ikorb/gcvideo/(threads)

Thread 2 (2016-08-17):

DOL-101

ManuPerezBelmonte, 2016-08-17:
Sorry for contacting you that way, I didn't another way how to contact you.
I've been checking everything in your repo and first of all, it's genius. However I saw that it's not possible to use a DOL-101 version, did you find something new regarding this model? or it was impossible for you to try it? As the boards come already programmed I don't know if I should still need to program something or even if there is going to be a way to use it on the DOL-101.

ikorb, 2016-08-17:
Sorry for hiding the 98 copies of my email address in the repository so well.

The DOL-101 is missing the external digital video port, but I suspect that all required signals are still present on the board. You would need to wire the FPGA board directly to the AV encoder chip and find a different source for the 54MHz clock signal somewhere on the board - I heard that it exists, but I don't know where.

Closed 2016-08-17.

Thread 3 (2016-09-20):

Unable to access OSD

bsbarham, 2016-09-20:
I purchased a Pluto-IIx XC3S200 HDMI board pre flashed with gcvideo 2.2. I am displaying video just fine, but the designated button combo is not bringing up the OSD. I have checked and re-checked the controller solder point and everything looks good. When contacting the supplier they are suggesting an issue with gcvideo 2.2 (see forum post below). Has something changed with the install? I am also including a picture of the controller solder point for verification. I apologize for the quality.

Thank you,

KNJN forum post: http://www.knjn.com/phpbb/viewforum.php?f=2
Youtube thread with others with same issue: https://www.youtube.com/watch?v=5Hw_XQdugI4

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

ikorb, 2016-09-20:
As far as I can tell yet, it is an issue where the OSD CPU crashes during initialisation and it does not appear with every install - e.g. my development setup was unaffected, so I did not catch it before release. I finally managed to reproduce it yesterday and I'm working on a fix.

ikorb, 2016-09-20:
Found it, should be fixed in version 2.3

Closed 2016-09-20.

Thread 5 (2016-12-31):

Controller not working

rimsky82, 2016-12-31:
Everything seems to be installed correctly, as the video through HDMI looks great (Pluto board from knjn.com).  However, when I have 94 connected for the controller, the controller in port 1 doesn't work at all.  If I disconnect 94, controller port 1 works again.

I have soldered to this point twice, both times with the same result.  Any ideas?

ikorb, 2016-12-31:
Likely a wrong bitstream or the wrong pin on the FPGA side - most FPGA pins have pullups or pulldowns enabled and these overpower the controller signal on the Gamecube side.

rimsky82, 2017-01-15:
Yup, it was my fault.  Had 94 and ground switched.  All hooked up and enjoying HD goodness.

Closed 2016-12-31.

Thread 6 (2017-01-04):

No native 480p ?

idtjes3, 2017-01-04:
Hello. I purchased a Pluto-II ( Rev C) with gcvideo installed. Everything appears to be working fine (audio, 480i video+LD, OSD), but I cannot get native 480p games to display in progressive scan. Games that require 'B' do not respond to the command and games that have the option in the menus are greyed out. Have test on 3 different TVs with 2 different HDMI cables same results. I have also tried reflashing the board with the latest firmware. Thoughts on what to check?

ikorb, 2017-01-04:
There are two likely issues:
1) Other Settings -> Allow 480p mode is set to "no"
2) The wiring for the cable detect pin is missing or incorrect.

idtjes3, 2017-01-04:
Hello thanks for your response. I'm pretty sure 'allow 480p mode' is still on since the FAQ says to leave it alone. I will re double check the cable detect pin but last I checked with the multimeter I was getting a good connection. Is there a voltage range or anything like that on this pin I can use to verify a proper signal from the cube?

ikorb, 2017-01-04:
You should see around 3.3V on that pin, coming from the FPGA.

Closed 2017-01-04.

Thread 7 (2017-05-18):

HDMI-CEC support?

mkopec, 2017-05-18:
Hello,

Do you think it would be possible to add HDMI-CEC support? Adding it would enable using the TV's remote to control the OSD, which would be especially useful for external installations.

ikorb, 2017-05-18:
Technically it would be possible, but not on the current hardware platforms because the pin needed for CEC is not connected there. Also, as far as I know CEC has some electrical requirements that cannot be met with just a bare FPGA pin, so just soldering a wire to connect it would not be sufficient.

As far as I know there are some microcontrollers with CEC hardware support (e.g. some STM32F0/F1 chips), using one as a gateway between CEC and the FPGA might be possible. Unfortunately, I'm currently busy with other projects and do not have time to build something like this myself.

HACKER-3000, 2018-10-14:
do it urself and make a pull req!

GizmoTheGreen, 2020-01-14:
still kinda hoping for this. even if I'll have to solder in an STM32f board to the PlutoII as middleman

feenor, 2021-01-25:
Assuming ALLM is handled by CEC, that would be another great reason to support it. GCVideo devices would be ahead of the PS5 if they did ALLM.

Thread 9 (2017-05-28):

Sound?

Eire05, 2017-05-28:
Hello, Firstly thank you for the guide ... amazing. I followed it and have video working no problem. My issue is with sound and i do have enhanced dvi mode turned on...i notice that there is not connections for sound in the guide (except SPDIF) is there something i have missed. Really appreciate your help..Thanks

ikorb, 2017-05-28:
Did you connect the LRCK, AData abd BCLK signals?

Eire05, 2017-05-28:
Thank you so much for getting back to me. Yes I connected them to 98, 3, 4
as per the diagram......would that be where the issue is? I have it all hot
glued :(

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

ikorb, 2017-05-28:
These three signals are for sound, your description suggested to me that you might not have connected them.

If you have verified these three connections to be correct, try a different display and if possible, also try to check if you get sound via SPDIF.

Hot gluing stuff before it is verified working is usually not a good idea . You could try to apply some alcohol to the blobs of hot glue, it reduces the strength of the bond between the glue and the surface.

Eire05, 2017-05-28:
Thank you I'm going to check those points again to be sure

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

thekevbot, 2017-10-22:
I'm having the same problem – @Eire05 were your OSD settings not being saved too? Did you end up getting it working?

Eire05, 2017-10-22:
Hi Kevin. I did get it working after a third attempt. I recommend using
thicker 22-26 gauge wire and really check every single point five times :)
I was doing two backwards but works perfectly now

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

thekevbot, 2017-10-22:
Thanks @Eire05 – I got it working too. Used 24awg, solid wire.

MadnessUNC, 2017-12-21:
I’m having no sound issues. I did originally have 21 to 3 and 22 to 4 backwards, but it’s fixed now and still no sound. I’m using a pretty thick solid wire, but probably not quite 24 gauge. Could a thicker gauge possibly fix my issue?

MadnessUNC, 2017-12-21:
Now I’m more confused. I get sound when dvi is turned on. Am I missing something? There is not a lot of details on this. Any clarification is appreciated.

Eire05, 2017-12-21:
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
Ok so can’t think of the name right now but there is a setting you need to
have on in order for sound to be pushed through. Can anyone else think of
what that option is called? Maybe that will help

ikorb, 2017-12-21:
The setting is called "Enhanced DVI" and it's off by default because it is easier to turn on when you have no sound than to turn it off when you have no picture (which can happen with some displays).

Eire05, 2017-12-21:
Yep that’s it Igor

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

Eire05, 2017-12-21:
Fantastic glad it got you up and running

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

Closed 2017-12-21.

Thread 10 (2017-06-16):

How to wire a SCART connector

robcross, 2017-06-16:
I see that the RGB lines are directly from the DAC. Do I need to put 330 uF caps in the SCART head? Do I any other components in the SCART head for proper signals?

robcross, 2017-06-16:
For more clarification, I plan to build the gcvideo_lite_09 board and I would like to ensure the specifications are correct for the cable I want to purchase from retro_console_accessories.

ikorb, 2017-06-16:
The DAC outputs the usual 0.7Vpp into a 75 ohm impedance input with no DC offset (so no capacitors). The H and V sync outputs are 3V LVCMOS outputs, CSync is the same but with a 100 ohm series resistor and it should be able to drive a standard 75-ohm video input.

robcross, 2017-06-16:
Thank you! I'm still learning these things :+1:

robcross, 2017-06-27:
Hi @ikorb, I just wanted to say thanks! I just installed my board today and it works like a charm. Beautiful RGB output without breaking the bank!

Closed 2017-06-16.

Thread 11 (2017-10-12):

audio lag

Rx-R, 2017-10-12:
Hi, I installed a plutoIIx with 2.3 installed.  I am experiencing audio lag after a certain amount of time of gameplay.  upwards of 2 seconds delay.  I can then turn off enhanced dvi mode then turn it back on and the sound is in sync.  after about 10-20 min of gameplay the lag slowly creeps back again.  Is there something I can check or fix with my install?  I verified it is not the gamecube as when I run audio out of the analog port it is fine.  thanks for your help and your work.

ikorb, 2017-10-12:
The Gamecube has a slightly non-standard audio sample rate. GCVideo-DVI passes it to the display as-is, any audio lag you encounter comes from the display side. There isn't enough space left in the FPGA to properly resample the audio and just dropping/inserting samples creates an audible distortion.

Your install should be ok. As far as I know the slightly-off sample rate should still (barely) be within tolerances, but it seems you have a device that just doesn't like it.

Rx-R, 2017-10-13:
thanks for the explanation

Closed 2017-10-13.

Thread 12 (2017-10-16):

Board connected, but no video (solid red light) [Solved]

thekevbot, 2017-10-16:
I'm using a board from KNJN (Item 6117 from http://www.knjn.com/ShopBoards_RS232_Parallel.html) and have everything wired up according to the README, but I'm not getting any video signal when hooked up to my TV.

I've tried it with the 100 ohm resistor, and straight wired, but no dice. The red LEDs are not flashing, but they stay on solid – is that an indicator of something?

I've checked and double checked all the pins, and I've checked each for continuity, but still can't my TV to recognize the Gamecube. Anyone have any ideas of what to try next?

ikorb, 2017-10-16:
Non-flashing lights are an indication that something is wrong, for example the FPGA not completing its startup or not receiving all of the required signals from the Gamecube. In either case, the TV would not receive a signal.

thekevbot, 2017-10-16:
Got it, thanks for the reply! What should I check besides making sure all my connections are good and nothing is shorting out? Is it likely that it could be a bad board?

Fluoxi, 2017-10-18:
Hello, I am having the same problem! I don't know about you thekevbot but I am a total noob when it comes to soldering (I bought everything I needed just for this project). As of now my GC is naked, so no cover and even the cd loader thingie is off. I can still turn on the system and everything seems to power up. Also note I have not soldered the controller cable yet.

One thing that pops into my head might be the cables that I used to wire it all. They are 30 gauge (0,25mm) with loose strands of copper. While stripping I often had lose stray wires coming off, about 1 to 3. Is this a concern?

ikorb, 2017-10-18:
If you have some way of flashing the boards with 2.4, do so. It changes the LED blinking pattern to make it easier to differentiate between a few possible problems.

thekevbot, 2017-10-18:
Spoke with KNJN's support (they're super responsive and helpful btw) and they've been helping me with some troubleshooting. Basically, when you supply power with nothing else wired up, 1 LED should light up for 2 seconds and then turn off like this https://www.youtube.com/watch?v=CGaOvrQgl5A

This means the boot-PROM is working correctly and something else is the issue. The stranded wire can work, but it's harder to work with.

Make sure you don't have any shorts before powering on if you leave your wires connected to the GC digital port.

Fluoxi, 2017-10-18:
Funny I contacted the same people and they told me the exact same thing just a few minutes ago...

Fluoxi, 2017-10-19:
No red light using your method. I bought some hardwire today going to try that out.

Fluoxi, 2017-10-19:
No success, same issue. I did however notice a second red light that turns on when a hdmi cable is connected. Even the tv recognizes something but tells me there's no signal.

Any progress on your end?

thekevbot, 2017-10-21:
No progress here yet either. I'm going to try with some solid wire, without desoldering the digital port first and see how that goes.

thekevbot, 2017-10-22:
Alright, so I switched over to a solid wire, and wired everything really carefully... it works! Well, it _worked_... at some point during testing and putting the cube back together, I seem to have lost sound.

Also, the OSD doesn't seem to be able to save settings after turning off the gc. Anyone know why that might not be working?

thekevbot, 2017-10-22:
Success!  (sorry for all the posting, but hopefully this will help others). [This issue](https://github.com/ikorb/gcvideo/issues/9) suggested that one of the sound signal wires wasn't connected, and sure enough, one wasn't.

Okay, so my findings:

- I had issues, each time I tried using stranded wire. It's just too easy to create shorts.
- I used solid hookup wire, 24 gauge. It works, but it's a bit stiff. I'm going to try 28 gauge on the next one.
- Test your connections with the DVD drive disconnected. If it works, only THEN hotglue your connections, and then put the drive back on. I tested again at this point to make sure I didn't jangle any connections.

Also, for a nice clean install, there's a 3d printed mount available and it works GREAT. [Link to the file here](https://www.thingiverse.com/thing:2332094). I had mine printed at Shapeways.

Fluoxi, 2017-10-22:
Do you have several motherboards? In the video it shows the digital port removed. Did you not remove the digital port on your successful try?

thekevbot, 2017-10-22:
No, I used the same mobo and the port is desoldered.

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

Closed 2017-12-21.

Thread 14 (2017-12-29):

Video but no sound.

seniorcelica, 2017-12-29:
I have a picture and it looks amazing!   But no audio.  I've turned dvi on and tried the origina svideo and av cord.  I did have sound before the install.  Thanks in advance :)

MadnessUNC, 2018-02-16:
Did you figure it out? Make sure 21 -> 3 and 22-> 4 which is kind of a curve ball vs how the rest of the numbering goes

seniorcelica, 2018-02-17:
Ya.  Turns out I had a defective soldering iron and burnt traces....  sounds noobish and kind is but ruined the the hd port.  Might do a trace repair but can get another for like 30.  So installed the Pluto in another gc2 and worked fine.  Got 2 more tonight in the mail.  And have a new iron lol

Sent from my Samsung Galaxy smartphone.

-------- Original message --------
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

MadnessUNC, 2018-02-17:
I know for myself that the traces under the digital port are very delicate. Live and learn! Also, “repair” gc’s are typically $15 and usually just need cleaning. It’s a gamble though

Thread 15 (2018-01-23):

Get the gcvideo-dvi-p2xh-gc-2.3.bit

Hawkeye92, 2018-01-23:
Hi, firstly congratulation for your great job

I receive my Pluto board but I cannot get it to work.
All my connections are goods, double checked.
When I turn on the console, one LED blink but the another LED still ON without any blinking, so in your readme you say that the board is probably not programmed.
Maybe my board isn't programmed, so I would like to get the file "gcvideo-dvi-p2xh-gc-2.3.bit" but I can't find it, there is no bin subdirectory.
Can you upload it ?

ikorb, 2018-01-23:
https://github.com/ikorb/gcvideo/releases

Closed 2018-01-23.

Thread 16 (2018-03-11):

CDK3404 Has Been Discontinued

CryCic4da, 2018-03-11:
The CDK3404 has been discontinued and is no longer available. What are the alternatives and will there be any updates to the GCVideo Lite files in terms of updated PCB with the replacement part in the BOM?

ikorb, 2018-03-11:
I have not investigated alternative DACs at this point.

Closed 2018-03-11.

Thread 23 (2019-12-22):

DDC resistor

jeanh17, 2019-12-22:
The latest Pluto-IIx HDMI has the 100ohm resistor to power the DDC HDMI line.
https://www.knjn.com/docs/Pluto-IIx%20HDMI%20rev.%20E.pdf

The description could be updated to mention it and avoid confusion.

ikorb, 2019-12-22:
Thanks, I did not know that. I'll add a link to that document in the manual.

Closed 2019-12-22.

Thread 24 (2020-01-12):

FPGAconf does not support .bin files.

sbagneris, 2020-01-12:
FPGAconf explicitly wants .bit files to flash firmware onto a Pluto II board. This is no longer provided with the 3.0 release.

It is possible to rename the .bin file file to .bit file and FPGAconf will happily (foolishly?) flash the file onto the board but when booting the picture is now black and white and the following message is displayed:

"!!! Updater hardware ID is invalid !!!"
"--> YOU must choose the correct ID <--"
"Main firmware is missing"

A rotating cursor is displayed bellow and when pressing the z-button a hex dump of the ROM is displayed that can be navigated up and down the memory addresses.

Long live GCVideo!

ikorb, 2020-01-12:
It seems that FPGAconf is trying to remove a header from the "bitstream" file to get to the actual contents and the part it removed it small enough that the FPGA still boots. However, the flasher that starts first thinks that the main firmware is bad and starts its recovery mode instead of booting the main firmware.

Good thing I added that memory hex viewer for diagnosing problems like this. =) Run it, hit the X button (should jump to address 30000), take a picture, hit left on the D-Pad once (shoudl jump to 2ff80) and take another picture. With a bit of luck that should be enough to figure out how to build a pseudo .bit file that can be flashed with FPGAconf.

sbagneris, 2020-01-12:
You bet!

Note to anyone else reading that the Pluto board is not bricked when doing this. One can easily revert to 2.4d without harm.

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

ikorb, 2020-01-12:
Thanks!

Unfortunately FPGAconf did something completely against my expectations - instead of dropping the (nonexistant) .bit header, it added something, which shifts everything backwards instead of forwards. Could you take another screenshot from address 0?

sbagneris, 2020-01-12:
No problem.

I included the first two pages.

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

ikorb, 2020-01-12:
Thanks. The file below might work with FPGAconf. If it doesn't, I'll probably need a few days to dig out my own hardware to figure out a workaround.

[gcvideo-dvi-3.0-p2xhgc-fpgaconf.zip](https://github.com/ikorb/gcvideo/files/4051502/gcvideo-dvi-3.0-p2xhgc-fpgaconf.zip)

sbagneris, 2020-01-12:
Success!

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

ikorb, 2020-01-12:
Nice! Thanks for helping figure this out, I'll add a link to the release notes.

P2XH Wii fake bitstream in case someone actually uses it:
[gcvideo-dvi-3.0-p2xhwii-fpgaconf.zip](https://github.com/ikorb/gcvideo/files/4051549/gcvideo-dvi-3.0-p2xhwii-fpgaconf.zip)

sbagneris, 2020-01-12:
Thank you *very much*. I would have given you two thumbs up but I can’t quite levitate my camera yet. Most thing at first glance seems to function just fine. I’m excited for the built in firmware upgrade.

ikorb, 2020-01-12:
Actually the system is resilient enought that you could have used the 3.0 updater to install a working main firmware by manually selecting the correct board ID - but since you appeared to be a willing victim, I preferred to work out the problem so others can avoid it completely.

sbagneris, 2020-01-12:
By all means!

Tazberry, 2020-01-13:
@sbagneris what are you using to update ur pluto?

sbagneris, 2020-01-13:
I'm using the basic TXDI header from KNJN along with FPGAconf software that should have come along your purchase of the Pluto board. A judicious search online should net you a downloadable package for FPGAconf if you have lost the files. (it is not available on the KNJN website for some reason) or email KNJN for a link.

Tazberry, 2020-01-13:
@sbagneris Is it possible I can get a link to all this. Doing this for the first time.

GizmoTheGreen, 2020-01-14:
what are you using to connect to the TXDI header if you don't mind me asking? I've got a Sparkfun FTDI basic. put the TX in invert and been emailing KNJN. checking voltages on the TX RX lines etc but can't for the love of me program the thing.
it just times out! (still on 2.4c)

sbagneris, 2020-01-14:
I use a bog standard USB to serial adapter and I plug the TXDI header right into it.
This looks pretty identical to what I have:
https://www.amazon.com/Tripp-Lite-Keyspan-High-Speed-USA-19HS/dp/B0000VYJRY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

The specific TXDI header I use is the plain jane one without the RS232 chip built in ($6.95)
https://www.knjn.com/ShopAdapterBoardsTXDI.html

GizmoTheGreen, 2020-01-14:
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

thanks for your input. I've read that PDF and referenced it when I hooked up the FTDI.
as I mentioned I've been emailing KNJN and they say it looks correct but have no idea why I can't program the board.

I should probably make a new "issue" to try and get help with this here but for now I'll just share the pictures.

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

Closed 2020-01-12.

Thread 25 (2020-01-13):

3.0 does not appear to save settings

sbagneris, 2020-01-13:
I'm likely doing something wrong but it appears setting changes do not survive a power cycle of the console.

This happens of course despite explicitly calling "save configuration" in the menu.

The specific setting I'm attempting to make stick is the "Enhanced DVI" mode so that digital audio streams through the "HDMI" instead of having to use the analog out.

Not a big deal.

ikorb, 2020-01-13:
Actually it is a big deal because it could erase parts of the bitstream from the flash... Fixed in 3.0a.

sbagneris, 2020-01-13:
oooooh boy... and here I was mashing that "save configuration" button... Ignorance sometimes *isn't* bliss!
Thanks again for the lightning fixes!

GCVideo still kicking butts and taking names.

sbagneris, 2020-01-14:
Ok tried this updater thing! It works beautifully and all issues are confirmed fixed.

Launch straight from SWISS!
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

On reboot presented with pretty clear instructions.
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

Time to flash!
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

Here we go...
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

Flashing...
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

Auto reboot is nice...
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

I suppose you see this again if you want to flash it again on reboot?
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

Great success!
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

ikorb, 2020-01-14:
There is no feedback path from GCVideo back to the Gamecube that works on all hardware variations, so the updater doesn't know that it can exit and you get the noise screen back after GCVideo reboots.

dropdennisdead, 2025-01-23:
Hi, i have the same Problem as @sbagneris. When i start the gamecube i have no sound. when i turn on the enhanced dvi mode in the settings i get a sound but when i restart the console the settings are not saved. Do you have a version of the GC Video 3.1 where the enhanced dvi mode is always on? Thanks in advance!

Greetings
Dennis

ikorb, 2025-01-23:
The "Save does not save" bus has been fixed a few years ago already. Since you did not mention anything about trying to save settings, I'm going to assume that you forgot to do so and advise you to try that.

Closed 2020-01-13.

Thread 26 (2020-01-14):

Booting main firmware failed

Xaranar, 2020-01-14:
Just flashed this onto my Wii using the specified fpgaconf file, and it boots into black and white with the error message "Booting main firmware failed!"

ikorb, 2020-01-14:
Ugh, I hate FPGAconf...

Can you please start the flash memory viewer by hitting the Z button on a Gamecube controller and send me a picture of the screen showing the hex dump starting at address 00000?

Xaranar, 2020-01-14:
I would love to, only hitting Z does nothing, nor does hitting any other button on the controller.

Xaranar, 2020-01-14:
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
This is all I get, and no buttons change the OSD.

ikorb, 2020-01-14:
Ah! Yes, that's the one message in the code where I don't check the gamepad.

Unfortunately, I currently do not have an idea why this fails for you.

Xaranar, 2020-01-14:
Is there any chance you can link me to the version 3.0 you were able to get loading, and then I can update to 3.0a via the homebrew app?

Xaranar, 2020-01-14:
How frustrating.  Could you perhaps recommend a better way of programming if FPGAconf is so awful?

ikorb, 2020-01-14:
I'm not yet sure if the issue is actually caused by FPGAconf or something else - if you reach that screen, the flash update tool has verified the presence and correctness of the main firmware, but the FPGA refuses to accept the reboot command. I'm not sure yet how this can happen.

Xaranar, 2020-01-14:
Interesting.  Well, let me know if there is anything else I can do.

ikorb, 2020-01-14:
Give me a bit of time to think about it. I might ask you to flash one or more test builds that have additional debug messages, but I need to figure out what information I need to gather that way.

Xaranar, 2020-01-14:
Alrighty, well I'm happy to help in any way I can.

kimbapslice, 2020-01-15:
Hello, I am getting this issue as well tyring to flash 3.0a into a wiidual v1.1 board with what appears to be a MXIC 25L4006E chip. I have gotten to the flash memory viewer dump screen. I will take pictures of that after work.

kimbapslice, 2020-01-15:
I used the gcvideo wii dual bin build and a CH341A programmer.

kimbapslice, 2020-01-15:
I had to hold down the IR setup button on the wiidual while powering on to get to the firmware screen to get the hex dump to appear.

kimbapslice, 2020-01-15:
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

kimbapslice, 2020-01-15:
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

Shiftone, 2020-01-15:
Are you using firmware from this repo or the ones Dan posted? http://dansprojects.com/firmware/WiiDual/

kimbapslice, 2020-01-15:
This is a flash of this repo's 3.0a bin for the Wii dual.
Having said that, I have the same issue after flashing Dan's 3.0a version as well.

kimbapslice, 2020-01-15:
I can/have tried flashing back Dan's version of 2.4.c2 and the Wii dual works normally after that.

ikorb, 2020-01-15:
@kimbapslice: Thanks for the screenshots, it looks like the flash content is correct. Since you use a Wii-Dual board and have the same problem as Xaranar, I fear it may be a Wii-specific problem.

Unfortunately, I don't have a dismantled Wii available for testing right now, so for now the only solution I can offer is to re-flash with a previous version.

I'll try to set up a test system to figure this problem out as soon as possible, but please remember that this is just a hobby and free time is limited...

kimbapslice, 2020-01-15:
Hi ikorb,
I completely understand. Thank you for your continued great work on the new firmware feature set! My Carby and GCdual are happily running 3.0a. My technical skills end at just about here, so I will flash back to the working 2.4c2 version and patiently await for updates. The wii is such a pain to take apart with all the tiny screws. Please let me know if you need anything else such as more flash dump screens. Thanks again!

ikorb, 2020-01-15:
Just had a random idea what might cause the problem, test build attached. I think the chance of actually solving the problem that way is pretty low though.

[gcvideo-TEST-dual-wii.zip](https://github.com/ikorb/gcvideo/files/4068297/gcvideo-TEST-dual-wii.zip)
[gcvideo-TEST-p2xh-wii-fpgaconf.zip](https://github.com/ikorb/gcvideo/files/4068298/gcvideo-TEST-p2xh-wii-fpgaconf.zip)

kimbapslice, 2020-01-16:
I tried your test bin with the same failed to boot firmware error. Please see the attached dump screens.

kimbapslice, 2020-01-16:
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

Xaranar, 2020-01-16:
Only just seen this, I'm going to try your test this evening when I get home from work, although I'm not holding my breath since kimbapslice is still experiencing issues.  Thanks for all of your work on this, by the way, I know it's just a hobby for you and you're giving up your free time to help us, we really appreciate it.

Xaranar, 2020-01-16:
Okay, can confirm that I'm in the same position as kimbapslice, I have the exact same error message as was originally displayed to me.

ikorb, 2020-01-18:
Ok, I've got a Wii to develop with once more - (un)fortunately it boots the standard 3.0a release binaries without any issue, so it looks like more remote debugging for now.

Attached below is a new test build that should show various register contents for 30s before it attempts to boot the main firmware. It will most likely show the same error message as before, this is just for getting more data for diagnosis. Of course if it does happen to boot into the main firmware after the 30s delay, that would also be a very interesting result.

Please test and take a picture of the register dump - should display "Booting in XX second(s)" and something like "gen1_boot XXXX", "gen1 XXXX gen2 YYYY mode ZZZZ" and more below that.

[gcvideo-TEST-dual-wii.zip](https://github.com/ikorb/gcvideo/files/4081808/gcvideo-TEST-dual-wii.zip)
[gcvideo-TEST-p2xh-wii.zip](https://github.com/ikorb/gcvideo/files/4081809/gcvideo-TEST-p2xh-wii.zip)

kimbapslice, 2020-01-18:
Still failed. Please see attached screenshots. It's a black Wii with GameCube ports, board revision CS 60. I have the basic priiloader and Homebrew channel installed. Would that cause an issue? Again 2.4 versions work even now if I flash it.
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

ikorb, 2020-01-19:
Thanks!

The software on your Wii should not matter, it's purely an issue on the GCVideo side. In the FPGA there is a hardware module that is used to reboot the chip into a different configuration and judging from your screenshots it completely refuses to talk with my software. Unfortunately, that module is also very under-documented by the chip manufacturer and rarely used by other projects.

Another attempt attached, not sure yet what to try if that one also doesn't do anything.

(note for my own reference: primary DCM, Lck-Cycle 6, ConfigRate 1)

kimbapslice, 2020-01-19:
Yes, it booted into this. Weird colors though even after rebooting.
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

kimbapslice, 2020-01-19:
I can access the full menu with controller and ir remote.
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

ikorb, 2020-01-19:
Yay! The inverted colors are due to a change I forgot to add, that should be fixed in the test builds below.

This time there are three test builds, each with just a single change from the previous one. I hope it can be isolated to just a single change - if it happens to be in TEST2, I'll need you to try a few more builds before I can release a fixed version because that one really slows down the boot process.

(sorry, no p2xh builds this time)

[gcvideo-TEST1-dual-wii.zip](https://github.com/ikorb/gcvideo/files/4082596/gcvideo-TEST1-dual-wii.zip)
[gcvideo-TEST2-dual-wii.zip](https://github.com/ikorb/gcvideo/files/4082597/gcvideo-TEST2-dual-wii.zip)
[gcvideo-TEST3-dual-wii.zip](https://github.com/ikorb/gcvideo/files/4082598/gcvideo-TEST3-dual-wii.zip)

kimbapslice, 2020-01-19:
Test1: nothing on the screen, does not boot, black screen. Blue diagnostic wiidual light blinks slowly.

Test2: boots, full colors, full menu
Test3: binary seems to be identical to Test2. Menu also says test2.
Screenshots are from test 2
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

ikorb, 2020-01-19:
The test3 failure was because I messed up during the manual build process - but since test2 works that's not a problem.

Attached is a version that increases boot speed again, but not to the original level. 3.0 was released with speed 17, the test2 build was 1 and the attached one is 10. If it works, I'll create a 3.0b release using that setting later today.

[gcvideo-TEST_C10-dual-wii.zip](https://github.com/ikorb/gcvideo/files/4082833/gcvideo-TEST_C10-dual-wii.zip)

kimbapslice, 2020-01-19:
Test C10: black screen, doesn't boot, wiidual diagnostic light blinks slowly. Verified data on chip vs binary.

kimbapslice, 2020-01-19:
Test C10:
At first black screen, doesn't boot, wiidual diagnostic light blinks slowly. Verified data on chip vs binary.

Then I flashed with test2, black screen blue blinking light. Verified data.

Then I flashed with "TEST3" binary, verified, Booted into full, correct color menu as before.

Flashed C10 again, verified data. Now "failed to boot into main firmware". Screenshots below are from C10 second flash.
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

kimbapslice, 2020-01-19:
Earlier I did flash test1 twice as well. I have been trying to flash a build multiple times to exclude flashing/soldering errors.

Xaranar, 2020-01-19:
Looking promising, do you need me to test your earlier build of p2xh or do you have all the information you need from the wii dual builds?

ikorb, 2020-01-19:
@Xaranar: It would be helpful if you could test the p2xh build from [this post](https://github.com/ikorb/gcvideo/issues/26#issuecomment-575956426)

@kimbapslice: Yay, Heisenbugs. The attached X1 build should in theory be the same as the three-things-changed build linked previously, but it also includes the inverted color fix. The slow blinking is normal, I changed the blinking pattern (again...) to free up a bit of FPGA resources for the color fix.

[gcvideo-TEST_X1-dual-wii.zip](https://github.com/ikorb/gcvideo/files/4083351/gcvideo-TEST_X1-dual-wii.zip)

kimbapslice, 2020-01-19:
X1 success! Booted into full color menu! Woohoo!
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

ikorb, 2020-01-19:
Ok, I guess I should give up on the fast boot process for the Wii then. I have an idea why it works for me but not you, but I'm not going to tear down another Wii just to measure the power-up behaviour of a single signal.

Will build release 3.0b now, including all fixes from X1.

kimbapslice, 2020-01-19:
Thank you so much for your time and work! Maybe I can try the dol update process from the X1 test version?

ikorb, 2020-01-19:
You could, but then you would still have the countdown screen with the register dumps because the DOL update only updates the main firmware and not the flasher.

ikorb, 2020-01-19:
3.0b release is out, I really really really hope that this is now fixed.

kimbapslice, 2020-01-19:
Yes I was able to flash 3.0b and it booted successfully. So at this point any issues functionality wise is updatable via the dol? I will put the Wii together now :) thank you!

ikorb, 2020-01-19:
Yes, it should be updateable using the updater.dol now. Feel free to try it, the system won't prevent you from installing the same version again or even downgrading.

Closed 2020-01-19.

Thread 28 (2020-01-20):

Add GCPlug hardware target

Shiftone, 2020-01-20:
Just popping this here so it doesn't fall off the radar. I know Dan was going to get the constraints file over to you for the GCPlug.

ikorb, 2020-01-30:
Would you be able and willing to test a GCPlug build (since I don't have one)?

Shiftone, 2020-01-30:
Yes and yes. I have a unit and programmer on hand.

ikorb, 2020-01-30:
Great! A test build is attached.

A rough guide to testing everything:
* Does it display a picture at all?
* Are the colors correct or are any of the three channels (R/G/B) inverted?
* Hold down the button to bring up the IR config menu and try to set up a remote
* Turn on enhanced DVI mode in the menu and check if audio works on both channels (this will likely fail if one of the three color channels is inverted)
* Store settings
* Try to install a firmware update (run the included .dol file and use About->Firmware update to start the flasher)
* If the flasher does not detect any available update, hit right on the IR remote to enter diagnostics mode. If everything is fine, it should say that it has detected the test data and show "None" for all three tests.

Shiftone, 2020-01-31:
- Does it display a picture at all?
Yes
- Are the colors correct or are any of the three channels (R/G/B) inverted?
No
- Hold down the button to bring up the IR config menu and try to set up a remote
Working
- Turn on enhanced DVI mode in the menu and check if audio works on both channels (this will likely fail if one of the three color channels is inverted)
Working
- Store settings
Working
- Try to install a firmware update (run the included .dol file and use About->Firmware update to start the flasher)
Shows Plug1 as current and update version. Completes upgrade process, restarts and works
- If the flasher does not detect any available update, hit right on the IR remote to enter diagnostics mode. If everything is fine, it should say that it has detected the test data and show "None" for all three tests.
N/A

ikorb, 2020-01-31:
Thanks, looks perfect =) Will officially land in the next release, probably this weekend.

Shiftone, 2020-01-31:
perfect - glad I could help and thank you for your work on this project

Closed 2020-01-31.

Thread 30 (2020-01-22):

WiiDual Analog RGB Corruption

PolydactylCat, 2020-01-22:
I flashed the 3.0b firmware you posted for Wii and everything seems to be working alright except for RGB analog output.  YPbPr is fine and HDMI output works fine.  Going back to Dan's 2.4c.2 fixed the problem.  I'm using a RetroAccess Wii SCART cable with sync carried over data pin 15 running through an OSSC.
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

ikorb, 2020-01-22:
Oh wow, that looks interesting. Could you try the attached firmware version? It will have swapped color channels in RGB mode, but the interesting part to me is if the image still has these jagged stripes across it.

[updater-wii-TRGB-dual-wii.zip](https://github.com/ikorb/gcvideo/files/4100286/updater-wii-TRGB-dual-wii.zip)
[gcvideo-TRGB-dual-wii.zip](https://github.com/ikorb/gcvideo/files/4100289/gcvideo-TRGB-dual-wii.zip)

PolydactylCat, 2020-01-23:
It looks pretty much the same.  When I switch over to RGsB, it seems to decrease the double image ghosting, but the colors are still wrong.  Looking at a mismatched YPbPr with the OSSC on RGBS- it looks like the jagged lines are just exaggerations of the color banding in the homebrew launcher background.
On a side note- I'm also having trouble with the .dol updater.  It holds on the spinning asterix, but doesn't recognize the new FW.  Once when I ran the program, it flashed text at the bottom of the screen too fast to read, and resynched the video every 15 seconds or so, but every other time it just hanged.
Could this just be a manifestation of my subpar soldering causing minor graphical hiccups amplified by the new FW?
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

ikorb, 2020-01-23:
The updater.dol way of updating the firmware needs all bits of video data working correctly, so if you have a dodgy connection somewhere that would explain why the update is not recognized. I don't think it would create RGB-only video corruption though.

Thanks for the pictures, I need to run a few tests before I can suggest a next step.

PolydactylCat, 2020-01-23:
I hate to to pile on, but I'm getting similar findings on the GCDual side.  Analog RGB has a red film over it that doesn't show up too great in pics and the firmware updater won't work.  As with the Wii, YPbPr and HDMI RGB work great.  Also the update .dol is invalid from a GCLoader, but it will run from a Gecko or SP2SD2.
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

PolydactylCat, 2020-01-23:
Okay, I had the "Digital color format" set wrong, don't mind me.  The GC updater still won't acknowledge the update file though.  Thank you kindly for all the time and work you put into the community.

ikorb, 2020-01-25:
I think the HBC banding in your picture looks stronger (wider bands) than the banding I see in my own HBC install, which could point to a missing/shorted/stuck video data bit from your console - that would also explain why the updater can't find an update or acts erratically.

I'm less sure that this can explain the RGB-only banding on the analog output though. This could be an issue on your WiiDual board or an error in the pin assignments I used. This can probably be cleared up when citrus3000psi is back as he said he'd snd me the data needed to build firmware for all of his PCB variants.

On the positive side, your problem has inspired me to add a diagnostic mode to the firmware flasher which tries to detect if all video data lines are are connected correctly. It should be in 3.0d or 3.1 as I want to release 3.0c with another important fix first.

PolydactylCat, 2020-01-25:
Sounds good.  That would be an awesome feature for hobbyists who can have a successful-appearing install that isn't necessarily a successful install.  I've reinspected my install and touched up some of the solder points but it didn't seem to fix the analog output, and the installers won't work on GCDual or WiiDual.  Thanks so much for all of your work to create and improve this project.  Take your time to implement a fix and let me know of there's anything you I can test in the meantime while my Wii's open.

________________________________
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

ikorb, 2020-01-25:
There is one more thing you could do to allow a bit more insight into the analog problem: Run the [240p test suite](https://sourceforge.net/projects/testsuite240p/) on your Wii with a 3.0 firmware and take a picture of the [color bars pattern](http://junkerhq.net/xrgb/index.php?title=240p_test_suite#Color_Bars) on the analog output in both RGB and YPbPr mode.

PolydactylCat, 2020-01-25:
I hadn't tried before, but it turns out I can't install the 3.0a firmware due to the "Booting main firmware failed" error.  These were taken on 3.0b.
Wii (RGB)  ->  OSSC (RGBS)   ->  TV
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

Wii (YPbPr)  ->  OSSC (YPbPr)   ->  TV
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

Wii (YPbPr)  ->  OSSC (RGBS)   ->  TV
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

Wii (HDMI)  ->  Receiver (Reports as RGB 4:4:4)  ->  TV
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

Leafeon412, 2020-01-28:
Hello, I am running a WiiDual with version 3.0c installed and experiencing the same issue. Using an OSSC with Retro Access RGB scart cable. Let me know if I can provide any help testing firmware.

PolydactylCat, 2020-02-03:
New builds, new developments.
I manually flashed Dan's 3.0c build for WiiDual1.1.  It cleaned up the RGB corruption, and also is able to recognize his updater.dol file, but it's still doesn't recognize a compatible firmware file when I tried flashing the updater.dol for 3.0d from here.  For the time being, I'll just update the Wii with firmware from his site.

It's still not quite perfect because either the color channels are swapped on analog RGB out or I've messed up a setting.  YPbPr remains solid.
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

PolydactylCat, 2020-02-04:
One final addition:  I flashed 3.0d do see what happens and it has the same problems with analog RGB.  Updater.dol doesn't work and gives the following in diagnostic mode:
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
I'll leave my Wii open for a few more days in case you want me to run some tests, but it's understandable if you want to let Dan sort out the optimization of your firmware for this hardware.

Thank you for all the groundwork you've done to create and enhance these projects.

Xaranar, 2020-02-04:
Far be it from me to assume I know anything about what's wrong, but the fact that in diagnostics mode AData is reported as missing or silent says to me that there is a problem with that connection to the FPGA.

ikorb, 2020-02-04:
@PolydactylCat: Ok, then it seems that citrus has changed something in his build that is needed to support the hardware and as of now he has not told me what that change is or how to implement in my build. Is't it nice when people take an open source project and make a closed-source variation?

@Xaranar: No, the updater does not output any audio, so AData not showing OK is normal.

citrus3000psi, 2020-02-09:
@ikorb there is nothing changed in the firmware that is special to support the build.  The Scart cables on the WiiDuals (like the ones from RetroAccess) have the colors swapped so nothing would have to be done in firmware for the colors to appears correct. https://i.imgur.com/nwVKO9r.jpg.

This is listed in the instructions on the WiiDual installation, http://dansprojects.com/wiidual_install.html

I assume it has something to do with this, GENERICS := SwapRed=\"YES\" SwapGreen=\"YES\" SwapBlue=\"YES\"  But have no investigated any farther.

ikorb, 2020-02-09:
The three generics just define which TMDS pairs have positive/negative swapped and have no effect on the analog output.

The current version does try to swap the analog colors around when you switch between RGB and YPbPr, but that should only result in a color-swapped picture on the analog output and not such major corruption.

citrus3000psi, 2020-02-09:
From the last images it looks like it’s just color swapping. No idea what’s causing the corruption posted earlier.

PolydactylCat, 2020-02-09:
The set image with the color swap was taken with the 3.0c firmware posted on citrus3000psi's website.  The initial set with severe RGB corruption was taken with the 3.0b build from ikorb.

The firmware branches also seem to handle updater.dol differently.  Within citrus' firmware branch it works fine, but when ikorb's 3.0d was installed, diagnostic mode reports a stuck bit on the vData 0 line.  I am unable to jump between firmware branches using updater.dol.  This may or may not be related to the above issue.

ikorb, 2020-02-10:
The attached version should have a fully-working analog RGB output and it should also not report problems with VData 0 anymore.

(root cause: three incorrect pin assignments in my version)

[gcvideo-WDTEST-dual-wii.zip](https://github.com/ikorb/gcvideo/files/4182934/gcvideo-WDTEST-dual-wii.zip)
[updater-wii-WDTEST-dual-wii.dol.zip](https://github.com/ikorb/gcvideo/files/4182936/updater-wii-WDTEST-dual-wii.dol.zip)

PolydactylCat, 2020-02-11:
Sir, I believe you have solved this issue!  With this firmware there is no more analog RGB corruption, the colors are all running to the appropriate (though technically incorrect) color channels, and the updater.dol works.  You should be able to close out "Unable to update using 3.0c Wii dol" as well.  Thanks for all your hard work.

Out of curiosity, I wasn't able to get the updater.dol to work from your firmware to citrus' or vice-versa.  Users should plan on picking one branch and sticking with it.

ikorb, 2020-02-11:
Thanks for testing!

Closed 2020-02-11.

Thread 31 (2020-01-28):

Unable to update using 3.0c Wii dol

kimbapslice, 2020-01-28:
Hello!
I am trying to update from 3.0b Wii to 3.0c but the updater dol doesn't seem to process correctly, not allowing the prompt to update
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

kimbapslice, 2020-01-28:
GCdual and Carby updated via dol correctly, wii version is being stubborn for some reason. I think by default the menu settings are ignored correct?

ikorb, 2020-01-28:
My current theory is that you may have a minor wiring problem that does not result in visible video errors, but changes the video data enough that the flasher cannot recognize the update. I'm working on a diagnostic mode that should be able to detect this problem - if you are impatient, I could try to build the current version for you to test, but it's still a software-only implementation and thus not as fast as I would like it to be.

What do you mean by "by default the menu settings are ignored"? If you are referring to the firmware updater on the GCVideo side, it ignores all settings except for IR remote codes.

kimbapslice, 2020-01-28:
I was wondering if the GCvideo menu specific settings ("Resolution Hack", full or limited color, etc.) would in anyway affect the "update signal". Anyway, I am patient and curious to see if the upcoming diagnostic mode will reveal any wiring issue.

Thank you!

ikorb, 2020-01-28:
No, I hardcoded basically every aspect of the video signal in the flasher, with an eye towards maximizing compatibility. It even does something that the main firmware can't do, when the Cube generates an interlaced signal it is passed as-is on the analog output (if available) and line-doubled on the digital one. That's also one of the reasons why everything is in black and white, the rewiring trickery used there only works for luma.

kimbapslice, 2020-01-29:
Hi ikorb,
Also, I normally set the Wii to display in Widescreen and 480p (official Nintendo menu). When displaying the Wii menu or homebrew menu, (in games as well I think), the gcvideo "IN" resolution is shown as 672x960i60 (during homebrew channel menu) "OUT"  720x480p60. Is this behavior correct?

kimbapslice, 2020-01-29:
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

kimbapslice, 2020-01-29:
Sorry, I am just wondering if it has any relation to different wiidual revisions and such, thus affecting the update procedure.

ikorb, 2020-01-29:
You have a connection problem or short on video data line 0. It's the pin on the edge marked with "0" in [this image](https://github.com/ikorb/gcvideo/blob/master/HDL/gcvideo_dvi/doc/wii-digitalav.jpg). Fixing this will likely also make the updater work.

kimbapslice, 2020-01-29:
I tried to reflow the ribbon cable to pin 0 with the same result. I did install the wiidual myself so maybe either the (i bought a used wii) motherboard is bad or I screwed up the wiring somewhere along the way. I will wait for the diagnostic firmware feature to get more details. Thanks ikorb!

kimbapslice, 2020-03-12:
Hi ikorb,

With all of the trouble with the wiidual versions, I will stay with Dan's releases. Closing this issue.

Closed 2020-03-12.

Thread 32 (2020-02-11):

Programming JTAG method for Pluto-IIX HDMI

crispycritter911, 2020-02-11:
I've tried to upgrade from 2.3 to the latest version (currently 3.0d) and was having issues with programming it with the USB adapter provided on KNJN. I've read about using a JTAG to programming the SPI flash of the board. Would I use the pin header below the FPGA chip or should I connect directly to the flash itself? I've also noticed you mention the flash could be different on the board and you could try to create another .xsvf file depending on the chip. I was wonder if you could generate one for M25P80VP?

ikorb, 2020-02-11:
The pins for JTAG programming are the two groups of three pins closest to the FPGA on the short side of the board, opposite from the HDMI connector.

I would recommend trying the existing xsvf file first, the M25P80 should support the same commands as the M25P40.

BenoitCaron, 2020-02-27:
I've had somme issues updating with the USB adapter quite recently, turns out I needed a newer version of FPGA Conf. I could provide it if you want to try that.
Can you provide more details on your issues?

crispycritter911, 2020-02-27:
I would like to try it. I'm getting a communication error when trying to
program it.

On Thu, Feb 27, 2020, 10:53 AM Benoît Caron <notifications@github.com>
wrote:

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

BenoitCaron, 2020-02-27:
Yeah I had the same issue. Here comes.

[StartupKit_Pluto-IIx~HDMI.zip](https://github.com/ikorb/gcvideo/files/4263103/StartupKit_Pluto-IIx.HDMI.zip)

Also, would it be possible to host this file permanently and linking it in the readme? It is crazy hard to find it on the web. I got this one by asking KNJN directly.

ikorb, 2020-02-27:
I do not want to distribute someone else's code without their explicit permission.

BenoitCaron, 2020-02-27:
Oh sorry, I did not realize this program was their own! Do you want me to remove the file I uploaded above?

GizmoTheGreen, 2020-04-12:
only login in to confirm I could program the M25P80 on my Pluto IIx just fine with the existing files from Releases (some months ago when 3.0b~c released) it will throw an error after a while but will be succesfully programmed. using built in updater with .dol to upgrade from c to d also worked perfectly.

jeanh17, 2021-04-26:
The latest FPGAconf has the ability to flash a .bin file at offset 0 of the M25P80 so should be able to program the released "gcvideo-dvi-p2xh-gc-3.0e-spirom-complete.bin" directly to flash.
https://www.knjn.com/bin/FPGAconf.zip

Older FPGAconf could only program .bit files at a non-0 offset so a JTAG cable was required.

catawalks, 2023-04-19:
> The new version of the Pluto-IIx HDMI board adds a USB-C connector, making flashing the board easier than with JTAG. https://www.knjn.com/docs/Pluto-IIx%20HDMI%20for%20GCVideo%20mod.pdf
>
> To flash a Pluto for gamecube with 3.1, use FPGAconf 2.22 or higher, choose "Pluto-IIx XC3S200 USB-C" in the boards menu, select the "gcvideo-dvi-p2xh-gc-3.1-spirom-complete.bin" file and click on "Program boot-PROM"... then wait 3~4 minutes for the "boot-PROM programmed OK" message.

For those looking for FPGAconf 2.22 or higher: https://www.knjn.com/bin/FPGAconf.2.22.02.zip

Thread 33 (2020-02-27):

No signal if HDMI is connected when powering on

BenoitCaron, 2020-02-27:
Hello,

I finally installed my Pluto IIx board, and it kinda works.

The issue I’m facing is that the Pluto board won’t output a signal if my HDMI cable is plugged in before powering the console on. When the cable is connected upon boot, LED 29 give me a solid light, and I get no signal. If there is no cable upon boot, LEDs 28 and 29 each blink at different speeds, and then connecting the HDMI cable will get me a signal.

Firmware version: 3.0d

Any help would be greatly appreciated!

Regards,
Benoit

ikorb, 2020-02-27:
I've observed a similar problem on my development board, but only if it is connected to a powered-off TV when turning the Gamecube on. In this situation, something causes the FPGA to not accept the bitstream it is reading from the flash memory.

Do you by any chance use an unpowered HDMI switch that tries to leech power from its inputs?

BenoitCaron, 2020-02-27:
My current setting is an Onkyo TX-NR737E receiver hooked up to my OLED55C6V LG TV, with the Gamecube being connected to the receiver.
The receiver acts as a hub / splitter, and shouldn't be underpowered. Also, it was of course turned on during my testing.

ikorb, 2020-03-01:
Is the LED brightness in the failure case the same as during normal operation?

Oh, and since you fixed your other problem by re-routing the 54MHz signal: Does the startup failure still occur or was it also fixed?

BenoitCaron, 2020-03-01:
The led seems less bright in the failure case. Here is a video of both cases: failure then success.

The other problem is actually not permanently fix and is very much depending on the cable routing - I've had a hard time maintaining a clear signal after moving my console. I'm still waiting on my 3D printed mount, hoping I can find a definitive routing.

So I wouldn't be able to give you a clear answer yet.

ikorb, 2020-03-01:
Thanks! That looks slightly different than a boot failure on my board and I'm not sure if the FPGA boots far enought that this can be fixed in software.

Could you try the version linked below and check if it changes anything?
[gcvideo-p2test-p2xh-gc.zip](https://github.com/ikorb/gcvideo/files/4272642/gcvideo-p2test-p2xh-gc.zip)

BenoitCaron, 2020-03-02:
Could you give it to me as a .bit file please?

ikorb, 2020-03-02:
Sure.

[gcvideo-p2test-p2xh-gc-fpgaconf.zip](https://github.com/ikorb/gcvideo/files/4277687/gcvideo-p2test-p2xh-gc-fpgaconf.zip)

BenoitCaron, 2020-03-02:
I tried with this version, same as before. I'll try and use it on my work monitor, see if it changes anything.

BenoitCaron, 2020-03-03:
I noticed [issue #12 ](https://github.com/ikorb/gcvideo/issues/12) was similar to mine, and the issue seemed to be the wiring. Does the fact that I can manage to get a signal by pluging my HDMI in afterwards mean my wiring is correct?

ikorb, 2020-03-03:
If it works after replugging, your wiring is likely correct, although that does not rule out interference issues as you've seen with the picture dropping out.

There is something you could try: Remove the resistor between VUnreg and DDC+5V. If the board starts up fine without that resistor, but with HDMI connected that would indicate the source of the problem. Please note that you might not get a picture without that resistor even if the LEDs are blinking correctly and you'll probably want to connect that resistor again after the test.

(I wanted to try something similar on my board first, but didn't have time to do so yet)

BenoitCaron, 2020-03-03:
The LEDs behave the same without the resistor. As expected, no more picture without it.

ikorb, 2020-03-03:
Thanks for testing, that narrows down things a bit.

I still have one theory that is consistent with the observed behaviour - you seem to have used very thin wires to connect the board to the Gamecube. While this is ok for the data and clock signals, it may be too thin for the power (VUnreg and GND) as the FPGA draws a surprisingly high amount of current when it is active. Would you mind trying to change the wires connected to the GND and VUnreg pins of the Pluto board to a thicker gauge? Alternatively you could use the same wire, but run two strands in parallel for each pin.

(and if that theory turns out to be wrong there are still a few desperate measures that could be tried, but I first need to implement and test them locally)

BenoitCaron, 2020-03-03:
Alright, then I'll try that tomorrow. I do not have thicker wires, but I do have stranded wire, if that's ok? If not, I'll make sure to run two strands as advised.

ikorb, 2020-03-03:
If the copper area (or diameter) of the stranded wire is significantly larger than the one of your current wires it should be ok.

BenoitCaron, 2020-03-04:
Stranded wire did not change the LEDs pattern, nor did having two strands in parallel.

I'm starting to wonder wether the board is defective or if I messed it up with all the soldering :/

BenoitCaron, 2020-03-07:
So, I bought a thicker wired, rewired the power wire, both ground wires and 54MHz wire (because I still had the signal dropping issue). None of my issues have gone away: LEDs are still not blinking with HDMI connected too early, and the signal still drops after some minutes of gameplay. Could the signal dropping be caused by the board heating too much? Because I made extra careful to route the wire differently, and I can't figure out a way to have a good, reliable signal.

ikorb, 2020-03-08:
My plan was to build a special version of GCVideo that mostly ignores the console and generates a test picture instead, however Real Life[tm] interfered.

So instead could you try flashing the Pong demo and check if it also has startup issues? If it does, it's some kind of hardware problem and I'm out of ideas.

[p2xh-pong-demo.zip](https://github.com/ikorb/gcvideo/files/4303195/p2xh-pong-demo.zip)

BenoitCaron, 2020-03-08:
Yeah, no picture with the pong demo either. As a matter of fact, I haven't been able to get a signal with CGVideo at all since yesterday. I'm gonna try it a friend's house, on their TV, and if it doesn't work I guess I'll sell the damn thing to someone who might enjoy tinkering it. What started as a fun pet project turns out to be not so funny anymore :/

Thanks for your help by the way!

BenoitCaron, 2020-03-09:
Well, for what it's worth, KNJN's assistance is top notch! Even though I bought the board more than 3 years ago, they told me to send it back and offered to fix it, send me a new one or refund it. I did not expect that much!

Hattmeiny, 2022-07-04:
By any chance, could you let me know if the new board fixed everything?  Mine works fine when plugged into my tv or monitor. If I plug it into my receiver, it will just no signal with leds a constant red.

BenoitCaron, 2022-07-04:
I didn't bother getting a new board, with the pandemic and stuff.. BUT I installed it into another GameCube, and got it to work. Kinda...
Just like you, it works fine hen connected to the TV directly, but doesn't when connected to my receiver. There is a trick to it though. I can either:
- Plug the HDMI into the GameCube after boot (after several seconds)
- Use a splitter between the GameCube and the receiver.
Both of these methods (far from ideal) allow me to use the GameCube with the receiver.

Hope that helps!

ikorb, 2022-07-04:
If it is a very old Pluto board, it needs an extra resistor to provide 5V on a certain HDMI pin that is used by some displays and receivers to detect if a source is connected. I think KNJN added a solder jumper to later revisions that needs to be closed instead.

Hattmeiny, 2022-07-04:
Thanks for the response.  Mine is the “D” revision so it does require the resistor. I tried with and without the 100ohm resistor and had the same issue. Starting with the revision “e” it just has a solder bridge you have to make.

Using a switch has worked fine at least.

BenoitCaron, 2022-07-04:
I do have the resistor as well, but it doesn't help with my receiver

Closed 2020-05-22.

Thread 34 (2020-02-27):

Video signal drops after some time

BenoitCaron, 2020-02-27:
Hello,

I'm having an issue with signal stability. The signal will drop while playing, more and more frequently as time goes. It might drop once after 5 minutes of playing, then 2, then 1, until the image no longer appears.

Firmware version: 3.0d

Any help would be greatly appreciated!

Regards,
Benoit

ikorb, 2020-02-27:
Have you tried it with a different display?

BenoitCaron, 2020-02-27:
My current setting is an Onkyo TX-NR737E receiver hooked up to my OLED55C6V LG TV.
I have only tried through the receiver as my TV supposedly won't accept DVI signals.

I'll give a try with a direct connection to the TV.

Xaranar, 2020-02-28:
I've had similar problems when I was installing a P2X into my Wii.  It turned out the culprit was the 54MHz clock line, it tends to interfere with the other data lines so to fix the problem, I used a shielded wire to connect the clock signal.

BenoitCaron, 2020-02-28:
No success with connecting directly to the TV, as suspected it won't take the DVI signal.
I'll try rewiring the clock signal with a different wire. How long can the wire be? It's currently less than 10 cm.

BenoitCaron, 2020-02-28:
Tried a different wire, different routing, and I couldn't even get a picture. Sound was fine though, be the signal kept going on and off again

Closed 2020-02-28.

Thread 35 (2020-03-01):

3.0d Failed boot on WiiDual 1.1

OFSMods, 2020-03-01:
Updated 2x WiiDual consoles to 3.0d today and both (one a 40 board and one a 60) are having the same issue. Both worked great before the update, and the updater verified the flash went through.

It seems as if the WiiDual is failing during boot. The console doesn't output any video or audio whatsoever. When it's doing this, if I pull the power supply and plug it back in immediately, it will work perfectly... until you turn it off. Then when you turn it back on, it won't work until you unplug and plug it back in.

If you unplug and wait a few minutes, it won't work when you plug it back in.

Any thoughts?

ikorb, 2020-03-01:
Immediate thought: I should never have done the Wii version, it's just a lot of trouble ;)

What version was on there before the update?

OFSMods, 2020-03-01:
2.4c I believe, though tbh  I don't remember. It was whichever version Dan shipped the boards out with

leonkiriliuk, 2020-03-10:
I can confirm this happened to me as well. Not only do I get black screen on HDMI but also component cables and good old composite. The blue LED light doesn’t even turn on. The board just hangs there. Moving back to 2.4 branch brought The Wii dual back to life.

OFSMods, 2020-03-22:
Just came across my third wii with this issue. :/

OFSMods, 2020-03-26:
I noticed that I am also having this issue on 3.0c, and am wondering if the "faster startup time" in version 3.0 is the culprit. Any chance you could add a minor delay to startup as a test? I can flash one of the faulty consoles with it to test for you if you'd like.

ikorb, 2020-03-26:
The Wii builds were already slowed down to the previous 2.4 "as slow as possible" value in 3.0b.

OFSMods, 2020-03-29:
Turning off Wiiconnect24 is another workaround that seems to be working, and much more liveable.

ikorb, 2020-03-29:
Oh, I thought your problem was on initial power-on (from a red LED) and thus dismissed WC24 from the start. Does turning off WC24 fix it for all affected Wiis for you?

ikorb, 2020-05-22:
Should also be fixed in 3.0e

Closed 2020-05-22.

Thread 37 (2020-03-24):

Limited HDMI Compatibility

murderdog, 2020-03-24:
After discovering an issue with sound for myself, I began to test my HDMI mod (Pluto board) on a bunch of my TVs and friends TVs and discovered that this thing has a ton of compatibility issues. Whether it’s an issue with display or sound this really seems to work 50% of the time which is very disappointing. I can’t find anything discussing this through google or other forums so I felt like it’s just me. I assume the external HDMI adapters would give the same result since almost all of them run off Gc video. I'm pretty sure with newer TVs it would be a HDCP issue, not sure about others

Honestly I'm extremely disappointed with the results, as I was looking forward to bring this over friends houses and use it on their TV, but now I think it's just 50/50 whether it'll do anything at all
...
- My desktop monitor displays and plays sound just fine
- My old 2009 TV only displays a picture, no sound
- Another older ~2012 TV, No signal at all
- Sony Bravia, 4k TV. no signal at all,  not sure about RCA because I don't have a converter

Have any of you ever bought an adapter or completed the mod and found it just doesn’t work with your tv? I’m curious

**Is there any sort of fix that could make the signal more compatible such as a converter or anything?**

Let me know, thank you!

Pluto-IIx XC3S200 (GCVideo 3.0d)

ikorb, 2020-03-24:
Did you try the "Sample rate hack" option in the advanced menu?

murderdog, 2020-03-24:
> Did you try the "Sample rate hack" option in the advanced menu?

I did attempt it on the 2009 tv with no sound but nothing happened.

I’ll save the settings with it enabled and make the rounds again, but also I’m just curious are there any possible converters or boxes that could be used at all to maybe adapt the HDMI signal to a wider array of displays? I’m not too savvy in TV or theatre equipment so I’m a bit lost. I’m even thinking an HDMI splitter could maybe change something up or maybe not...

Do you think I just have a coincidental set of TVs that are incomparable or there could be something up with my wiring? My soldering seemed pretty solid to me..

ikorb, 2020-03-24:
The main problem signal is the 54MHz clock line, it's very sensitive to crosstalk from the other signals, resulting in an instable system clock, which can result in all kinds of issues from flickering pixels to no image at all. Since it directly influences the clock signal for the output, the tolerance of the receiving side also comes into play.

Some people had success with using a shielded coaxial wire for the 54MHz clock signal, others had to  carefully rewire everything, making sure that the clock signal was spaced apart from the other signals (e.g. [here](https://github.com/ikorb/gcvideo/issues/34#issuecomment-592644586)).

I'm currently considering dis-recommending the Pluto board because of these issues, the plug-in solutions don't suffer from this as much as their traces tend to be a lot shorter.

murderdog, 2020-03-26:
I actually have went through and redid all my soldering once again making sure its okay. But obviously I still don't know if there are any issues with it but display still seems fine. When I plugged it in to my 2009 TV it change some sort of resolution setting on the TV that I had to change back. Not sure if that's due to a better solder connection or not.

So I guess I need to find more TVs to test but do you think possibly an EDID emulator would do anything? I'm very tempted to buy one. I could report back here with results if it changed anything..

https://www.pimfg.com/product-detail/HDMI-EDID-1
https://www.hdfury.com/product/dr-hdmi/

What do you think?

ikorb, 2020-03-26:
An EDID emulator won't help, that only changes the data presented to the source to determine which formats are supported - but GCVideo doesn't even try to check that because I ran out of space.

What might help (but is not guaranteed) is something that processes the video signals, the cheapest thing I can think of is an active (externally-powered) HDMI splitter.

murderdog, 2020-03-26:
> An EDID emulator won't help, that only changes the data presented to the source to determine which formats are supported - but GCVideo doesn't even try to check that because I ran out of space.
>
> What might help (but is not guaranteed) is something that processes the video signals, the cheapest thing I can think of is an active (externally-powered) HDMI splitter.

Interesting, what makes the splitter a possibility? I will be investing in a splitter soon to test, do you think an upscaler could also possibly do anything?

My greatest fear is possibly HDCP blocking the signal, but there’s no workaround that available that I know of.

ikorb, 2020-03-26:
A (fully compliant) HDMI splitter must be able to decrypt an incoming copyprotected signal and re-encrypt it individually for each output, so it needs to fully process the incoming audio/video data and can't just pass it along like an EDID emulator can. Even the "broken" cheap chinese splitters that forget to re-encrypt the output signal have to do that, otherwise they wouldn't be able to decrypt. I wouldn't be surprised though if there are some really cheap splitters that just connect both outputs in parallel, which is why I mentioned "externally-powered" - but I think there is no way they could correctly handle HDCP-encrypted signals because both displays would end up with different encryption keys.

An Upscaler is another example of a device that needs to fully process the incoming A/V data, I didn't mention it as it's a significantly bigger investment than a splitter and I don't know which one I would recommend anyway - the people on the shmups forums might have some recommendations.

HDCP is not an issue here though - displays with an HDMI input are required to support it, but there is no requirement that everything has to be encrypted, GCVideo does not encrypt its output signal, so HDCP does not come into play.

murderdog, 2020-03-26:
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

Thank you so much for all this help. I’m going to make a forum post and pass this info along there to see what they say. Will report back to you on results with either device in the future..

murderdog, 2020-04-08:
Success!!!

It seems a simple upscaler fixed this issue. From my understanding it’s just the 480p or 480i signal from the pluto board just isn’t detected on many modern displays. I assume as time advances it will get increasingly harder for the newest displays to detect this signal but for now all you need is an upscaler box. For a cheap price I just purchased this one in particular off eBay and it works perfectly, sound and all: https://sewelldirect.com/products/echo-hdmi-upscaler-downscaler

Thank you for your assistance. Hopefully anyone else with this issue can also find this thread.

ikorb, 2020-04-08:
As far as I know HDMI requires every display to accept at least 480p, so I doubt it's just because of the resolution.

murderdog, 2020-04-08:
> As far as I know HDMI requires every display to accept at least 480p, so I doubt it's just because of the resolution.

Interesting... who knows then, I wished I had more experience with display issues. I tried to ask on shmups forum like you said but it appears I was ignored or no one really cared about my issue or knew what to suggest.

Weario, 2024-05-27:
just chiming in to comment on my experience with gcvideo.

I have gcvideo using the Carby adapter for my GameCube, and recently had an installer install Electron AVE on my Wii. Both devices are connected to an Onkyo TX-NR7100 AVR which then outputs to an LG CX Oled tv.

this works flawlessly for the GameCube and Carby, but with the Wii and Electron AVE it keeps losing signal (goes on and off).
I can confirm that the Wii issue is indeed resolved by putting a hdmi splitter in between the inputs.
Also, the Wii works perfect when connected directly to the LG tv.

I wonder if this all has anything to do with not enough power coming out of the mini-hdmi port on the Wii or something. I also read somewhere that this could be because some AVRs have issues with DVI signals, but I would have expected the Carby to not work on my AVR either if that were the case.

Hope this info is useful to anyone!

Closed 2020-04-08.

Thread 38 (2020-03-26):

WiiDual 3.0d no signal without first removing power

mario-64, 2020-03-26:
I just had both of my Wii consoles upgraded from 2.4c to 3.0d. Each is connected via Denon AVR to a 4k TV - one Samsung Q60 and one LG B7A. Initially both consoles seemed to be working fine. Powered them on, enabled enhanced DVI as before. No issues.

The problem happens after power down. When either console is powered back on I get no signal on my TVs. If I unplug power then plug it back in they will boot correctly and display a screen. Basically I only get signal on first power up after removing power. This was *not* happening with 2.4c.

Please tell me there is some setting I can change to fix this

ikorb, 2020-03-26:
There is no setting that can fix this.

mario-64, 2020-03-26:
> There is no setting that can fix this.

Clearly something was changed in the 3.x branch which introduced the problem. Can that change be reverted or fixed?

mario-64, 2020-03-26:
I should add, my GCDual which is also running 3.0d does not have this problem

ikorb, 2020-03-26:
> Clearly something was changed in the 3.x branch which introduced the problem.

Sure, but it's not an OSD setting somewhere. If I had an idea which change causes the problem, I would've fixed it already.

(and I'm currently thinking about dropping WiiDual support completely, it's a lot of hassle to support a closed-source board with open source software)

mario-64, 2020-03-26:
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

This is so incredibly disappointing! I had no idea this was a known problem. I paid to have my consoles updated to fix the left-shift which was present in 2.4c. Now I basically have two unusable Wii's. I guess I'll revert back to my crappy Wii2HDMI adapters....

mario-64, 2020-03-26:
Is it possible to downgrade to 2.4x without having to disassamble?

ikorb, 2020-03-26:
> Is it possible to downgrade to 2.4x without having to disassamble?

No

mario-64, 2020-03-26:
> > Is it possible to downgrade to 2.4x without having to disassamble?
>
> No

Figures. Well, I am willing to test any possible fixes you want to try. I have two Wii's which have the issue so we can test things out

mario-64, 2020-03-27:
Are you still troubleshooting this problem or should I find another solution for my Wii’s?

ikorb, 2020-03-27:
Have you heard about this thing called "sleep"?

mario-64, 2020-03-27:
No need to get testy. I was just asking if you’re still investigating or if you’ve given up on the HDMI compatibility issues

ikorb, 2020-03-27:
When you power down your Wii, is the LED in the power button red or orange?

mario-64, 2020-03-27:
Orange. I think it goes into standby not actual power off

ikorb, 2020-03-27:
Ok, could you try to disable the connected standby function somewhere in your Wii setting? I think it's called WiiConnect 24 or something like that.

mario-64, 2020-03-27:
SUCCESS!!! That was it. Disabling Wii Connect 24 fixes it. When I power off the Wii now the light is red. So there must be some sort of HDMI issue when it wakes from standby as opposed to power off. Thank you again!

ikorb, 2020-03-27:
I'm not sure which parts of the Wii stay powered when it is in the connected standby state, but I suspect the FPGA stays at least partially powered and it then fails to correctly reinitialize when the console is turned on again. Depending on what exactly happens, the behaviour could even change from one WiiDual board to the next.

If you worry about missing out on some feature because the connected standby is off: According to Wikipedia, WiiConnect24 has been shut down in 2013.

mario-64, 2020-03-27:
Yeah no big deal for me. Thank you again for the help :-)

mario-64, 2020-03-27:
BTW, totally off topic but should you ever release a new firmware how exactly do you update it on Wii? On GameCube I can just run the dol file.  Do you just go into the OSD and select firmware update?

ikorb, 2020-03-27:
You can either run the Gamecube .dol file in Gamecube mode, e.g. using Swiss or run the Wii .dol file using the Homebrew Channel. IIRC HBC needs an additional XML file with a description to make it show up in the menu, some day I'll remember to update my build scripts to generate that as a convenient zip file with everything.

After running the .dol file the process is the same for both consoles though, start the flasher using About->Update firmware and tell it to install the update with either the controller or IR remote.

mario-64, 2020-03-27:
Ok cool thank you

Closed 2020-03-27.

Thread 39 (2020-04-05):

WiiDual boot issues

aleomark, 2020-04-05:
Hi, i did install with my friend the Wiidual board, every time i turn the Wii on it works fine for the first 3-10 minutes aprox. but then starts glitching and later the image goes black, and gets back again with glitches and black again, if you turn it off and no screen comes later...

my wii is RVL-CPU-60
and wii dual firm is version 1.1     2.4c.2

Here are pics of my install:
https://imgur.com/gallery/yVKozIC

And a video with the trouble:
https://youtu.be/FeS1JuUm0xI

Can you help me with any ideas for solving this trouble please?
Thanks for your help

ikorb, 2020-04-05:
No, I can't help you with issues caused by closed-source modified firmware builds. Please contact your supplier for support.

aleomark, 2020-04-25:
ok, i got it, it was a problem by using leaded soldered, it doesn't mix with lead free flex, and during the expansion can create cracked joints.

I clear it and use lead free solder. thanks anyway, very happy with your projects

Closed 2020-04-05.

Thread 41 (2020-05-21):

WiiDual update failure 3.0d -> 3.0e

trapexit, 2020-05-21:
After initiating the update it reports "No compatible firmware found."

ikorb, 2020-05-21:
I need a bit of additional information, please do the following:

- start the flasher (About->Update firmware), but not the console-side updater
- push left on your IR remote or Z on the gamepad (enters the flash memory dump tool)
- push OK on your IR remote or X on the gamepad (jumps to address 30000)

Your screen should show a lot of hex data with a column of readable characters on the right. The first four characters are the hardware ID, for example my development Gamecube shows "P2XG". What does it show on your system?

trapexit, 2020-05-21:
DK07

ikorb, 2020-05-21:
That hardware ID is not among them supported by my software, so you have a vendor-modified firmware on your board. Please contact your vendor for advice, I cannot help you.

trapexit, 2020-05-21:
There were more than just Dan citrus3000psi Wii Duals? What vendors are supported?

ikorb, 2020-05-21:
The firmware in this repository only supports WiiDual boards that have the hardware ID "WIID". Since you have a board with a different ID, the firmware was modified by someone else and as far as I know these changes are not publically documented.

It is possible that it is just a different ID, but it is also possible that other firmware modifications are required to use this board. Without public documentation for the exact version of your board I cannot support it. The person who sold it to you is your best point of contact for this, assuming he knows what he sold and  where he got it from if he was only an intermediate.

trapexit, 2020-05-21:
It's a stock board from Dan which I updated last week using your 3.0d wiidual firmware. I suppose It's possible I corrupted the update but it works seemingly fine otherwise.

ikorb, 2020-05-21:
In that case Dan seems to have used a modified hardware ID for some reason, possibly because of hardware incompatibilities. Ask him, not me - I'm not doing unpaid support for closed-source hardware with unknown modifications.

trapexit, 2020-05-21:
OK. Chill. I didn't know there was anything else but his WiiDuals. I'll talk to him about it.

drandreas, 2020-12-19:
@trapexit I've also ended up with a board that reports DK07 (Took me a while to install it). Did you receive any insights from Dan why the ID is different?

drandreas, 2020-12-20:
found it: http://dansprojects.com/firmware/WiiDual/

Closed 2020-05-21.

Thread 46 (2020-08-11):

Resolution change

SwiftxMiles, 2020-08-11:
While playing Eternal Darkness, if you go from the game into the menu, there is a 1 second delay in which the resolution changes. I have tried this on my monitor and the issue doesn't appear since my monitor supports adaptive resolution changing. I know this will be hard to fix, but I truly believe it is a very small issue. I'm currently running version 3.0d.

SwiftxMiles, 2020-08-11:
This applies to cutscenes as well.

ikorb, 2020-08-14:
It looks like the game temporarily disables the video output. I have a fix for this, but I need to check if it creates problems in other games before promising that it'll be included in the next release (which may take some time anyway)

SwiftxMiles, 2020-08-14:
It's not a big issue. Once again, it effects a small handful of games so when the next release comes out, I'll insure to update my device (which is a Insurrection Industries Carby).

Extrems, 2020-10-07:
While I don't really care, there is now a workaround for this in Swiss.

haloharry, 2020-10-07:
Am not happy with your lack of caring, but I like the honesty and thank you for the information about swiss.

MadnessUNC, 2021-02-12:
@Extrems which setting is the fix in Swiss? Please excuse the ignorance

Extrems, 2021-02-12:
Force Video Active under Advanced Settings.

MadnessUNC, 2021-02-12:
It works!

SwiftxMiles, 2021-02-12:
That seems to be a fix for now!

tqhoang84, 2021-06-10:
@ikorb @Extrems Is there any other workaround for non-Swiss users?  I have an un-modded GameCube and the EON GCHD Mk-II.  Trying to play Star Wars Rogue Leader is really frustrating when the video drops for 1-2 seconds and then my TV redetects the HDMI signal.

FWIW, I had an original GCHD (firmware v2.3) and I don't recall having this problem with the resolution changes and video drop out.  It was also reported on Reddit that firmware around v2.4 did not have the issue with Resident Evil.

ikorb, 2021-10-16:
Fix is now released as part of GCVideo 3.1

haloharry, 2021-10-16:
> Fix is now released as part of GCVideo 3.1

Thank you very much.
I very much appreciated the Fix.

tqhoang84, 2021-11-08:
> Fix is now released as part of GCVideo 3.1

I just tested the GCVideo 3.1 on an EON GCHD MK2.  It doesn't appear to fix the resolution change drop outs with Star Wars Rogue Leader.

FWIW, I tested the firmware 2.4c.2 and it does not have the issue.  Could you possibly add a menu option to restore old behavior?

tolkoto, 2022-08-27:
Just want to reiterate that this is still a problem with 3.1 Is a fix coming?

RoflMyPancakes, 2022-10-03:
Also having problems in 3.1 still.

TukkOrdo, 2022-10-12:
The fix applied in v3.1 does not resolve the issue in Rogue Leader nor Rebel Strike. Downgrading to v2.4 is the only way I've found around the problem.

Any word on addressing this issue?

z3razerviper, 2023-03-22:
The swiss setting does not work for me did this ever get fixed?

Extrems, 2023-03-22:
It didn't, but there's now an option to pause the game for the duration of the dropout.

link266, 2023-08-16:
Very happy to have the 'pause game for duration of dropout' as a work-around in Swiss.  Here's hoping that one day gcvideo can also be updated to include an option to restore the 2.4 behavior.

link266, 2023-08-16:
> The fix applied in v3.1 does not resolve the issue in Rogue Leader nor Rebel Strike. Downgrading to v2.4 is the only way I've found around the problem.
>
> Any word on addressing this issue?

@TukkOrdo Any chance you can share how you were able to successfully downgrade the EON GCHD MK2 firmware from v3.0/3.1 to v2.4?  I scoured all over and cannot find instructions for how to do so the firmware downgrade?

Extrems, 2023-08-16:
If you have the new Rev2 of the Mk-II, you won't be able to downgrade that far back.

link266, 2023-08-16:
> If you have the new Rev2 of the Mk-II, you won't be able to downgrade that far back.

If I had an original version of the EON adaptor is it possible to downgrade that one?

tqhoang84, 2023-08-18:
> @TukkOrdo Any chance you can share how you were able to successfully downgrade the EON GCHD MK2 firmware from v3.0/3.1 to v2.4? I scoured all over and cannot find instructions for how to do so the firmware downgrade?

This video is a decent tutorial.
https://www.youtube.com/watch?v=G5A3Rj2vfMY

My only recommendation is to not get any of the CH341A programmers that look like that.  There is too much variance and most supply the wrong voltage on the data lines (MISO/MOSI).  My EON GCHD MK2 was undetectable with 5V.  I finally found this "DollaTek" CH341A programmer that you can set the jumper pair for either true 5V (both left position) or 3.3V (both right position).
https://www.amazon.com/dp/B0BVH6BCF5

> If I had an original version of the EON adaptor is it possible to downgrade that one?

The original EON GCHD is not upgradable.  I think this ran firmware 2.3 or something like that.  EON does let you upgrade for a nominal fee and postage though.

The Rev1 of the EON GCHD MK2 is the one that is downgradable to the 2.4c.2 firmware using the .BIN files.

link266, 2023-08-18:
Thanks for the info @tqhoang84!  Will try to track down a Rev 1 of the ML2 (if I can find one).

A friend of mine has an original EON GCHD which I'm going to borrow to test out as well.  Obviously if that's running 2.3 then it won't all the fixes/improvements that have gone since then but hopefully it doesn't have the 'black out during resolution change' that plagues Rogue Squadron 2+3.

Here's hoping that a future version of gcvideo can address the root of the problem (any chance @ikorb?)  The 'pause game for duration of dropout' in Swiss is very helpful but for longterm usage having the 2.4 behavior (at least as an option) in a future version of gcvideo sure would be amazing ;)

Thread 48 (2020-08-24):

GCVideo 3.0e - missing Bit file for manual upgrade procedure for KNJN Pluto 2x board

xpertxp, 2020-08-24:
The documentation for KNJN states to use the supplied "*.bit" file to perform a manual flash of the chip using a programmer if you have an older revision.

The 3.0e that was released, there is no included bit file, however 3.0d does have the included *.bit file in archive gcvideo-3.0d-p2xh-gc-fpgaconf.zip

Thanks

ikorb, 2020-08-24:
Why don't you just use the old one and upgrade from that?

DoctorDan1986, 2020-09-20:
@ikorb How?  How are we supposed to upgrade from the old one without the necessary .bit file?  Is there some reason why we can't be provided with the .bit anymore?

ikorb, 2020-09-20:
Why do you insist on updating using the bit file? I spent a lot of time creating a system to update the firmware directly from the console, just use that.

DoctorDan1986, 2020-09-20:
@ikorb I must be missing something.  How, exactly, are we supposed to update Gamecube versions?

ikorb, 2020-09-20:
If you have a 3.x version installed already: Read the [Updating](https://github.com/ikorb/gcvideo/blob/main/Firmware/README.md#updating) section of the manual.

If you don't have a 3.x version installed already: Install any 3.x version using whatever means you have available and use the previously-referenced console-based update system to update it to the newest release.

DoctorDan1986, 2020-09-20:
@ikorb So, basically, if we DON'T have a way to run home-brew on the console, we're just SOL.

ikorb, 2020-09-20:
Yes.

DoctorDan1986, 2020-09-20:
@ikorb Welp, I'm not gonna say 'You can't do that' because you have every right to dictate the direction your product takes, and I respect that right.  But I have to say that I'm a little disappointed by product philosophies that leaves legacy users eating dust.  I mean, I've GOT a GCloader, so I'm set.  But not everybody has one, or can get one, or can get their hands on a way to load home-brew.

As for me, sometimes I actually LIKE doing things the 'old' way.  Sometimes it's more fun for me to drag out the USB-Blaster or the RS232 instead of just dropping a firmware file on a flash card.

ikorb, 2020-09-20:
I don't see it as a product. It's just an open-source project that I made because I wanted to have it and I uploaded it so others could use it - I get no commission from the sale of any device that runs that firmware.

Also, the special fake .bit-file was only useful for a single closed-source programming tool from a single vendor that happened to produce something unintended, but useful by feeding it with invalid data. If you actually have a USB blaster or other JTAG programmer available, you can just use the XSVF file to program your device. Since I that one actually gets built automatically (unlike the fake .bit files, which I had to create manually every single time) I do not expect to drop XSVF from the releases any time soon.

And finally, if you dismantle a Gamecube to install a Pluto board inside of it, do yourself a favor and also install a XenoGC clone at the same time. This allows you to run Swiss from a burned disc, which is a really, really useful tool and can manipulate the video settings of most games. For PAL users it's basically a must-have because the PAL cube never officially had progressive video out, so you can't get the best video quality from PAL games without homebrew.

Closed 2020-08-24.

Thread 49 (2020-09-19):

Wiidual OSD issue on 3.0e

OFSMods, 2020-09-19:
Came across an issue on 8x wiidual installs I did over the past few days. When I power up the wii with a gamecube controller in port 1, the OSD will not come up. If I then press the reset button on the front of the console, the OSD will come up, but only until I reboot the console. Rebooting using the controller or power button, or by unplugging it, doesn't matter, the OSD will only come up if I reset with the reset button on the front of the console. Not the end of the world, but was curious if anyone else had run into this or if there were a fix for it.

ikorb, 2020-09-19:
Interesting, haven't heard that one before. Is it an original controller or a clone?

OFSMods, 2020-09-19:
I tried with an oem wired controller and a wavebird, same result.

OFSMods, 2020-10-13:
Any ideas on what could be the cause of this, or a possible solution?

Thread 50 (2020-09-27):

Carby V2 gcplug firmware flashed but no video output

Sirethief2525, 2020-09-27:
I'm having this issue with my Carby device when I use the gcplug firmware it flashes successfully but no video shows on the screen, but when I use the shuriken firmware it works for the exception I have no access to the gcvideo menu to run the update proper. Any information you can give me on the issue would be a great help, thank-you in advance.

ikorb, 2020-09-27:
I have no idea what firmware Carby V2 is supposed use, your vendor should be able to advise you.

If it seems to work with the shuriken version, it is likely that it is the correct one. You might need to configure the IR remote codes again though - there should be a button on your device, holding it down for a few seconds should show a screen for that. Please remember to save the configuration in the main menu after configuring the IR codes so you don't have to do it again after turning off the console.

Sirethief2525, 2020-09-27:
The only issue I have right now is that no matter how long I press the button to reconfigure the remote nothing happens, so I'm at a loss on that for the time being. I made a backup of the original firmware that was on it, so I can always re-flash that back on it, it's just kind of frustrating that after following the guide on the Carby website didn't seem to work for me. I did download their update file and ran it through xilinx to try to flash it but the option never appeared until I added one of the firmware files from your github. I did order a replacement that already has version 3 on it, so I suppose I can experiment with this one to find out what the problem could be, Thanks for your help and if you happen to find out anything else about my situation just let me know.

Sirethief2525, 2020-09-27:
Okay, so I figured out that the shuriken v3 gc firmware is the one that works and gives me remote compatibility too.

ikorb, 2020-09-27:
Ah, that's good to know. I should probably add a list of known hardware implementations and what firmware build they require somewhere in the docs in the next release.

Closed 2020-09-27.

Thread 53 (2020-11-03):

WiiDual Analog Output to 480i

swinginman, 2020-11-03:
I am trying to upscale 480p output from the WiiDual HMDI, while keeping the analog video signal in 480i. My CRT supports component video but only in 480i, and doesn't know what to do with a 480p signal. Is it possible to have the analog output remain interlaced while keeping the HDMI in progressive? The upscaler I am using won't upscale 480i signals for some reason, so I need my recording line to be 480p. If this is not possible, would anyone have any suggestions for the most elegant way to solve this problem? The less adapters the better...

ikorb, 2020-11-03:
The best-quality option would be to set your Wii to 480p in the Wii's system menu and use an external scaler to convert that back to 480i for your CRT.

A worse option would be to set the Wii to 480i for your CRT, disable linedoubling in GCVideo and use an external scaler to convert GCVideo's 480i output to 480p for your existing signal chain.

There is another option that I really would not recommend and that is may be impossible on your setup because the neccessary connections were destroyed during the installation of your WiiDual(*), but if the analog output of your Wii were still in working order you could set your Wii to output 480i, connect its analog signal to your CRT and enable line doubling in GCVideo to get a rather low-quality digital 480p signal for your existing signal chain. If you are very lucky, your WiiDual install still provides the real composite video signal of your Wii on its analog output - if I remember correctly that was a documented option in the WiiDual install video, but only the person who installed it would know how much they defiled your Wii during the WiiDual installation. Of course composite isn't as nice as RGB/Component even on a CRT, but considering that this option would also require the use of GCVideos "it sucks, but at least you get a picture" 480i->480p conversion it's probably not that bad.

(*) I still think that replacing the Wii's analog RGB/Component output is a stupid idea.

swinginman, 2020-11-03:
@ikorb Thank you this was very informative. Would you have any recommendations for an external scaler that can convert 480p to 480i with component cables or one that can convert 480i to 480p via HDMI?

swinginman, 2020-11-03:
My CRT has a 4-pin S-Video port as well.

ikorb, 2020-11-04:
For the downscaling route, some TVOne C2 units should work (not all models support 480i output), the old Extron Emotia boxes would also be a possible option as they were meant to convert PC images for TV use, some of the Gefen scalers can also be set to 480i output. The cheapest options are probably the various "HDMI to AV" boxes available under lots of brand names from China, although I have never tried them, as well as a GBS8200/8220 with the gbs-control firmware which also features a 240p/480i downscaling mode. There are likely other devices that can do it, but downscaling to SD is not as common a feature as upscaling from it.

For the upscaling route, two well-known options would be the Framemeister and the OSSC, although the latter uses the same low-quality bob-style deinterlace as GCVideo. Some TVOne C2 units would also be an option (again, depending on the model), as well as many other well-known scalers like the Extron DSC301HD or many home-theather scalers, including old models like the iScan Pro. basically this is the simpler route from an equipment choice point of view, as long as you don't need the device to properly support a 240p input signal.

swinginman, 2020-11-04:
@ikorb Thank you for recommendations. I have an OSSC in route for an unrelated purpose, but apparently it can't downscale. I guess the OSSC pro is supposed to do this: https://videogameperfection.com/forums/topic/downscaling-with-ossc-pro/

Otherwise I will look into the options you mentioned, I would really like to keep the Wii outputting native 480p for the highest quality recording. But adding a conversion step before the CRT isn't exactly optimal. I have looked into the Extron Emotia and the TVOne C2, which are both way out of my price range. I am currently looking at some of the Extron VSC units, as I found some people had success downscaling here: https://shmups.system11.org/viewtopic.php?f=6&t=64788

Is it technically impossible for the WiiDual/GCVideo to output different signals on the HDMI and analog lines? Because I keep getting frustrated from the idea that I have a working video signal, it just needs every other scan line culled for my monitor to display it properly. It seems like the fundamental concept for interlacing video is so simple, it's just the lack of demand that is making a hardware solution so difficult to find. It almost makes me want to brute force my own hardware solution, however I am more of a software guy...

Thank you again, your help is greatly appreciated.

ikorb, 2020-11-04:
Technically GCVideo could be modified to output the Wii's video data (almost) as-is to the analog output while still processing as normal for the digital output, but that would require 480i output on the Wii and GCVideo's own linedoubling to get to 480p. I'm not 100% sure if it would introduce another wide multiplexer in the video pipeline. (and the obvious implementation would also introduce a half-pixel chroma shift, but that is likely not noticable on a CRT)

Downscaling isn't really an option in GCVideo for some of the same reasons that OSSC can't do it: To do it well you need enough memory to buffer a few lines for interpolation because just dropping every second line results in very noticable aliasing. For 480p->480i there is the additional complication that a specific line must be split in half to do proper interlace signalling and just omitting that to get 240p isn't an option either because a 480p frame has 525 total lines which isn't divisible by 2.

swinginman, 2020-11-04:
@ikorb That makes sense, my understanding on interlacing is only conceptual. I have no idea how the actual implementation would work. Do you think it is unrealistic to find a downscaler that doesn't cost over $500, and won't introduce noticeable latency? I might have to give up on true 480p dream, it's just very frustrating considering the reason for buying this WiiDual was for recording quality.

ikorb, 2020-11-04:
Unfortunately I'm not really an expert on video scalers and the market here in Europe looks quite a bit different than the one in the US (where I suspect you are from), so I'm not sure how to answer that question. I would recommend asking on one of the usual forums which are frequented by scaler experts, e.g. shmups.

Personally, if my goal was to optimize for recording quality I would probably just use an LCD that accepts a 480p input instead of a CRT, but that's just due to my preference of space and power efficiency vs. the various qualities of a CRT.

swinginman, 2020-11-04:
@ikorb That's a fair stance, you've already helped me more than I could have expected. Thanks again, you're really doing gods work out here. I say that sincerely.

I don't know if you want to close this issue, but I think you've done what you can regarding my problem. If I find a solution, I'll post my findings assuming this issue isn't closed by then. Stay COVID free my friend.

ikorb, 2020-11-04:
Sure, I'll just close it.

swinginman, 2020-11-07:
Hey, thought I would give an update since I was able to find a solution. I took a risk and bought an Extron VSC 700 video scan converter after looking at a bunch of options. It has direct component I/O, and was ~$60 on eBay. The user manual is shared for the VSC 500, 700 & 700D so I would assume those would have also worked. I configured the scan converter to output component/YUV and set the analog output on GC Video to RGsB which gave me perfect color. I am not entirely sure why this was the combination of settings that did it, but it looks almost identical to when the signal was directly piped in on YPbPr. Any input latency was negligible, and I am able to keep the Wii at 480p to for great upscaling.

Thanks you so much for your help again, your software is great and works elegantly. Cheers!

Closed 2020-11-04.

Thread 54 (2020-11-10):

What are the Video/Sync/Porch Timings for the WiiDual when outputting 240p?

Finatra, 2020-11-10:
I want to simulate the WiiDual's 240p video output but I need to know the H/V sync widths and porch lengths.

ikorb, 2020-11-10:
That partially depends on the video output of the console itself, but in general it should match CEA-861 format 8.

Finatra, 2020-11-11:
I didn't know it could vary per individual console.
I have my Wii displaying on my CRT television over YPbPr. It has a WiiDual installed.
My TV is configured so that the Wii's image is centered and sized perfectly to fill the screen.

I also display my computer on the same TV using YPbPr.
I am able to customize my computer's video output.
I can define the following (all in units of pixels)

H Active Pixels
H Front Porch
H Sync Width
H Total Pixels

V Active Pixels
V Front Porch
V Sync Width
V Total Pixels

The standard defines the Active and Total pixels, but I don't believe it defines Porch widths.
The Front and Back Porch widths determine where the active video is positioned in the frame.

If I can match the porch and sync widths of my computer with that of the Wii, then I can switch between them without have to readjust my TV settings to center/size the image.

ikorb, 2020-11-11:
Sorry, I wrote that in a misleading way. Some details of the video timing generated by GCVideo are determined by the video sent by the console, which in turn is determined by the game running on it.

You are mistaken though, CEA fully defines the video timing of every mode it specifies, including the porch widths. Some modes, like the 240p ones have multiple variants though differing in the total number of lines per frame, which GCVideo just passes through.

Finatra, 2020-11-11:
My mistake. I am having trouble finding that specification online.
Many of them have a letter designation, like CEA-861-D.
Should I be looking for one without a letter?

ikorb, 2020-11-11:
The letter is the revision, higher ones are newer and tend to describe more modes.

Finatra, 2020-11-11:
Thank you ikorb. I have everything I need now. You’ve been very helpful as always. Thank you for your work. 🙏

Thread 55 (2020-11-24):

Newer model Pluto board not working on TV

Bakuku, 2020-11-24:
Hello,

I don’t know if this issue has been mentioned before or not.

The new KNJN Pluto boards with integrated 100Ohm resistor fails to show image on my regular TV but does work on my Gaming Monitor.
Whereas the older Pluto board worked on both displays without issue it now does not.

I’ve checked all my wiring and everything seems in order. When on the monitor the image is Crisp as well so I’m ruling out interference.

Any ideas as to what might cause the issue?

ikorb, 2020-11-24:
Sorry, no immediate idea springs to mind. It could still be intereference between the signals on the Gamecube-to-Pluto side, some displays are more tolerant to off-spec signals than others.

TH3GOD88, 2020-11-27:
Hello, so on the newer board they are selling, we don't need to add a resistor?

Bakuku, 2020-12-06:
> Hello, so on the newer board they are selling, we don't need to add a resistor?

That is correct

jeanh17, 2021-11-11:
No need to add a resistor... but a solder jumper is needed
https://www.knjn.com/docs/Pluto-IIx%20HDMI%20rev.%20E.pdf

Bakuku, 2021-11-12:
> No need to add a resistor... but a solder jumper is needed
> https://www.knjn.com/docs/Pluto-IIx%20HDMI%20rev.%20E.pdf

Thank you!

Thread 56 (2020-11-27):

Need some help

TH3GOD88, 2020-11-27:
Okay, so I looked up to get a better feel for what needs to go where and I found this diagram with photos, but it says "Connect DDC +5 to VUNREG with a 100Ohm resistor" and then right under it, it says "Connect 5V from GameCube to the VUNREG". So my question is do I need to run two 5V lines?

Here is the link.       https://drive.google.com/file/d/1mTW3C0UQoiaa0B43qtbWj6go7RphPaVX/view

ikorb, 2020-11-27:
Older versions of the Pluto IIx-HDMI board had a solder point labelled "DDC +5", which needs to be connected to 5V from anywhere (e.g. from VUNREG) via a 100 Ohm resistor. I heard that newer ones have that resistor integrated and just need a solder jumper closed, but I don't have such a board at hand to verify.

TH3GOD88, 2020-11-27:
I have tried so many ways and I get no video on any TV or monitor. I get power to the board, once I turn the GameCube on, I get a flash of the logo and then no signal.

Bakuku, 2020-12-05:
> Older versions of the Pluto IIx-HDMI board had a solder point labelled "DDC +5", which needs to be connected to 5V from anywhere (e.g. from VUNREG) via a 100 Ohm resistor. I heard that newer ones have that resistor integrated and just need a solder jumper closed, but I don't have such a board at hand to verify.

Jumper? Where?

ikorb, 2020-12-05:
As I said, I don't have one of the newer boards. Check with the manufacturer.

Closed 2020-12-05.

Thread 59 (2021-01-21):

Testing self-made Board

drandreas, 2021-01-21:
I've built a board based on the Shuriken Video v3 Schematic. I would like to test the HDMI-Output before fitting the board into my console.

Looking at the HDL, I get the impression that all internal clocks are generated from the 54 MHz GC/Wii clock on input P43. Is there an option to setup the FPGA to use an internal clock instead?

ikorb, 2021-01-22:
The Spartan 3A does not have any internal clocks that can be used to run the main logic. Even if you supply an external clock, you would still not get anything on the HDMI output because the video data from the console is missing.

drandreas, 2021-01-22:
Thank your for the quick reply.

I wasn't expecting to see a colourful mario. My intention was to check the eye pattern of the clock/datelines lines on my dso.

Closed 2021-01-22.

Thread 60 (2021-02-28):

No signal in 4K QLED Samsung Q70R series

deejaykruger, 2021-02-28:
Hi friend!
I have no signal when I try to connect in my 55” Samsung 4K. Tv says: resolution no allowed, change resolution for in your external device.
I tried every resolutions (while, I plugged vía scart in another tv to do this) but nothing makes working.
I try in HD and Full HD TVs and I had not any problem.
Do you have any idea to use GC Video in this tv 4K set?
Thanks in advance!!

ikorb, 2021-02-28:
Make sure that "Fix resolution" and "Fix sync timing" are turned ON in the advanced options. If you don't have these options, find a way to upgrade your device to the current version. If you already are on a 3.x version, I have no idea.

Also, a quick web search suggests that some Samsung TVs have inconsistend HDMI inputs where certain signals are accepted on some inputs but not others, so you could try using a different input on your TV.

deejaykruger, 2021-02-28:
Worked perfectly with your recommendations. Thanks a lot!!

deejaykruger, 2021-02-28:
Worked perfectly. Thanks

Closed 2021-02-28.

Thread 61 (2021-03-07):

Dolby Pro Logic II Processing Feature?

GK6475, 2021-03-07:
My speaker setup doesn't handle Dolby Pro Logic very well compared to Dolby Digital or 5.1 Surround. Is there a way that a surround sound conversion/processing feature could be implemented?

ikorb, 2021-03-07:
No, the current hardware does not have sufficient processing power to do that.

Closed 2021-03-07.

Thread 65 (2021-05-07):

Learning How to Program GCVideo to Custom Shuriken V3 Wii Board

Orcut, 2021-05-07:
Hello!

I was hoping I could get some help on figuring out how to program as I am very new to this process, and don't fully understand how it works or what is needed to program.  I haven't been able to find any information that explains the process enough for me to understand unfortunately.  I have a Shuriken V3 Wii board that is ready to install besides the programming that needs to be done.  I was hoping someone would be able to help me, or point in the right direction of how the programming process works.

Thanks for your time! :)

ikorb, 2021-05-08:
There are a number of possible methods for programming the board, but in the end they all amout to the same thing: Put the correct data in the external SPI flash. This requires specialized hardware.

I don't know anything about a "Shuriken V3 Wii" board (the real Shuriken V3 had a Gamecube-specific layout), but if it is similar to the original board, it will have contacts somewhere that can be used to connect an SPI programmer and a jumper that stops the FPGA from accessing the SPI flash while it is being programmed. You would need to find an SPI programmer and software that can drive it, connect it to the correct pins, connect the jumper that stops the FPGA and write the gcvideo-dvi-shuriken-v3-wii-3.0e-spirom-complete.bin file from the release archive to it. After that, you would remove the jumper, disconnect the SPI programmer and install the board, hoping that it works first try.

Another option would be to desolder the SPI flash chip from the board, write to it using a compatible chip programmer and re-solder it to the board again.

As for suitable programmers for either of these approaches, in theory just a Raspberry Pi and the command-line tool "flashrom" could work if you know your way around a LInux command line and can figure out the required connections. Another option that I've seen mentioned are the many cloned CH341A-based programmers that are commonly available on eBay and similar sites, but I'm not sure how user-friendly they are either.

Soory for the hand-wavy description, I have no idea what hardware you have in front of you and since it was designed and possibly manufactured by someone else, that party is the one that should provide support to you as they have informatin about it that I lack.

drandreas, 2021-05-08:
@ikorb wrote a very good overview.

I chose the route he suggested a above using an RPi.
In my case I was flashing https://github.com/Arthrimus/Wii-HDMI.

1. "Bridge" JP1 on the board to disable the FPGA so it does not interfere with the RPi accessing the SPI-Flash.
2. Hookup the SPI-Bus (MISO, MOSI, SCLK, CS) to the default RPi PINs and also supply 3.3V and GND.
3. Enable RPi's SPI-Flash/MTD driver by adding `dtoverlay=jedec-spi-nor,flash-spi0-0` to `config.txt` of the RPi.
4. During boot and the `dmsg`-command should show the RPi detecting the SPI-FLAH

Now you can access the beach in linux e.g. with `flashrom` or as `/dev/mtd*`

_Important_: Remove the JP1-Bridge before inserting/adding the board to the Wii (else you could spend a lot of time wondering why the HDMI output is not working.

Closed 2021-05-08.

Thread 67 (2021-07-05):

Pluto 2x Revision E board....audio/video working, but only for 1 minute...

xpertxp, 2021-07-05:
Weird issue here with a Pluto2x revision E. Audio and video working but just for 1 minute or so, then it goes out.  I checked all my solder connections and everything is good. Tested with 2 separate gamecube motherboard as well as a replacement Pluto2x.  Not sure what else it could be.  And I did solder the jumper on the board.

ikorb, 2021-07-05:
Have you tried another display and/or input?

Bakuku, 2021-07-12:
I've had similar issues with Pluto boards lately.
The built in Resistor doesn't work in my case and adding 100 Ohm help resolve the issue for 2 - 3 days.

xpertxp, 2021-07-12:
Damn, it’s good to know I’m not the only one.
And I have tried with other TVs as well. Same issues. Comes on briefly, then fizzles out.

xpertxp, 2021-07-12:
> Have you tried another display and/or input?

Yes

Bakuku, 2021-07-12:
You can also try isolating the 54hz signal. Try routing it away from the other cables.

Thread 68 (2021-07-05):

Pluto-IIx XC3S200 with the HDMI adapter board

CallyPicky42, 2021-07-05:
Hello.
The problem with the Pluto-IIx XC3S200 HDMI board is, the HDMI port is not where I want so could it be possible to use a Pluto-IIx XC3S200 with the HDMI adapter board programed with gcvideo!!??
Regards,
Jude

ikorb, 2021-07-05:
I recommend using a board made specifically for the Gamecube/Wii instead of the ones from KNJN.

It is likely that you will need to modify GCVideo to use different FPGA pins if you want to use it on a different board. I cannot provide any support for that.

Closed 2021-07-05.

Thread 70 (2021-08-02):

Samsung C7000 TV "Video resolution not supported" when switching from interlaced to progressive scan

rapperskull, 2021-08-02:
Today I received my Bitfunx HDMI adapter, connected it to my PAL GameCube, and updated it to v3.0e. I was playing around with 240p test suite and found out that my TV supports all modes except for 288p, so I disabled the Linedoubler function for all modes except this one, but I encountered a problem when switching from interlaced to progressive modes (not the other way around though).

This problem is very apparent when the GC boots, since it starts in 576i, then Swiss decides to switch to 576p. When this happens, my TV hangs on a black screen for one or two seconds, then shows a "Video resolution not supported" message. The only way to get an image is to switch to another input on the TV (for example VGA) and then back to HDMI. This happens both with a "normal" HDMI port and with the one marked as HDMI/DVI.

Both "Fix resolution" and "Fix sync timing" are on. I tried enabling "Sample rate hack" and switching to "YC444" color format, but nothing changed.

Enabling the Linedoubler option for 576i fixes this problem, but it's not the ideal solution, since the image flickers a lot compared to the interlaced signal passed directly to the TV.

I also made some tests with 240p test suite and found out the same problem occures when switching from 480i to 480p, but not the other way around.

rapperskull, 2021-08-03:
Since this problem happens with the XRGB Mini, and we know the resolution is detected as 360x480 instead of 720x480, my guess is that the pixel repeat flag is kept set during the switch.

I have no experience with VHDL, but I find [this line of code](https://github.com/ikorb/gcvideo/blob/d5989ead04c088575e3bbd91c426084331bca71d/HDL/gcvideo_dvi/src/gcdv_decoder.vhd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) a little strange. Maybe this is useful, maybe not.

ikorb, 2021-08-03:
Oh, that's a lot of edits that I didn't see because Github does not send any mails for them.

Is "Enhanced DVI mode" enabled or disabled in your configuration? The 360x480 problem of the XRGB Mini should disappear if it is enabled.

rapperskull, 2021-08-03:
Enhanced DVI mode is enabled and the "Display as 16:9" option does nothing.

rapperskull, 2021-08-03:
BTW, on an unrelated note, the lower 4 bytes of AVI InfoFrame Data Byte 2 should be set to 8 (0b1000), to indicate "Same as picture aspect ratio", since 0 is a reserved value. I don't think this will make a difference with the TV ignoring the aspect ratio setting, but anyway...

rapperskull, 2021-08-03:
I did some more tests with Enhanced DVI off and I think the problem is that some info is wrongly reported.

In fact, without enhanced DVI, I can use all modes without linedoubler (even 288p).

240p is detected by the TV as 1440x240p, 480i as 1440x480i, 288p as 1440x288p and 576i as 1440x576i. 480p and 576p are of course unaffected.

It would be perfect if it wasn't for the missing audio, so my request would be, if it's not possible to fix the problem, to have an option to only enable the audio with Enhanced DVI and not the display information.

I think however that the problem is with the info that's being sent. Unfortunately my TV does not report what the unsupported resolution should be, so I can't give you more info.

ikorb, 2021-08-03:
Thanks for the information. Shouldn't the contents of the lower 4 bits of data byte 2 be irrelevant if DB1 bit 4 is set to 0?

Usually I would try to create a test version with these changes and attach it here, but currently I cannot create new builds of GCVideo. I hope I can get back to it this weekend, but I can't make any promises yet.

rapperskull, 2021-08-03:
Yeah, it shouldn't matter, but maybe some TVs rely on that information.

Don't worry, I can wait. In the meanwhile, I'm trying to re-create the build environment, but I see that's a lot of work.

rapperskull, 2021-08-07:
Hi, have you managed to get access to your build environment? If not, and you have some idea you want to try, I can compile a build and test it by myself.

ikorb, 2021-08-07:
Ok, I had a test build ready for you, but whiile playing around with it I noticed some weirdness which points to a bug that I want to squash first.

Instead I can supply you with two more questions: Do you have Output options->Display as 16:9 enabled? If so, does the problem disappear if you disable it?

rapperskull, 2021-08-07:
Yes, I had that enabled, and no, it doesn't make any difference.

ikorb, 2021-08-07:
Oh well, that would've been too easy...

Attached is a test build that has new options in the Advanced submenu to disable each type of info frame individually (technically: replace with a blank one...). It also changes the AVI infoframe as per your suggestions and features two other small, yet unreleased fixes, one of which I alluded to above.

If your TV really dislikes something about that infoframe, disabling it might lead to a clue. I'm not sure what the reason could be though, according to a low-end commercial analyzer box the only difference between the frames for 480i and 480p are the pixel repetition count and video mode code.

Please note: This build is not a production-ready version, "Save settings" will do nothing because I had to comment out the code to free up some space.

[updater-IFTST1-gc.zip](https://github.com/ikorb/gcvideo/files/6949743/updater-IFTST1-gc.zip)

rapperskull, 2021-08-08:
First of all, thank you for the test build. I tested it and noticed that there's way more lag before any image is displayed on startup (the GC animation shows up very late).
I tried it without changing any option and sure enough the problem is the same. Disabling Video IF fixes it, and the resolutions are detected by the TV as reported above. Even 288p works! If I have to guess, it's that a wrong IF is sent during the switch, and the TV can't recover on its own after getting a wrong resolution. Don't know why switching to another input and back fixes the 576i to 576p and 480i to 480p switch but not 288p though.
I haven't tried all combinations, as disabling Video IF just worked, but I tried disabling everything except that one and the problem was the same.

ikorb, 2021-08-08:
Your TV is weird... The attached version disables enhanced DVI until the next frame if the output mode changes between 15 and 31kHz, which disables all infoframes during the transition.

[updater-IFTST2-gc.zip](https://github.com/ikorb/gcvideo/files/6950902/updater-IFTST2-gc.zip)

If it does not fix the problem, it would be interesting to know if your TV stops displaying a picture with the following sequence of actions:
1. Preparation: Load something that outputs 480i or 576i on the Cube, disable linedoubling, enable enhanced mode, enable video IF, TV should show a picture
2. Disable video IF
3. Enable line doubler
4. Enable video IF

rapperskull, 2021-08-08:
Unfortunately the build you provided does not work. I tried your steps and the TV always showed an image. In fact, when Video IF is disabled, I can change to any video mode without any issue.

ikorb, 2021-08-08:
"does not work" as in "could not get it to install/run" or as in "did not change the symptoms"?

rapperskull, 2021-08-08:
Didn't change anything unfortunately.

ikorb, 2021-08-08:
Thanks. Your TV continues to confuse me. ;)

Continuing on the assumption that it dislikes something about the video infoframe, I captured the one used by an Extron scaler and tweaked GCVideo to match it (this may or may not break then 16:9 switch).

[updater-IFTST3-gc.zip](https://github.com/ikorb/gcvideo/files/6951609/updater-IFTST3-gc.zip)

If this still doesn't work I guess I'll have to bite the bullet and add the video IF option into the main branch.

rapperskull, 2021-08-09:
Sorry, didn't see your last message. Just tested IFTST3 and it works! I tried to switch back and forth with 240p test suite and never got any problem. Unfortunately, 288p still doesn't work. Maybe that IF still needs some tweaking? Thank you for your time and patience.

BTW the 16:9 option does nothing on my TV, since it disables the Auto Width mode, so I have to manually set it to 4:3 or 16:9. Don't know under which conditions the TV disables that option, since the manual is pretty vague.

ikorb, 2021-08-09:
There isn't much I can do about the Power-to-Image delay, if I remember correctly GCVideo produces a video signal within 250ms - but the TV needs to detect it, sync with its clock, start to decode the signals, figure out the image size, adjust its signal processing etc. Some are faster, some are slower and some seem to throw a dice internally to select how long they want to take this time. I suspect no manufacturer ever tried to optimize that process. =(

Since your new TV observations have given me a glimmer of hope that the issue can be fixed without adding new menu options(*) I'll build a version where all the differences between the infoframes can be switched individually. You get to play with these options so other people don't have to. ;)

As for 288p: You could try to enable the "Report 240p as 480i" option in the advanced menu, despite the name it also applies to 288p.

4:3/16:9 switching can be a bit weird depending on the TV - I have one that supports it if I have selected auto aspect on the TV, but it refuses to do so in 240p and 288p modes. It probably does not help that there are multiple aspect ratio indicators in the infoframe.

(*) because menu options increase code size, requiring more free RAM, which requires combing through the code to find something else that can be optimized to free up a few bytes of RAM

rapperskull, 2021-08-09:
The lag has been introduced with IFTST1 though. With v3.0e was negligible. I'll make some more tests, maybe turning it on and off again in sequence is causing the TV to lag.
As for 288p, I will try that setting, but without Video IF it works perfectly fine, so I think the problem is again with the IF.

rapperskull, 2021-08-09:
Just tested the "Report 240p as 480i" option, but nothing changed. The TV still reports 240p as 240p (and not 480i) and 288p as unsupported. Tested again with Video IF disabled and 288p is reported as 1440x288.

ikorb, 2021-08-09:
The only difference between the IFs for 240p. 288p, 480i and 576i is the video mode code and turning on the "240p as 480i" option uses the 480i/576i codes for 240p/288p modes. It's really weird that your TV rejects one of those four if IFs are on, even if the IF is identical to another mode that works. I even checked via logic analyzer that the sync timing for 288p is correct and it does match the specs as well as one field of 576i as it should.

[updater-IFTST4-gc.zip](https://github.com/ikorb/gcvideo/files/6957611/updater-IFTST4-gc.zip)

IFTST4 has four options in the advanced menu that change different parts of the video IF. When they are all of, the IF is the same that is used by GCVideo 3.0e, when they are all on it is basically the same as used by an Extron scaler. I suspect that one or both of the ITContent options are the culprit. The change takes effect immediately, but your TV may need a mode switch to trigger the failure case again.

Haven't looked at the startup time thing yet.

rapperskull, 2021-08-10:
Ok so the option that makes it work is VIF ITContent 2. With that on, and all the others off, I can switch between modes without problems.
Unfortunately, 288p does not work. I tried all 16 combinations of the four options, but none of them worked.
My speculation is that, since 288p is not officially supported, receiving the correct IF prevents the TV from displaying it, as if they tried to block it, but the underlining software can still detect 1440x288. On the other hand, also 240p is not officially supported, but works just fine, so I don't really know.
According to the user manual, the supported resolutions for HDMI, when not in PC mode, are: 1080p, 1080i, 720p, 576p, 576i, 480p and 480i. PC mode is a completely different story: it supports a lot of resolutions, but without audio over HDMI (you have to connect the analog audio jack), and no interlaced support. Still no 240p or 480p though.

My suggestion for the next release is to add "VIF ITContent 2 ON" to the default IF, and add the option to completely disable Video IF, in case someone needs it. As for 288p, I think I'll use the linedoubler option, if you ran out of ideas to try.

ikorb, 2021-08-10:
Great, thanks for your patience testing all of this.

I'm currently working on a few other fixes, but the next release with the Complete Fix Collection should be release-ready soon(-ish). I'll try to fit a VIF switch into the remaining space, but I can't make any promises about it yet.

rapperskull, 2021-09-13:
Hi, do you have any ETA for the new release? Thank you.

ikorb, 2021-09-13:
It'll be released when it is done.

ikorb, 2021-10-16:
Fix is now released as part of GCVideo 3.1

Thread 71 (2021-08-02):

Sound ringing/stuttering in high pitched sounds

GK6475, 2021-08-02:
I've noticed that the digital audio seems to have some ringing/stuttering in some games that have high pitched sounds. Is this a problem with my GameCube, or are more people having this problem?

ikorb, 2021-08-02:
Did you by any chance turn on the "Sample rate hack" option in the Advanced Options menu?

GK6475, 2021-08-02:
Yes, is that the problem?

ikorb, 2021-08-02:
Yes, that option forces the audio sample rate to exactly 48000 Hz by occasionally dropping one sample, which can create audible artifacts.

GK6475, 2021-08-02:
Ok, thank you! That solved my problem.

Closed 2021-08-02.

Thread 75 (2021-09-14):

240p modes not working correctly

kingjinxy, 2021-09-14:
I’ve been using this HDMI-modded Wii (Arthrimus design) for a while now, and it’s been working great with 480i and 480p, but it doesn’t work well with 240p. I first noticed the issue with SNES9X RX set to “Original” mode, which is 240p, but it also happens with official GameCube releases, such as the Zelda Collection. I have line doubling turned on, and this seems to cause the issue when outputting 480p. I can turn the doubling off, and the TV surprisingly accepts it, but it doesn’t look that great and I’d rather output 480p.

Can anyone replicate this issue? I’m on GCVideo Wii 3.0e.

Edit: (forgot the issue)
The video blanks every few seconds, but the audio doesn’t drop out.

kingjinxy, 2022-06-09:
This is an issue with my TV. I assume the Wii refresh rate changes slightly in 240p mode compared to 480p mode, and this causes the TV to drop sync. I have the same problem with the N64 in 240p versus 480i; this is with the RetroTink 2x.

Closed 2022-06-09.

Thread 76 (2021-10-16):

3.1 Update causes extremely soft image with some TCL TVs

TorqueEmPup, 2021-10-16:
I installed this update because I was hoping the GBI improvement would help with the soft scaling my TV was doing with that software.

But instead now EVERYTHING is being scaled very softly and looks like utter crap.
I presume this may be because of whatever was done to improve compatibility of Samsung TVs.

I hope I can downgrade my firmware back down to 3.0d because this is not acceptable.

ikorb, 2021-10-16:
Interesting. Could try the attached version? It the same as 3.1, but without the Samsung fix.

[updater-3.1tst1-wii.zip](https://github.com/ikorb/gcvideo/files/7358212/updater-3.1tst1-wii.zip)
[updater-3.1tst1-gc.zip](https://github.com/ikorb/gcvideo/files/7358213/updater-3.1tst1-gc.zip)

Thread 79 (2021-10-30):

Life sign indicator

jmacato, 2021-10-30:
Hi! Is it possible to add a some kind of a heartbeat signal to an LED or perhaps a static message/bitmap image on the HDMI output if there's no valid signal in the GC Video input?

I was wondering about this because i want to know if i fried my gcvideo board or not due to some stupid mistakes.

ikorb, 2021-10-30:
That's actually a bit complicated. If there is no clock signal from the console, the FPGA cannot do anything at all because there is no other suitable clock source internally or on the existing boards that could be used to generate an output signal or even blink a LED.

If there is a clock signal, GCVideo should blink a LED if the board has one and the blink pattern becomes more complex if video data is recognized. With a working clock signal it is in theory possible to detect that there is no valid video data from the console and generate something internally, but this has not been implemented at this time.

jmacato, 2021-10-31:
yeah i think the last idea you said there is a good one, hopefully it'll be implemented in some way in the future :)

Closed 2022-08-03.

Thread 82 (2021-11-21):

Retrobit Prism adapter has horizontal line with Xgimi horizon pro projector

Mika73, 2021-11-21:
I am using Retrobit Prism GC adapter. Firmware is updated 3.1. Using Xgimi Horizon Pro 4K projector. Picture has horizontal line at middle and up/down part of pic are not even. Other part is more left/right. I guess it’s projector problem because GC used to work with Xiaomi Mi mini projector and Nebula Capsule II. But is there something I can try? Try update adapter to 3.1 and turn off different advanced options of adapter. GC has GC Loader and load games from memory card. I try force pic to 480p from there. No help.
Maybe I just need get Retrotink 5x is projector like higher resolution better..

ikorb, 2021-11-21:
That sounds really weird, can you take a picture of it?

Mika73, 2021-11-21:
Lähetetty iPhonesta

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

Mika73, 2021-11-21:
![Uploading DE4E15A6-EEDF-4FBD-AD78-3156E6F07060.jpeg…]()

Mika73, 2021-11-21:
Try send pics from iPhone by reply your message and here, but those won’t show up.

Mika73, 2021-11-21:
I was going to send pics with messenger. But there’s atleast 4 guys who have same name, so didn’t know witch one was you :-)

ikorb, 2021-11-21:
Probably none of them.

Mika73, 2021-11-21:
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

Mika73, 2021-11-21:
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

Mika73, 2021-11-21:
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

Mika73, 2021-11-21:
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

Mika73, 2021-11-21:
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

ikorb, 2021-11-21:
Thanks. Could you try to disable the "Fix Sync Timing" and/or "Fix Resolution" options in the Advanced Settings submenu?

Mika73, 2021-11-21:
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

Mika73, 2021-11-21:
It moved press start/pause level.

ikorb, 2021-11-21:
Unfortunately this probably means that there is nothing I can do in GCVideo to fix this. You could try to add a scaler or other signal processing boxes between the console and the projector - I've heard that the HDMI input of an Xbox One accepts a wide range of signals, if you happen to own one.

Mika73, 2021-11-21:
Thanks I have OSSC and been thinking Retrotink5x. Just hoped that it would be possible just with this adapter

Mika73, 2021-11-22:
That’s strange problem. I try GC with RGB scart and OSSC. 3x mode doesn’t do it. Other modes do. However pic isn’t so good.

Oreo412, 2023-08-13:
Hi, I know this is an old chain but I'm having the same problem. On my LG Oled if I try with a standard display mode the picture is fine but there's pretty significant input lag. When I turn low latency mode on, the input lag goes away, but then I have the same problem as OP, with lines on the screen. Is there any affordable recommended way to fix this issue? I don't have an Xbox one or anything. I was thinking about maybe buying an HDMI switch but I'm not sure if that would help or not. I don't have the money currently to spend on an OSSC or Retrotink or anything.

Thread 84 (2021-12-31):

Random pixels on Vizio TV

staze, 2021-12-31:
Not sure if this is an issue with the Retrobit Prism, or the GCVideo firmware, but I get random light colored pixels on my Vizio V405-H19. Seems worse on darker images on the screen.

Adjustments in GCVideo don't seem to change the behavior. Have tried multiple HDMI cables and ports on TV, Switcher, etc.

Anyone else seen this?

Thread 86 (2022-02-13):

Fiber HDMI cables do not work with GCVideo (any version)

GK6475, 2022-02-13:
I am using an HDMI fiber cable for my game consoles, but the GameCube hasn’t worked via my EON GCHD MK-II. I assume this is due to low power output, since the cable works flawlessly with my other consoles. Is there any way to increase power output from GCVideo to make fiber cables work?

Closed 2022-02-13.

Thread 93 (2022-06-20):

No image on Gamecube System Menu

AlucardRetroChallenge, 2022-06-20:
Hello! I have a Brazilian DOL-002 gamecube (digital Port + SP2), modded with a Qoob Pro.
I use the Aliexpress version of GCPlug (the blue One), flashed with the ver. 3.1. (it came with 3.0d).
When I use interlaced resolution on Qoob Pro or Swiss via GC Plug, everything is fine, but when I access the original system menu, I don't get any image, just the menu sound.
And it happens with my capture Card (elgato hd60) and my 4k TV (Samsung KS8500 / KS7500).
The older 2011 model (32") doesn't get imagem at ALL, even forcing 480p via Qoob menu ir Swiss.
Thanks!

ikorb, 2022-06-20:
Does this also happen with default settings (linedoubling enabled for all modes, enhanced DVI off)?

AlucardRetroChallenge, 2022-06-20:
Yeah, It happens! To make it easier, I've recorded a direct feed footage. Qoob Menu, Swiss and game in 480i are ok, but nothing happens on original bios.
Please, take a look: https://1drv.ms/u/s!AsRv502u3B9niKl7qQqx2LITtLjBjg?e=aWfKUA
By the way, it also happend in ver. 3.0d (before the update).

ikorb, 2022-06-26:
Does anything change if you disable "Fix Resolution" and "Fix Sync Timing" in the Advanced submenu?

AlucardRetroChallenge, 2022-06-30:
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

Thanks for the answer! I have tried these settings, with every Digital Color Format, with linedoubling enabled for all modes, enhanced DVI off, and nothing happens. Have you ever seen this before?

AlucardRetroChallenge, 2022-06-30:
Man... I've been thinking. Follow me to see if we can get through it.

My HDMI adapter is this. A supposely normal GCPlug. It came with the GCVideo 3.0d firmware. Please, take a look:

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

I've opened it, and saw this chip:

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

Ok. I've tried to update it with the "updater-3.1-gc.dol" file, with the "gcvideo-3.1-gcplug.zip" and it didn't work out, but, with the file "GCHD_MK2Rev1_3.1.zip", it was "good to go", as you could see in the video posted above.

I'm suspecting this GCHD update on this GCPlug of mine is not working properly. But then... I remember that the problem related to the topic was happening on the older firmware.

But (again, lol), I remember that once, a long time ago, on a old Samsung LED TV, with the old firmware (3.0d), it was possible to see the original bios / system menu with 480i resolution for a moment.

Said all of this, here comes my questions:

1) Is it possible that this GCPlug is a defective unit?

2) Assuming it is not, is it possible to have some kind of problem on my Gamecube motherboard? Is there any point on it to check - with a multimeter - if the 480i resolution is working properly through Digital Port? This resolution works fine on the composite cable.
I don't belive very much in this second alternative, because it is possible to output the 480i signal via HDMI on Qoob Menu and Swiss.

3) Last Question: based on the GCPlug chip shown on the picture, is there another update file compatible withi it other than the "GCHD_MK2Rev1_3.1.zip"? It quite obvious that my device is not that one, lol. This firmware on my GCPlug fells more like a "workaround".

Sorry for the long post and the poor english. I hope we can solve this mistery together.

Thanks! ^^

Extrems, 2022-07-03:
Your unit isn't defective. This is an issue with PAL-M I've known of for years, but figured it couldn't be addressed.

ikorb, 2022-07-03:
Oh, PAL-M. I only have access to Euro-PAL cubes (and one US-NTSC), so that case was never tested.

I wonder why Swiss calls it DOL-002 though, isn't that the code for the power supply?

Extrems, 2022-07-03:
Good news, the NTSC video encoder supports PAL-M, and it's signaled the same way as PAL 50Hz is, which is the problem.

It is the part number for the power adapter, but for whatever reason, they labeled this system like so.

Extrems, 2022-07-03:
You can use Game Boy Interface or Enhanced mGBA with `--format=pal-m` to test this, and also `--format=ntsc-50` for the reverse problem. It's also possible to use Not64 with `VideoFormat = 2`.

AlucardRetroChallenge, 2022-07-04:
> Your unit isn't defective. This is an issue with PAL-M I've known of for years, but figured it couldn't be addressed.

Really? The swiss, on my Dol-002 Gamecube uses to work fine in every scenario that we've talked earlier.
When the console it's connected to my CRT via composite cable, swiss automatically sets the game system color to "Pal-M", like in the picture bellow:

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

> You can use Game Boy Interface or Enhanced mGBA with `--format=pal-m` to test this, and also `--format=ntsc-50` for the reverse problem. It's also possible to use Not64 with `VideoFormat = 2`.

You've nailed it! When I open the GBI via Swiss (always booting throgh Qoob Pro) in NTSC 480i or 480p, it works fine. When I set to "Pal-M", it blinks the screen really fast, and then... black screen, just with audio.

> Oh, PAL-M. I only have access to Euro-PAL cubes (and one US-NTSC), so that case was never tested.
>
> I wonder why Swiss calls it DOL-002 though, isn't that the code for the power supply?

The Dol-002 is the code given to the brazilian consoles only (the same as the Power Supply, very good Nintendo). Just like the pic bellow:

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

The Qoob Pro chip works fine on the console. I think it works because the modchip has it's own crystal oscillator, so I presume It doesn't use the one attached to the console's motherboard. Am I right, or gone too far?! Lol. I'll try to run Swiss through memory card's exploit (Twilight Princess Exploit) just to see how the console behaves (bypassing the Qoob Pro through the X button and booting with the original bios, first on my CRT, and then with HDMI).

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

I don't know if it is going to be useful for you @ikorb and @Extrems, but I've dumped my console's IPL for you.
Please, use the link bellow:

https://1drv.ms/u/s!AsRv502u3B9niKpaEO2d8_dVHQ-4gA?e=wwNWYT

@ikorb, with these files, do you think it is possible to support Pal-M on GCVideo? If you think it is really not possible (as long as i'm in Brazil and unable to send the console to you, sorry...), maybe i'll try to convert the Pal-M to NTSC, just like people use to do here with with SNES, N64 and some other consoles that comes as NTSC and do not work with old Pal-M Tvs. But I really don't wanna change my console's motherboard at all.

Thank you guys for being so helpful!

Thread 94 (2022-06-26):

Custom Board output issue

Luigi90900, 2022-06-26:
I have been working on a board that is similar to the Wii Dual in layout and nearly identical in pinout (I was hoping to use the same firmware build settings when generating the firmware) The board powers up and the LED comes on flashing for a few seconds before turning solid, but there is no output from any pin on the FPGA in either state. I'm not sure what could be causing that problem so I'm unsure of where to troubleshoot. This is my first FPGA project so I am a bit of a moron when it comes to this stuff.

It is connected to the Wii AVE-RVL through some short wires because I don't have a flex cable like the Wii Dual, and the signals reach the pins on the FPGA. Checking every output with an oscilloscope shows zero activity. The only pin that seems to do something is the LED pin.

ikorb, 2022-06-26:
It's hard for me to diagnose something like this, but the initial LED flashing may just be the FPGA trying to configure itself. Check if the FPGA actually reports a successful configuration on the DONE pin.

Luigi90900, 2022-06-26:
The Done pin does go high. I can see the activity on the SPI bus as well. I figure something about the way I built the firmware isn't working quite right, but I'm not sure what that could be.

Luigi90900, 2022-06-26:
In case it matters, I programmed the flash indirectly through the FPGA's JTAG interface following Xilinx's documentation from the .mcs file in the latest release. The flash is a M25PE40, rather than a P40, but I made sure to select the correct part when flashing with impact.

ikorb, 2022-06-26:
Unfortunately debugging this will not be easy, At this point it could be caused by a lot of things and the regular output signals are not sufficient to determine the cause - your specific problem could be anything from a missing/misconnected 54MHz clock, non-locking PLLs due to a "dirty" 54MHz signal, missing syncs due to a misconnected VData signal, missing/miscompiled ZPU code, problems with the startup delay (requires BClock) etc. etc.

Since you can do custom builds, your best bet is probably to selectively route some signals to external pins to scope them. Good candidates for that would be the "Locked" signal from ClockGen, the ZPU Reset signal, some low bit from the ZPU ROM address bus, HSync/VSync from the output of gcdv_decoder and possibly more depending on the results.

Luigi90900, 2022-06-26:
Thanks for the help, I'll start checking things there.

Luigi90900, 2022-08-03:
Just to clarify some things, what signals are necessary for the board to output video? Obviously you need Data 0-7, 54 MHz, and CSel. But are the I2S lines also needed?

ikorb, 2022-08-03:
54MHz clock, VData 0-7, CSel and BClock are required - the last one is used to delay the actual startup a bit because the 54MHz clock signal takes some time to become stable on Wii and without delay the PLL would sometimes fail to lock.

jmsunseri, 2023-07-28:
What FGPA chip did you go with?  I was thinking about making something based on the Spartan-7 using GC Dual as a template but simplified closer to an internal Pluto II mod.

Luigi90900, 2023-07-28:
I used the Spartan 3A XC3S200A

jmsunseri, 2023-07-28:
did you need to modify any of the HDL or were you able to use one of the existing ones?  If so which one?

Luigi90900, 2023-08-02:
I changed some of the pin definitions, so I had to recompile the bitstream,
but you should be able to use the existing ones if you don't change
anything like that.

On Thu, Jul 27, 2023 at 10:11 PM Justin Sunseri ***@***.***>
wrote:

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

Thread 97 (2022-07-06):

Top of screen is desynced on LG smart TV when line doubler is not enabled.

khlompur, 2022-07-06:
Hello,
I’m noticing some image desync/misalignment on the top 10% of my screen. When line doubler is enabled this issue is not present but I cannot turn line doubler on for 480p. In 480i line doubler introduces substantial lag or that would be the solution.
The top of the display is always “behind” and is showing something that was previously there. Images included below.
I tried disabling the resolution fix and sync fix in both 480i and 480p but neither of those options eliminated or even moved the location of the desync. This happens in all games when line doubler is not enabled.
is this a tv hardware issue?
Here are some images:
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

Oreo412, 2023-08-13:
Did you ever find a solution using GCVideo? I'm having the same problem on my LG Tv too

khlompur, 2023-08-13:
Yo,
So I still have the same TV. I was able to get it working using a GCHD
mk-II eon and an mclassic in progressive scan mode. I had tried the prism
adapter originally and got those results I posted about. The solution I’m
using now is very nice and I recommend it.
Thanks,
GCvideo friend

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

Oreo412, 2023-08-17:
Thank you. Does the mk-II eon work by itself? I can get that but it's pretty difficult to get the mclassic affordably where I live. Thanks

Thread 98 (2022-07-09):

Will any of these mods work with gamecubes lacking digital output?

nikitalita, 2022-07-09:
Which of these mods can be installed in a gamecube lacking digital output? Is it still possible to install the HDMI mod on one?

It is not in the FAQ and I have been googling, but the only results I see are talking about how people don't actually know if gamecubes without digital av out are compatible with the HDMI one, so I figured I would ask here.

ikorb, 2022-07-10:
It is technically possible and I think I've seen pictures of an installation online, but it requires advanced soldering skills as you need to solder directly to the pins of the video encoder and/or tightly spaced vias on the PCB. Unfortunately I don't have any references available with more information.

Thread 99 (2022-07-11):

Update to 3.1 on GCplug

flo0306, 2022-07-11:
Hello everyone,
I have a GCPlug (the one with the blue plastic cover) and the current firmware version is 3.0a
I never had any issues to make the GCPlug work on my PAL Gamecube, it is just the updater tool that always show "No compatible firmware found" despite the fact that I open the correct menu on the plug and launch the updater 3.1.dol on Swiss. (on the last version of Swiss availiable). I use the Mario Sunshine Exploit to run Swiss. I don't know if Softmod exploits have limitations.... Does anyone have an idea ?
Thank you in advance for your help.

ikorb, 2022-07-11:
Your vendor seems to have programmed the device with a modified firmware version. Please contact them for support.

flo0306, 2022-07-11:
Thank you for your feedback. I will contact them.

Closed 2022-07-11.

Thread 100 (2022-08-15):

No video/led from carby after trying to update to 3.1

Titusp13, 2022-08-15:
Tried to update my carby to 3.1 via gc loader dol. Launched the flash tool from carby and dol from gc loader. Looked like it was updating but just hanged. Pressed back on carby IR and it seemed to power off/reset carby and now i have no led at all. No video at all either. Help?

ikorb, 2022-08-15:
Do you get a picture if you hold down the button on the side of the carby (*) while turning on the console?

(*) Section "Carby Remote Training" on https://insurrectionindustries.com/carby-quick-start-guide/

Titusp13, 2022-08-16:
> Do you get a picture if you hold down the button on the side of the carby (*) while turning on the console?
>
> (*) Section "Carby Remote Training" on https://insurrectionindustries.com/carby-quick-start-guide/

Yeah it was my retrotink 5X.... couldnt get a signal at all. I then tried direct into PC monitor and got video and successfully flashed new firmware. And is now working on the Retrotink 5X again. Thanks for the help and wonderful gcvideo ikorb :)

Closed 2022-08-16.

Thread 104 (2022-11-22):

HDMI Alternate mode

Bakuku, 2022-11-22:
Hello,

Is the GCvideo software capable of HDMI Alternate mode?

For a project I’m working on I’m looking into simplifying the number of connectors that are used on a Gamecube by having both POWER and AV running through a single cable.

I know GCvideo doesn’t really use the standard HDMI protocol, but could the software be adjusted to support such a feature?
I’m guessing a redesign of the hardware is necessary to accommodate the feature.

Thank.

ikorb, 2022-11-22:
If you mean the USB-C alternate mode for transmitting HDMI over the four diff pairs of a USB-C cable, that is completely out of scope for GCVideo and would need to be handled by the USB-C controller chip. Of course GCVideo does not implement HDMI, but given HDMI's backwards compatibility with DVI I suspect that GCVIdeo's DVI signal over this alt mode would work.

Are there any actual HDMI alt mode products on the market though? As far as I know everyone seems to use Displayport alt mode and converters to HDMI (if needed), which has the advantage that it needs fewer data pairs and can thus coexist with USB 3.0 over the same cable.

Bakuku, 2022-11-22:
@ikorb

https://www.ti.com/lit/an/slla333/slla333.pdf?ts=1669067275760&ref_url=https%253A%252F%252Fwww.google.com%252F

ikorb, 2023-01-09:
https://www.notebookcheck.com/Der-Tod-von-HDMI-ueber-USB-Typ-C-Alt-Mode-und-mehr-Power-im-Kabel.679977.0.html

Closed 2023-01-09.

Thread 105 (2022-12-19):

Screen going blank in Rogue Squadron II and Rogue Squadron III when switching to cutscenes

Galaxy366, 2022-12-19:
**Game:** Rogue Squadron II and Rogue Squadron III

**Issue:** The screen will go blank for about 2 seconds when the game switches from gameplay to cutscenes and back again.

**Description:**
Gamecube DOL-001 running Swiss v0,6 with the Retro-bit PRISM HDMI adapter running GCvideo 3.1 will cause the screen to go blank when switching from gameplay to cutscenes and back again. The impact is that you will miss the beginning and end of cutscenes.

Thread 106 (2022-12-23):

GcVideo Audio Sync delay up to 2 seconds

Alex13mod, 2022-12-23:
I'm  playing PSO on Gamecube using GCVideo - After 10 to min play I noticed AUDIO DELAY from the TV.

The only way to fix the synch is constantly changing input HDMi1 to HDMI2 and back to HDMI1 on my TV.
I have a 65 in LG TV 4K model.
this also happens on live stream with audio delay.

ikorb, 2022-12-23:
Does it also happen if you enable "Sample rate hack" in the advanced settings menu?

GCVIdeo does not buffer audio for more than four samples (approx. 0.08 milliseconds) - if the delay is large enough to be noticable another device is buffering when it should not.

Alex13mod, 2022-12-23:
I will try that and test.
Maybe its the LG Smart TV is doing something but this also happens when I'm using my EL Gato.

I'll try thst first and see.

Alex13mod, 2022-12-23:
Thanks seemed to be working fine now!

Thread 107 (2023-02-10):

No HDMI signal at all

ceesvanegmond, 2023-02-10:
Hi there,

In 2020 I bought the FPGA board from KNJN. It is preinstalled with GCvideo for Gamecube. It's a revision F board the the DCC fix should not be needed.

Last week I finally had time to install it for the first time. I think everything went very well; except that I cannot seem to get an HDMI signal from it. I tried multiple TV's and Monitor's so I think it's an wiring issue. I already tried to see if there any loose wirigns or miswirings or potential bridges but so far I cannot seem to find it. When trying out the Analog signal; that also doesn't work anymore; well partial. It does gray/white but no colour.

Could it be possible that these two problems relates to each other?
I don't know where to start right now :-)

Androxilogin, 2023-08-03:
I had the same problem but I couldn't find any bad traces. Did you try the original A/V port? I'm pretty sure with mine I spend soo much time messing around with the chip itself, I didn't pay attention to not having thermal pads on the heatsinks and it got toasted that way. I've since installed a new motherboard I got for cheap but haven't attempted to mess with this again. Although, I'm planning on trying on a DOL-101. There are alternate connections directly to the chip which are present on both revisions of the board.

More info about the wiring can be found here:
https://github.com/ikorb/gcvideo/tree/main/HDL/gcvideo_dvi

Take note that connection CLK SEL is "color select" and DATA is actually ADATA.

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

Thread 108 (2023-03-05):

Question about wii HDMI device

49studebaker, 2023-03-05:
This device uses ikorb’s GCvideo. The digital output signal is lossless.

https://electron-shepherd.com/products/ave-hdmi

Does the following device use ikorb’s GCvideo? Is it converting analog to digital or is the digital output signal lossless? Thanks.

https://share.temu.com/LfrFNdNGyI

ShaneKent, 2023-03-05:
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

I’m one of the developers for the AVE-HDMI.
Our product uses ikorb’s GCVideo for digital-to-digital conversion.  It does not perform analog-to-digital conversion.

49studebaker, 2023-03-06:
Does the second device I posted, use GCvideo or is it doing analog to digital conversion? Is it possible to get lossless digital output from the digital output port or do wires have to be soldered to the circuit board? Thanks.

ShaneKent, 2023-03-06:
> Does the second device I posted, use GCvideo or is it doing analog to digital conversion? Is it possible to get lossless digital output from the digital output port or do wires have to be soldered to the circuit board? Thanks.

The second device you listed does not use GCVideo. It performs an analog-to-digital conversion. The Wii does not have a digital output port, so the only way to achieve a digital-to-digital conversion on the Wii is to do an internal mod installation.

Closed 2023-03-05.

Thread 110 (2023-03-27):

Conflicting Resolution Reporting on 3.1 in Electron Shepherds’s AVE-HDMI on Wii CPU-40

Ghost-Mop, 2023-03-27:
Hi, I finished installing two of the new Wii HDMI kits this weekend and my CPU-40 is claiming different resolutions in the three/four most common places but my CPU-20 is reading 720x480p across the board, leading me to question the 40’s behavior.
On the CPU-40’s install, in the OSD I can see 686x912i60 IN, 720x480p60 OUT, but the top right resolution notifier will also state 686x912i60, or whatever slight variation of those numbers but always mismatched to the OSD’s claimed output.
Attached are some pics of the install (yes that is a pink XCM case and probably too much kapton tape)

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

I played with a few games, Mario Kart Wii, Mario Parties 8/9, and Animal Crossing: City Folk but I can test out a GameCube game when I get home later, if that could prove useful.

The hardware seems to be working fine and Shane Kent (name-drop!) of Electron Shepherd recommended *against* re-installing unless a solution couldn’t be found here.

Is there a fix for this in the OSD, Priiloader, system menu, etc? Will I be best suited to try and re-flow my install? Is this just a quirk of a CPU-40 install?

I do apologize if this is the wrong place to ask for help!

Quizzically Yours,
Max

ikorb, 2023-03-27:
You probably have a problem with VDATA0. You could try the [diagnostic mode](https://github.com/ikorb/gcvideo/tree/main/Firmware#diagnostics-mode) to confirm - please be aware that the results are only fully valid if the console is running a 3.0d or later updater at the time (you don't need to actually start the update) because that draws a test pattern at the top of the screen so the diagnostic mode has something known to compare against.

ikorb, 2023-03-27:
Don't use the stub, use one from a [release](https://github.com/ikorb/gcvideo/releases/tag/GCVideo-DVI_release_3.1)

Ghost-Mop, 2023-03-27:
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

so it thinks we’re getting crosstalk!

ikorb, 2023-03-27:
Yes, a problem with VData bit 0 exactly matches the "detects progressive input as interlaced with twice the expected vertical resolution" symptom. Since it is not detected as stuck, it might be floating, shorted to something adjacent or connected to an unrelated signal.

I recommend contacting your hardware vendor about debugging a bad installation since they should know that hardware better.

Ghost-Mop, 2023-03-27:
I’ll shoot him an email, would you like me to update the thread here or close?

ikorb, 2023-03-27:
I'll just close it

Closed 2023-03-27.

Thread 111 (2023-04-01):

OSD doesn't show with Wavebird controller

vguttmann, 2023-04-01:
I installed an AVE-HDMI in my Wii, and to bring up the OSD, you'd hook up a GC controller to port 1 and press L+R+X+Y.

However, despite all the buttons working, this does not work at all for me.

I'm not sure if this is a limitation on the controller side, or what's going on here, but I thought I'd let you know.

ikorb, 2023-04-01:
Does a Wavebird not have the "click" when fully pressing L/R?

drandreas, 2023-04-01:
It work's with my Wavebird but I have to open a manu that supports the GC-Controller e.g. Homebrew Channel.

vguttmann, 2023-04-01:
Yes, it does have the click, and also yes, I did have to open the homebrew channel.

It works now, thanks!

Closed 2023-04-01.

Thread 112 (2023-04-08):

Wii audio glitch occasionally

Tafty1987, 2023-04-08:
So I've done quite a few wiidual and wiihdmi installs over the past couple of years but have never encountered the issue I'm facing with a customers wii. Gcvideo works perfectly fine 99% of the time BUT sometimes(1 in 20 chance) when I turn this wii on the audio is extremely loud distorted and crackling in the system menu and if you launch anything. A quick power off and on usually clears the issue.. Sometimes you may have to do this twice.

Ive tested composite video at the same time hdmi is doing weird stuff with the audio and it's perfectly fine there, I've gone over my work and can confirm its not an install issue

ikorb, 2023-04-09:
What does the [diagnostic mode](https://github.com/ikorb/gcvideo/tree/main/Firmware#diagnostics-mode) show?

Try starting flash update mode multiple times because even though it does not output audio at all starting it probably has the same effect as a power cycle.

Tafty1987, 2023-10-18:
Hey ikorb,

sorry for the delay in coming back to you, diagnostic has always been fine when ive checked, it turns out its acctually my LG monitor. ive installed quite a few AVE HDMI's since i reported this and they all have the same issue where sound is distorted. this only happens if its plugged directly into my main monitor. testing it on other screens it works perfectly as expected....so im not to sure why my monitor doesnt like the wii mods....but havent looked any further into it, just remember to test on a different screen now

Thread 113 (2023-04-13):

Color Banding and DAC issues.

finakechi, 2023-04-13:
I'm trying to troubleshoot my AVE-HDMI install and can't pin down what's causing these issues.

I have some pretty nasty color banding on the home screen of my Wii.

Certain test images from 240p have serious issues, others do not seem too (or at least ones noticable to me).

And lastly none of my DACs will recognize the sign from

[]()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
 it.

finakechi, 2023-04-13:
> Looks like you have open/shorted/misconnected VData lines. Grab the updater from the latest release, start it, use About->Update to go to the flasher mode, but use the [Diagnostic mode](https://github.com/ikorb/gcvideo/tree/main/Firmware#diagnostics-mode) by hitting right on the IR remote or the D-pad of a Gamecube controller in port 1, it will probably report which lines are affected.

Awesome, I'll give this a shot when I get home and report back.

finakechi, 2023-04-13:
> Looks like you have open/shorted/misconnected VData lines. Grab the updater from the latest release, start it, use About->Update to go to the flasher mode, but use the [Diagnostic mode](https://github.com/ikorb/gcvideo/tree/main/Firmware#diagnostics-mode) by hitting right on the IR remote or the D-pad of a Gamecube controller in port 1, it will probably report which lines are affected.

All right so either I'm having an issue or I'm misunderstanding something.

I go to the update firmware option, and hit the X button on my GameCube controller to activate it. Like I'm already on 3.1

I'm getting a black screen, looks like I'm losing signal.

Where/ when exactly do I hit the right button on the GameCube controller? I'm not getting any diagnostic screen.

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

finakechi, 2023-04-13:
> Looks like you have open/shorted/misconnected VData lines. Grab the updater from the latest release, start it, use About->Update to go to the flasher mode, but use the [Diagnostic mode](https://github.com/ikorb/gcvideo/tree/main/Firmware#diagnostics-mode) by hitting right on the IR remote or the D-pad of a Gamecube controller in port 1, it will probably report which lines are affected.

I apologize if this is very basic stuff I'm asking you.

But how exactly do I get into diagnostic mode?

I downloaded the updater, put it on my SD card.

I attempted to launch it from the Homebrew launcher, and immediately lose my HDMI connection.

Pressing right on my GameCube controller does nothing.

Using the update firmware option in the OSD does the same thing, HDMI connection loss.

I'm not really sure where/when to press Right on my GameCube controller

ikorb, 2023-04-14:
Huh, interesting - the flasher mode uses a simplified video setup that should in theory be very compatible - but it might get confused because your console clearly has some issues with the video signals. If it were my system, I would open it up and use a multimeter to check each signal from the console to the FPGA for continuity and shorts.

It looks like this "AVE-HDMI" thing uses a flat flex cable soldered onto some signal-carrying vias - that sounds like a recipe for just such a disaster to me, but maybe the vendor has some additional troubleshooting guidelines for such cases.

lun7n, 2024-02-13:
> Huh, interesting - the flasher mode uses a simplified video setup that should in theory be very compatible - but it might get confused because your console clearly has some issues with the video signals. If it were my system, I would open it up and use a multimeter to check each signal from the console to the FPGA for continuity and shorts.
>
> It looks like this "AVE-HDMI" thing uses a flat flex cable soldered onto some signal-carrying vias - that sounds like a recipe for just such a disaster to me, but maybe the vendor has some additional troubleshooting guidelines for such cases.

I might have accidentally found the affected traces since I have the exact color banding problem on my ave hdmi board. Going to be totally honest, I messed up my install back when I was very bad at soldering and internally broke two traces from the pad to the fpga, so I had to run magnet wire from the fpga to get continuity. I went from having no signal to having signal but with significant color banding. The affected trace I believe is D2 and 54M.

I was able to run the diagnostics tool and attached below amongst the other pictures are my results:

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

Thread 115 (2023-05-19):

LEDs are red

TrueCrashB, 2023-05-19:
Hi, tonight i soldered everything.
I got no hdmi signal at all.
The two LEDs are red. One is blinking and the other on is always on.
But red LEDs might be not good.
Any idea?

ikorb, 2023-05-19:
Maybe you should ask your board vendor if the LEDs are supposed to have a color other than red?

Closed 2023-05-19.

Thread 117 (2023-06-20):

Corrupt image on some monitors.

michelmohr, 2023-06-20:
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

Is there a known issue or potential fix for this kind of issue with some monitors? Another monitor displays fine. The monitor is not the issue, nor is the cable, tested. Using retro-bit Prism HD adapter.

ikorb, 2023-06-20:
Did you change any settings? Try resetting them to default by using L+R+X+Y+Start to enter the menu.

Also, try asking the manufacturer about this instead of me - they have a custom firmware archive on their web page which seems to imply to me that they changed something. I have no idea what they changed, so I don't know what your device is actually doing.

michelmohr, 2023-06-20:
Ok thank you for taking the time to respond, I'll close the issue then. I'll contact the company for support! :)

Closed 2023-06-20.

Thread 120 (2023-08-18):

Make settings changes for GBIHF more convenient

leo60228, 2023-08-18:
Most GBIHF presets for GCVideo-DVI require changing at least one setting. If you regularly switch between Game Boy and GameCube games, this can be annoying. It'd be nice if there was some form of preset or shortcut functionality for settings, and even better if it could automatically switch when GBIHF is in use (likely based on the video mode?).

Thread 121 (2023-09-11):

Add a mechanism to configure remotes for external adapters without an IR button

vaguerant, 2023-09-11:
Apparently, some manufacturers of external GCVideo adapters don't include an infra-red button on the adapter, which makes configuring an IR remote close to impossible. The example I've been made aware of are the [Bitfunx HDMI Adapter for GameCube](https://www.bitfunx.com/product/bitfunx-hdmi-line-doubler-adapter-gc2hdmi-for-nintendo-gamecube-ngc-digital-to-hdmi/).

An owner of this device described performing a firmware update and the settings being wiped which meant the remote no longer functioned. They then had to disassemble the (glued) adapter casing and short the contacts on the board which would otherwise correspond to an IR button in order to configure their remote again.

The merits of catering to this situation rather than encouraging manufacturers to design their adapters properly can be debated, but for end-users, especially those without the knowledge of how to disassemble a glued case or find and short the correct pins on the board (which is probably a high proportion of users buying cheaper and perhaps less complete GCVideo adapters), that's a bad time.

This means some mechanism to reconfigure an IR remote without a button would be desirable. Below, I'll propose one possible solution; if you have other ideas, feel free to ignore the next two paragraphs.

---

The solution I see would be to have the GCVideo firmware look for some specific (and difficult to reproduce accidentally) video signal coming from the (homebrew-capable) GameCube to indicate that the GCVideo should enter the IR config mode. I have no idea how much of a concern either performance or signal collisions are; if it makes sense to you, maybe it should just run at all times, but I would propose that it makes sense to run this check only on initial start-up of external adapters.

Thus, the IR config process for users who have an external adapter with no (functional) IR button would be to launch a future "GCVideo IR Config Trigger" homebrew app, which displays the designated image, then have the user unplug and re-insert the GCVideo while the app is running (it would make sense for a notice telling a user to do this to be part of the required signal so that they know when it's time to do so). That way, when the GCVideo boots up and performs its IR config signal check, it will encounter the IR config signal and enter config mode.

---

If you do end up going ahead with some alternative IR config trigger, it would presumably only need to run on external adapters, since internal installations can (always?) access the menu using controller input, so any possible degradation in performance (e.g. delay in startup due to looking for IR config signal) would only affect the users most likely to be affected by the issue and would likely be considered an acceptable compromise. If not, the IR config check could be optional--perhaps defaulted to on, since this feature most benefits people who won't have the opportunity to turn it on manually.

ikorb, 2023-09-11:
Working around broken vendor hardware would just encourage more vendors to ship broken hardware, so I refuse to do it. The button is also essential to trigger the rescue mode in case the main flash is corrupted.

The proper way to fix this is to complain to vendors of broken hardware and asking for a full refund - they intentionally sold crippled hardware after all without disclosing this to the buyer.

Closed 2023-09-11.

Thread 124 (2023-12-29):

Brief image with Pluto II

BenoitCaron, 2023-12-29:
Hi,
I've been asked to take a look at a Gamecube which would not output HDMI anymore. The Gamecube had a Pluto II rev E board. I redid all the wiring 4 or 5 times, and face the same issue every single time. Upon startup, the image will briefly appear, and then a black screen.

LED patter seems ok, AV out works, wiring is kept at minimum length.

Any idea?

Regards

https://github.com/ikorb/gcvideo/assets/5237965/9b5fd7ad-b72f-4122-9eb7-83736c8e108c
https://github.com/ikorb/gcvideo/assets/5237965/9899b3b3-b301-4485-9e2e-78add3670485

bryanparadis, 2024-03-01:
Did you check https://www.knjn.com/docs/GCVideo%20mod%20checklist.pdf

Thread 125 (2023-12-30):

Diagnostics mode question

TruREALigion, 2023-12-30:
Not sure if this is the best place to ask:
I recently installed **[Electron Shepherds Wii AVE-HDMI](https://electron-shepherd.com/collections/all/products/ave-hdmi-kit)** and after running the diagnostic mode (firmware update menu) I get the following messages:

**xx** mismatches found, maybe crosstalk?
Bits stuck at 0: none
bits stuck at 1: none
unexpected bits: 1

BClock OK
LRClock OK
AData probably Ok? (**yyy**)

Not able to cable the exact values but:
xx numbers is cycling betwwen 50 - 70
yyy numbers is cycling 200-320

I have probed the VIAs and confirmed that there isn't any issues (ie. bridging).  The flex cable is strange thought as pins near the middle ( around 7-12) seem to be connected to a couple pins at the end.

TruREALigion, 2023-12-30:
Never mind, so it turns out that the via D1 wasn't firmly soldered on.  Added more flux, tinned my iron, dragged it over and everything is great.

Test Pattern Detected
Bits stuck at 0: none
bits stuck at 1: none
unexpected bits: none

BClock OK
LRClock OK
AData probably Ok? (yyy)

Closed 2023-12-30.

Thread 126 (2024-01-26):

How can I switch GCvideo lite 's output from 480i to 480p?

hualazimo7, 2024-01-26:
Checking the readme document, I'd like to ues 480i on my  sony 1410  monitor, so I just left out the pin1 from gamecube, the cable detect pin , and then the output become 480i . However when I connected that pin 1 to cube's pin1 ,the output was also 480i. It didn't suggest me "if you want switch the  output mode"  when I enter the game "Star FOX".
When connected, the voltage at pin1 was 3.3V indeed.
I don't understood the problem, at the very very begin, 480P was successful shown.

ikorb, 2024-01-26:
GCVideo Lite just outputs whatever the game is using, so just switch the game to progressive mode.

ikorb, 2024-01-26:
That's not weird, that is just the game remembering that you said "no" before and not asking again to stop bothering you.

hualazimo7, 2024-01-27:
Sorry fo bothering you again, as you said, I connected the pin1 to the cube and set the  video output of swiss 480i in case the picture corrupted at RGB mode.  At RGB mode, the GBI got black screen no matter what setting it was.
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

While under the component mode,  everything was ok , no matter the Swiss set at 480i or 480p.

Is that the issue discribed at the readme.md?

If so ,  I think I should add a switch in that line.  T.T

Closed 2024-01-26.

Thread 127 (2024-01-29):

Unable to update gcdual past 3.0e

mesterholm, 2024-01-29:
Hello!

I had a gcdual with 3.0d flashed to it and was able to upgrade to dan's v3.0e but I'm unable to upgrad to v3.1 using any of the available .dol images either from this github or dan's versions. I've attached what shows on the screen during my attempts to upgrade. Any thoughts? Thanks in advance!
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

Arrghus8, 2024-04-02:
Did you resolve this issue? If so, which .dol file did you use?

mesterholm, 2024-04-02:
Hi Arrghus,
This was the same problem I had, I was trying to use the GCHD_MK2 .dol files and the one that ended up working was one of the GCDual_ADV7125 .dols.

Closed 2024-01-30.

Thread 128 (2024-02-12):

Still need a fix for Prism/GCVideo Resolution change issues

KampferWolf, 2024-02-12:
I know a lot of changes were made in the past to address some games and it seems to have worked. Forcing Video has worked for some while others have been outright patched back when 3.1 released.

However, games like Rogue Squadron still seem to have an issue where switching between cutscenes causes these interruptions that didn't used to exist back in 2.4a. With devices like the Prism, we don't have the option to downgrade to previous versions to fix these issues.

I'd really love to see a fix for this, even if there was a way to work with Retrobit or others to make a downgrade patch to allow 2.4a. As much as I like some of the newer features, I don't like them as much as fluid gameplay. An outright patch would be amazing.

Really appreciate all the work being done, thank you.

Closed 2024-02-12.

Thread 130 (2024-04-17):

Bitfunx no option to update?

Obleon, 2024-04-17:
Did Bitfunx remove the option to update?

The about section only shows the copyright text but no update button.
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

ikorb, 2024-04-18:
Based on your screenshot it looks like they changed something. If the device has an IR config hardware button you could try to hold that down while powering on the Cube to force-start the flasher instead of the regular firmware - if it exists and they didn't mess with that too.

But you'll have to direct complaints about that to them, I can only help with what is in this repository.

Obleon, 2024-04-18:
Thanks for the great software!
I own a carby and updated the 2.4 with some JTAG to 3.1 some time ago.

Didn't expect Bitfunx to change the software so you can't update with a .dol there also is no ir config button.

I bought this one for a second setup because the website said it could be updated multiple ways with a usb cable but there is no update software or with a .dol even though there is an official video on the website how to do it but they locked that put also.
I think the device is glued shut?

I send a message to bitfunx Before I made this post. I'll let you know if they by some miracle can fix this problem they created on purpose.

Obleon, 2024-04-18:
The button/ir switch is missing and shorting the contacts brings up the remote program menu even on power on of and on again.

So I guess they did change something?

Also tried xilinx jtag but unless they changed the order of the pins vs the carby I'm not getting the flash button in the impact software

The image with the flash is from the carby and the other one with flash missing and unknown bypass is the Bitfunx.

Outlook voor Android downloaden<https://aka.ms/ghei36>
________________________________
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

Closed 2024-04-18.

Thread 132 (2024-06-04):

Feature request: Scale to a standard resolutions for better HDTV compatibility

TriVoxel, 2024-06-04:
I've noticed a lot of inconsistency when trying to play on modern TVs with my Pluto II. Some TVs have black borders, some don't, some stretch the image, other's display as 4:3 and need to be stretched manually, some straight up don't support the output resolution...

How feasable is it to take the internal resolution and interpolate it to a 1280x720, 1366x768, or even a 1920x1080 image? Possibly with filtering options??! That would be a heck of a lot easier to run on modern TVs, and we could apply 16:9 correction for 4:3 games in the integrated menu instead of letting the TV decide what to do with it. I love GC Video, but just wish the TV compatibility could be improved like this...

I'd be happy if this even required a really lightweight upscaling method like nearest neighbor due to memory issues. Of course, I think this feature should be optional, and native resolution output should remain an option but, I'd love to have this ability somehow if at all possible.

ikorb, 2024-06-04:
It is completely infeasible: The FPGA cannot generate signals fast enough for a 1280x720@60Hz DVI signal

TriVoxel, 2024-06-05:
@ikorb Sorry to bother you and continue this discussion but, is it possible a more powerful FPGA device could do such a thing? Or perhaps, even something like a Raspberry Pi could process the video instead?

I know it would essentially require software emulation of the video conversion but, it could yield some cool results? IDK, just trying to think outside the box here, shows how much I really don’t know about these things, haha!

Perhaps a combination of the current FPGA could be coupled with an ARM or RISCV processor to handle the upscaling? I don’t think it would be entirely unfeasible for a manufacturer like the Pluto II’s to make a revised design utilizing a low budget modern processor that has hardware video processing features that can process the HDMI output of the current design. IDK, just thinking out loud here.

Closed 2024-06-04.

Thread 133 (2024-07-09):

Need Legacy FW Version

Slypty, 2024-07-09:
So around 2019 the HDMyCube was released with a Firmware version that was used to program the MX25L4006EM1I SPI.  The design of this PCB was revised for an Internal Panasonic Q HDMI Mod, which is available on GitHub.

 I've made a few of these, but the FW for the MX25L4006EM1I is nowhere around anymore.  I'm hoping it can be resurrected and posted here somehow?  Thanks

Slypty, 2024-07-13:
I think the board design is flawed, it's up on Github here:
https://github.com/HDR/Panasonic-Q-Internal-HDMI-Mod
Though it is handy for anybody who can make a Q PCB, since the breakout board from the Q's ridiculous ribbon to DVI is on the PCB.  A Q Mod would just need the breakout, and to fit the OEM DVI holder. The rest could be copied 1-1 from a Shuriken board. https://github.com/HDR/Panasonic-Q-Internal-HDMI-Mod

Closed 2024-07-13.

Thread 134 (2024-08-15):

OLED65B19LA no signal / blank sceen / black screen

popy2k14, 2024-08-15:
Dear Community.

First, thx a lot for this amazing project, so we can use our GC/Wii's with a more beautiful picture on modern TV's :-)

I have installed an WiiHDMI v0.4 (with newest GCVideo v3.1) into my RVL-CPU-60 Wii.
It's working without any issue on an 6 year old Philips TV.
Also audio and all video modes tested with different games and it's just works.

When i connect it to my main TV LG OLED65B19LA (in the living room, which is ~3 years old),
it does'nt pick up the HDMI signal or the audio and HDMI Input is grayed out in the menu.
TV just shows no signal. Every other device i have thrown at my LG was working (Shield, WiiU, PC, ...)

PS.: The Wii is set to HDTV 480p

What i have tried to fix the issue without success:

- Use different HDMI cable (and the one which is working on the Philips)
- Use different HDMI input on the LG
- Use Denon AVR-x2400h in between
- Tried Enhanced DVI off/on and other advanced settings
- Masure HDMI 5V & DDC -> OK
- Check/Update OLED TV Firmware to 03.40.82

It's was always the same, it did'nt pick up the HDMI signal and HDMI Input is grayed out in the menu.

**I had an old 1080p FullHD HDMI muxer (3 in & 1 out) laying around and yeah, that fixed the issue completely!!!!**
I think every cheap HDMI splitter will solve such issues, because it does the handshake with the TV correctly.

So why i am posting this when it's fixed.
Maybe somone else is having similar issues and this could help.

Also maybe there are some handshake issues in the current GCVideo to the LG OLED.

popy2k14, 2024-12-23:
@zardam thx a lot for pointing this out.
Now found time to look at it and guess what?

Yeah, my HDMI board had a 10k!! (way to high) pull up to 5V.
Back then i measured the 5V on the HDMI and it was ok, but just unconnected (unloaded) on the other side.

After replacing the 10k resistor to an 0 Ohm bridge, all is working as expected and the issue is solved!
Thx a lot!!!!!!
Sadly i did not had any resistors with low value and the correct size laying around.
I hope the Wii has an current limiter on the USB ports, so that would not be an issue in the future.

Closed 2024-12-23.

Thread 135 (2024-08-19):

[Bug] Either Strange Interpolation or Bad Color Sampling

DeadSkullzJr, 2024-08-19:
I can't put an exact pinpoint on what causes this, but I can at least describe the issue and supply screenshots. There appears to be very strange and incorrect handling of color information when using the RGB or YC444 options respectively, YC422 seems to be fine (which I expected). Interpolation isn't perfect, but the weird nature of the pixel information really screams "bug" rather than a normal occurrence. This issue in question adds more color information than there needs to be for a 4:4:4 interpolated signal, thus impacting the size of screenshots taken and video captures regardless of the codecs and formats utilized. From what I understand, what you will see in the screenshots isn't supposed to happen.

Screenshots:

YC422
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

YC444
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

RGB
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

YC422 vs YC444 _(Gray means no differences, red means differences)_
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

YC422 vs RGB _(Gray means no differences, red means differences)_
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

YC444 vs RGB _(Gray means no differences, red means differences)_
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

GK6475, 2024-10-29:
Does disabling chroma interpolation help?

Thread 139 (2024-12-02):

hi everyone need help!thanks first

wei134102, 2024-12-02:
GC VIDEO wii
board wmi-0 github 4 lay board!RVL-CPU-40
firmware:   gcvideo-3.1-shuriken-v3-wii

this is my forth gc video for wii,when i open the scan line,it happend!the last there pic!what is wrong?need your help!

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

wei134102, 2024-12-09:
Solved，hare ware line problem,closed

Closed 2024-12-09.

Thread 140 (2024-12-05):

Pluto-IIx GC No signal and not recognized by PC

Austin-2, 2024-12-05:
Hi,

I wired up my Pluto-IIx GC to my DOL-001 GC (Not sure if it matters but the sellers listed it as a Japanese console changed to be English). I used the ribbon cable install. I tested the connections and it appears everything is wired fine. Got a little violent getting the digital port out so not sure if that can be the issue. Analog now only has working audio.

HDMI cable is recognized when plugged in, but both a monitor and PC say no signal. The LED stays orange when powered on, so reading the checklist, made me think the board was not programmed. I tried to program myself but when plugging into my PC, I do not see the device recognized as a com port.

Is my board broken or is there any way to troubleshoot if the board can be programmed. Currently it is wired into my Gamecube (5v is removed to not cause power issues).

Thread 141 (2025-02-01):

Settings Reset When using GCdual and 8BitDo Receiver together

papa-MG, 2025-02-01:
Hi,

Found out that using the 8BitDo GameCube receiver ([Retro Receiver for NGC](https://www.8bitdo.com/ngc-retro-receiver/)) with my GameCube using a GCdual causes the settings to reset.

- If the system boots without this receiver plugged in, the settings will load up as they are stored, but the moment you plug in the receiver, the settings reset to default and the GCVideo menu appears.
- This is still the case when the receiver is plugged in before booting, the settings get reset and GCVideo menu appears.

I'm not sure how a Bluetooth controller adapter is causing the settings to get defaulted, unless there is button combination to reset the GCVideo settings?

I've uploaded a video where you can see that anytime it's unplugged, you can hear the audio and see the scanline settings I've applied. When plugged in, you can see them disappear. Video [here](https://youtu.be/gXRwBc2fiP0).

ikorb, 2025-02-01:
There is indeed a button combination to reset settings to default: Hold Start+L+R+X+Y to call up the menu. Maybe the receiver responds as if it were a pad with all buttons held during its initialization?

papa-MG, 2025-02-01:
That's probably the issue then, I quickly picked up a controller tester homebrew to see if I could replicate but no buttons appear to be pressed when I plug it in, I'm assuming it's happening so quick the tester doesn't display it.

I also saw that plugging it back in over and over always opens the GCVideo menu.

Any way I can disable the reset combination?

ikorb, 2025-02-01:
No, unless you want to change it in the source code and rebuild (which I can't do at this time)

papa-MG, 2025-02-01:
I did try to take a look at rebuilding this but I think that's outside my wheelhouse, I'll have to wait for an update from  you/someone else, sorry.

Anakiev2, 2025-02-11:
@papa-MG I have few Ideas I hope I can explain them:
Try to plug the receiver really slowly. The GND and VCC pins are longer than the data pin. The idea is to power the receiver but without the data pin connected. Try few time it may work.
If you remove the button combination for resetting the settings will still bring the gc-video menu. Some kind of delay to check if the button combination is being held maybe is better.
You can desolder the wire between the gc-video and the data pin (or to solder it to a different player data pin).

Anakiev2, 2025-02-17:
I've successfully build identical binaries:
```
Files orig/gcvideo-dvi-shuriken-gc-3.1-M25P40-complete.xsvf and mine/gcvideo-dvi-shuriken-gc-3.1-M25P40-complete.xsvf are identical
Files orig/gcvideo-dvi-shuriken-gc-3.1-spirom-complete.bin and mine/gcvideo-dvi-shuriken-gc-3.1-spirom-complete.bin are identical
Files orig/gcvideo-dvi-shuriken-gc-3.1-spirom-impact.cfi and mine/gcvideo-dvi-shuriken-gc-3.1-spirom-impact.cfi differ
Files orig/gcvideo-dvi-shuriken-gc-3.1-spirom-impact.mcs and mine/gcvideo-dvi-shuriken-gc-3.1-spirom-impact.mcs are identical
```
@ikorb This is what I plan but I accept better ideas:
```diff
--- Firmware/screen_idle.c	2025-02-17 18:14:02.040577077 +0200
+++ screen_idle.c	2025-02-17 18:14:16.860650168 +0200
@@ -57,11 +57,6 @@
     /* check for menu button combination on controller */
     if ((pad_buttons & (PAD_L | PAD_R | PAD_X | PAD_Y)) == (PAD_L | PAD_R | PAD_X | PAD_Y) &&
         time_after(now, pad_last_change + HZ)) {
-      if (pad_buttons & PAD_START) {
-        /* restore defaults */
-        settings_init();
-        settings_commit();
-      }
       return;
     }
```

@papa-MG Do you know how to program the memory with either spi programmer or jtag. I don't plan on making updater because It's really easy to brick your device and you can't recover without a programmer.

ikorb, 2025-02-17:
You can always force-enter the flasher mode by holding the IR config button at powerup, so recovery without a programmer should be possible.

Anakiev2, 2025-02-17:
I am not sure if I can resolve all dependencies for building the updater .dol file and if screw something up many boards will be bricked.

> You can always force-enter the flasher mode by holding the IR config button at powerup, so recovery without a programmer should be possible.

I don't understand that. I thought holding the IR button only resets the settings to the defaults.

ikorb, 2025-02-17:
> I don't understand that. I thought holding the IR button only resets the settings to the defaults.

Different starting states - holding it while turning on the console enters the flasher mode, holding it while the console is already on and you enter the regular GCVideo OSD resets settings to default.

papa-MG, 2025-02-17:
Hey, sorry have been busy.

For the meantime I have been using a workaround where I power the receiver using the USB C port on the front connected to my tv, this has prevented the settings being reset on boot.

I do not own an spi/jtag programmer so not currently possible for me to update my GCDual that way.

Anakiev2, 2025-02-17:
I will try to make the updater. If I succeed will upload the files.
btw I use ch341a programmer it's very cheap from china.

Anakiev2, 2025-02-17:
I've got so much struggle with `devkitPro` and `devkitPPC` after I've made them working I saw the `gcvupdater.dol` and `gcvupdater.dol` are prebuild. I didn't heed  `devkitPro` and `devkitPPC` in the first place.
Will start fresh tomorrow to see what will happen.

Anakiev2, 2025-02-18:
> For the meantime I have been using a workaround where I power the receiver using the USB C port on the front connected to my tv, this has prevented the settings being reset on boot.

This is similar to my initial suggestion above. But the way you do it most likely feeds back 5v to the Gamecube (if the console is turn off) then when you turn it on you short the two 5v rails to each other.

> Try this: power on the Gamecube, plug the receiver partially until you see the blue light from the receiver, wait about a second or two (or wait for the wireless controller to pair), then plug the receiver fully. Because GND and VCC pins are longer than the data pin the idea is to power the receiver but without the data pin being connected. This way it's possible for the Gamecube to miss some data and not reset the settings...

Anakiev2, 2025-02-19:
# CAUTION:
## The files you are about to download haven't been tested! There is a risk of damage! If you decide to install them anyway than do it on your own risk.

This is modification of the original GCVideo-DVI 3.1 firmware with the button combination for resetting the settings removed to solve a problem with the 8BitDo bluetooth receiver. The GCVideo OSD will still appear but the settings won't reset. It's compatible with all boards not just dual-gc.

[GCVideo-DVI 3.1-noConfigReset-v1.zip](https://github.com/user-attachments/files/18865612/GCVideo-DVI.3.1-noConfigReset-v1.zip)

papa-MG, 2025-02-20:
Thanks for that, have just tried to give it a go but I get a message "No firmware for "DK07" found" when trying to update.

Saw from other issues raised that I'll need to contact where I got my GCDual from as they have made proprietary changes.

Anakiev2, 2025-02-20:
Oh, that's such a shame and waste of time. Actually I was working on much better solution but without their version of the source code there is nothing I can do. I'll give you all changes I have in mind and you can contact them to fix it for you. But the problem is in the Bluetooth receiver you better contact them.

This one disables the button combination for the first 10 seconds after boot.
```diff
@@ -56,7 +56,7 @@

     /* check for menu button combination on controller */
     if ((pad_buttons & (PAD_L | PAD_R | PAD_X | PAD_Y)) == (PAD_L | PAD_R | PAD_X | PAD_Y) &&
-        time_after(now, pad_last_change + HZ)) {
+        time_after(now, pad_last_change + HZ) && now > HZ * 10) {
       if (pad_buttons & PAD_START) {
         /* restore defaults */
         settings_init();
```

This one increases the time you have to hold the button combination from 1 to 3 seconds.
```diff
@@ -56,7 +56,7 @@

     /* check for menu button combination on controller */
     if ((pad_buttons & (PAD_L | PAD_R | PAD_X | PAD_Y)) == (PAD_L | PAD_R | PAD_X | PAD_Y) &&
-        time_after(now, pad_last_change + HZ)) {
+        time_after(now, pad_last_change + HZ * 3)) {
       if (pad_buttons & PAD_START) {
         /* restore defaults */
         settings_init();
```

The following two are improvment of "v1" I gave you but without the OSD poping up.
```diff
@@ -58,9 +58,8 @@
     if ((pad_buttons & (PAD_L | PAD_R | PAD_X | PAD_Y)) == (PAD_L | PAD_R | PAD_X | PAD_Y) &&
         time_after(now, pad_last_change + HZ)) {
       if (pad_buttons & PAD_START) {
-        /* restore defaults */
-        settings_init();
-        settings_commit();
+        /* ignore */
+        continue
       }
       return;
     }
```
```diff
@@ -55,13 +55,7 @@
     tick_t now = getticks();

     /* check for menu button combination on controller */
-    if ((pad_buttons & (PAD_L | PAD_R | PAD_X | PAD_Y)) == (PAD_L | PAD_R | PAD_X | PAD_Y) &&
-        time_after(now, pad_last_change + HZ)) {
-      if (pad_buttons & PAD_START) {
-        /* restore defaults */
-        settings_init();
-        settings_commit();
-      }
+    if (pad_buttons == (PAD_L | PAD_R | PAD_X | PAD_Y) && time_after(now, pad_last_change + HZ)) {
       return;
     }
```

papa-MG, 2025-02-21:
Just to follow up on this, 8BitDo said the following when I raised this to their support. I mentioned that all buttons are being pressed when initialised which causes issues with GCvideo.

"We appreciate your support of 8BitDo products! For your information, the NGC retro receiver was specially designed for the original, unmodified and vanilla console, so we cannot guarantee the compatibility or feasibility between the NGC retro receiver and a modified NGC console. Thank you for your understanding!"

At this point, I may just fork out the money and get an internal adapter from lazer bear....

papa-MG, 2025-02-21:
I see, I did go back to 8BitDo stating my frustrations and they came back with a beta for the next firmware version, this hasn't fixed it though. I'll update here on the conclusion with the 8BitDo ticket when possible.

Anakiev2, 2025-02-22:
@ikorb What is the potential risk if we force install the open source firmware? For example if they use different pins and we send voltage on signals we should only listen to. Can this damage the TV/GameCube/GCVideo?

@papa-MG Do you have the ability to control the GCVideo menu with IR remote? Also do you have updater .dol file which works on your GameCube? One you've used before to update or is there a website you can download it?

ikorb, 2025-02-23:
If two outputs are working against each other that is at least in "not good" territory and if it's a Wii and the console-side output is the video data bus, it's probably in the "extremely not good" territory because the Wii runs its logic at 1.8V but the FPGA would try to send 3.3V on its output.

Extremious, 2025-03-19:
This fork adds four extra settings. The "Hold Time" option addresses this issue, just increase the value and save the settings. The other options are things I've added for myself.

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

https://github.com/Extremious/gcvideo-Xtra

Thread 142 (2025-02-02):

Audio Issue

frankoleka, 2025-02-02:
HDMI is working on my monitor however I am not getting any audio out. I changed to enhanced DVI mode hoping for a quick fix but no luck.

Mav1011, 2025-02-06:
I’m having the same issue. The board is usb-c rev-c. DVI mode is on but no audio.

Thread 143 (2025-03-01):

RAM overlapping issue.

Extremious, 2025-03-01:
Hi, @ikorb, thank you for this awesome project! I've added four extra options to the OSD menu, which I want for myself, controlled by 3 uint8_t variables (resbox_x, resbox_y, resbox_time). Everything worked fine until I started changing with the scanlines settings. Then I saw my variables were reset to 0. I struggle to find a solution. Could you please help me out?

This is the source https://github.com/Extremious/gcvideo

ikorb, 2025-03-01:
Memory is extremely tight since everything (code+data+stack) has to live within just 16KB. If I remember correctly there was about 100 bytes available in the release version, so if you add code and data and exceed that, some data may be clobbered by the stack at runtime.

Extremious, 2025-03-02:
Thank you for the fast reply. I have two more questions.

1. How do I check the available RAM?
2. I've made rough calculations, with my modifications I've added about 75 bytes for variables and strings (without counting the rest). My board doesn't have IR receiver I don't need the IR menu. If I delete 'screen_irconfig.c' and all related references, this will remove 122 bytes from strings only. Will this be enough?

ikorb, 2025-03-02:
>     1. How do I check the available RAM?

Basically instrument the code and/or hardware to track the lowest address of the stack pointer while you try to exercise as much of the code as possible and compare that with the highest used address which you can calculate from the output of "zpu-elf-size -A the-linked-file.elf" by looking for the highest address given (probably the .bss section) and adding the size of that section to it.

>     2. I've made rough calculations, with my modifications I've added about 75 bytes for variables and strings (without counting the rest). My board doesn't have IR receiver I don't need the IR menu. If I delete 'screen_irconfig.c' and all related references, this will remove 122 bytes from strings only. Will this be enough?

Probably

Extremious, 2025-03-04:
I've found an acceptable solution I think it's fine but I am scared to try it. Could you look my latest commit?
https://github.com/Extremious/gcvideo/commit/f8f6fa73ed6223f23ce65d1386a59d7020a776b9
I've reduced the scanline profiles by 1 and use the memory as free. I am not sure if the VHDL stuff will mess up the 'freed' memory.

Extremious, 2025-03-05:
I've tried it's the same as before. I thought this will free 1k of memory. I don't understand, why didn't work?

ikorb, 2025-03-05:
That commit will only free up a few bytes in the initialization. SCANLINERAM is a pointer to a memory block in the scanline generator, using less of it won't affect the main memory usage.

Extremious, 2025-03-05:
How stupid of me. Actually it's good the last commit didn't work otherwise I would have thought that I did it.
Removing the infrared menu worked well so this will be the solution. I wanted to do better but I don't understand VHDL and I give up.
Thank you for everything! You are awesome!

Extremious, 2025-03-15:
Please, I promise I won't bother you with more questions.

Closed 2025-03-19.

Thread 144 (2025-03-03):

Video flashing in one Tony Hawk's American Wasteland

pepsison52, 2025-03-03:
First, I love this mod! Thanks for making it! The only issue I have is that THAW is unplayable as the HDMI signal drops out every second or so. I tried 480i, 480p, enhanced DVI on and off, but no change. It still works fine over the analog AV connection so it doesn't seem to be an issue with my GameCube.

Anakiev2, 2025-03-04:
I play this game often and I haven't seen a single issue. I used to have video drop before on every game but I've bought higher quality HDMI cable. You can also try to clean the contacts with IPA and paint brush.

pepsison52, 2025-03-04:
Thanks for the input. Unfortunately, I've tried different cables and devices with no luck. I also found that it seems to do it randomly in some games, never in others, and constantly in THAW. I was doing some more research and I'm actually wondering if this is some kind of power supply issue where it just can't keep up between the original hardware (depending on the game's demand), Picoboot, and the Pluto board.

pepsison52, 2025-03-04:
Not sure if it helps, but I got a bit more info: If I fire up the GameCube after a while, everything works fine for a few minutes, and then it gets worse after a little while.

Anakiev2, 2025-03-06:
May need to replace the electrolytic capacitors. It's usually backwards they work fine after they worm up not before.

pepsison52, 2025-03-06:
Would that be the ones in the power board in the bottom of the system? I know that the ones in the disc drive can cause weird issues, but I'm playing from an SD card.

Anakiev2, 2025-03-06:
> Would that be the ones in the power board in the bottom of the system?

I think yes but also the ones in the power supply.
Try to play with the disc drive removed, it may improve. But do not remove it while playing only if you can boot without disc drive.

pepsison52, 2025-03-06:
Sounds good. Thanks for the input. I was debating installing a USB-C power mod anyway, so I might just do that to eliminate the old brick, and recap the internal power board at the same time.

Thread 146 (2025-05-09):

Downgrade BitFunx  3.1 to 2.4

Nicoluslog, 2025-05-09:
I've seen various threads talking about black screen problems when changing resolution in the Star Wars: Rogue Squadron II and III games on Gamecube. I'd like to know if it's possible to upgrade my BitFunx to an earlier firmware version (2.4c or 2.4d)? If so, how do I go about it?

Thank you in advance.

GK6475, 2025-07-20:
> I've seen various threads talking about black screen problems when changing resolution in the Star Wars: Rogue Squadron II and III games on Gamecube. I'd like to know if it's possible to upgrade my BitFunx to an earlier firmware version (2.4c or 2.4d)? If so, how do I go about it?
>
> Thank you in advance.

I'm pretty sure that the only way to downgrade is to manually program it using a JTAG programmer or similar. Are you switching the resolution to progressive scan? If so, you might have some luck by forcing the game to run in 480p through Swiss instead. Also, there should be a "crop 486 to 480" option that you could try, since some games run in that odd resolution (which isn't supported by all TVs, and could cause the black screen that you're describing). "Fix resolution" may also help.

Thread 147 (2025-07-23):

GCVideo 5.3 has trouble booting. Blips the blue LED twice and turns off

bansheebeats94, 2025-07-23:
Hi there. Been having some finicky performance from the GCVideo mod. I am sometimes able to *trick* it into outputting 480p RGB through the analogue av port to SCART to BNC.

Looks like something is going on. I have used the voltmeter to make sure that it’s getting 3.3V which it seems like it is. All the groundings seem to be beeping as they should.

I think I am aiming for a blinking LED? Either way. I’m having these issues.

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

Appreciate anyone who can point me in the right direction

<!-- Failed to upload "IMG_0597.mov" -->

bansheebeats94, 2025-07-23:
https://github.com/user-attachments/assets/c74590dd-8039-4098-95b1-9ec2c9a2d6a0

bansheebeats94, 2025-07-23:
https://github.com/user-attachments/assets/a5431a1c-cc53-4bce-b904-cc52cd855d4d
