ikorb/gcvideo/Hardware/gcvideo_lite_09/gcvideo_lite.pdf

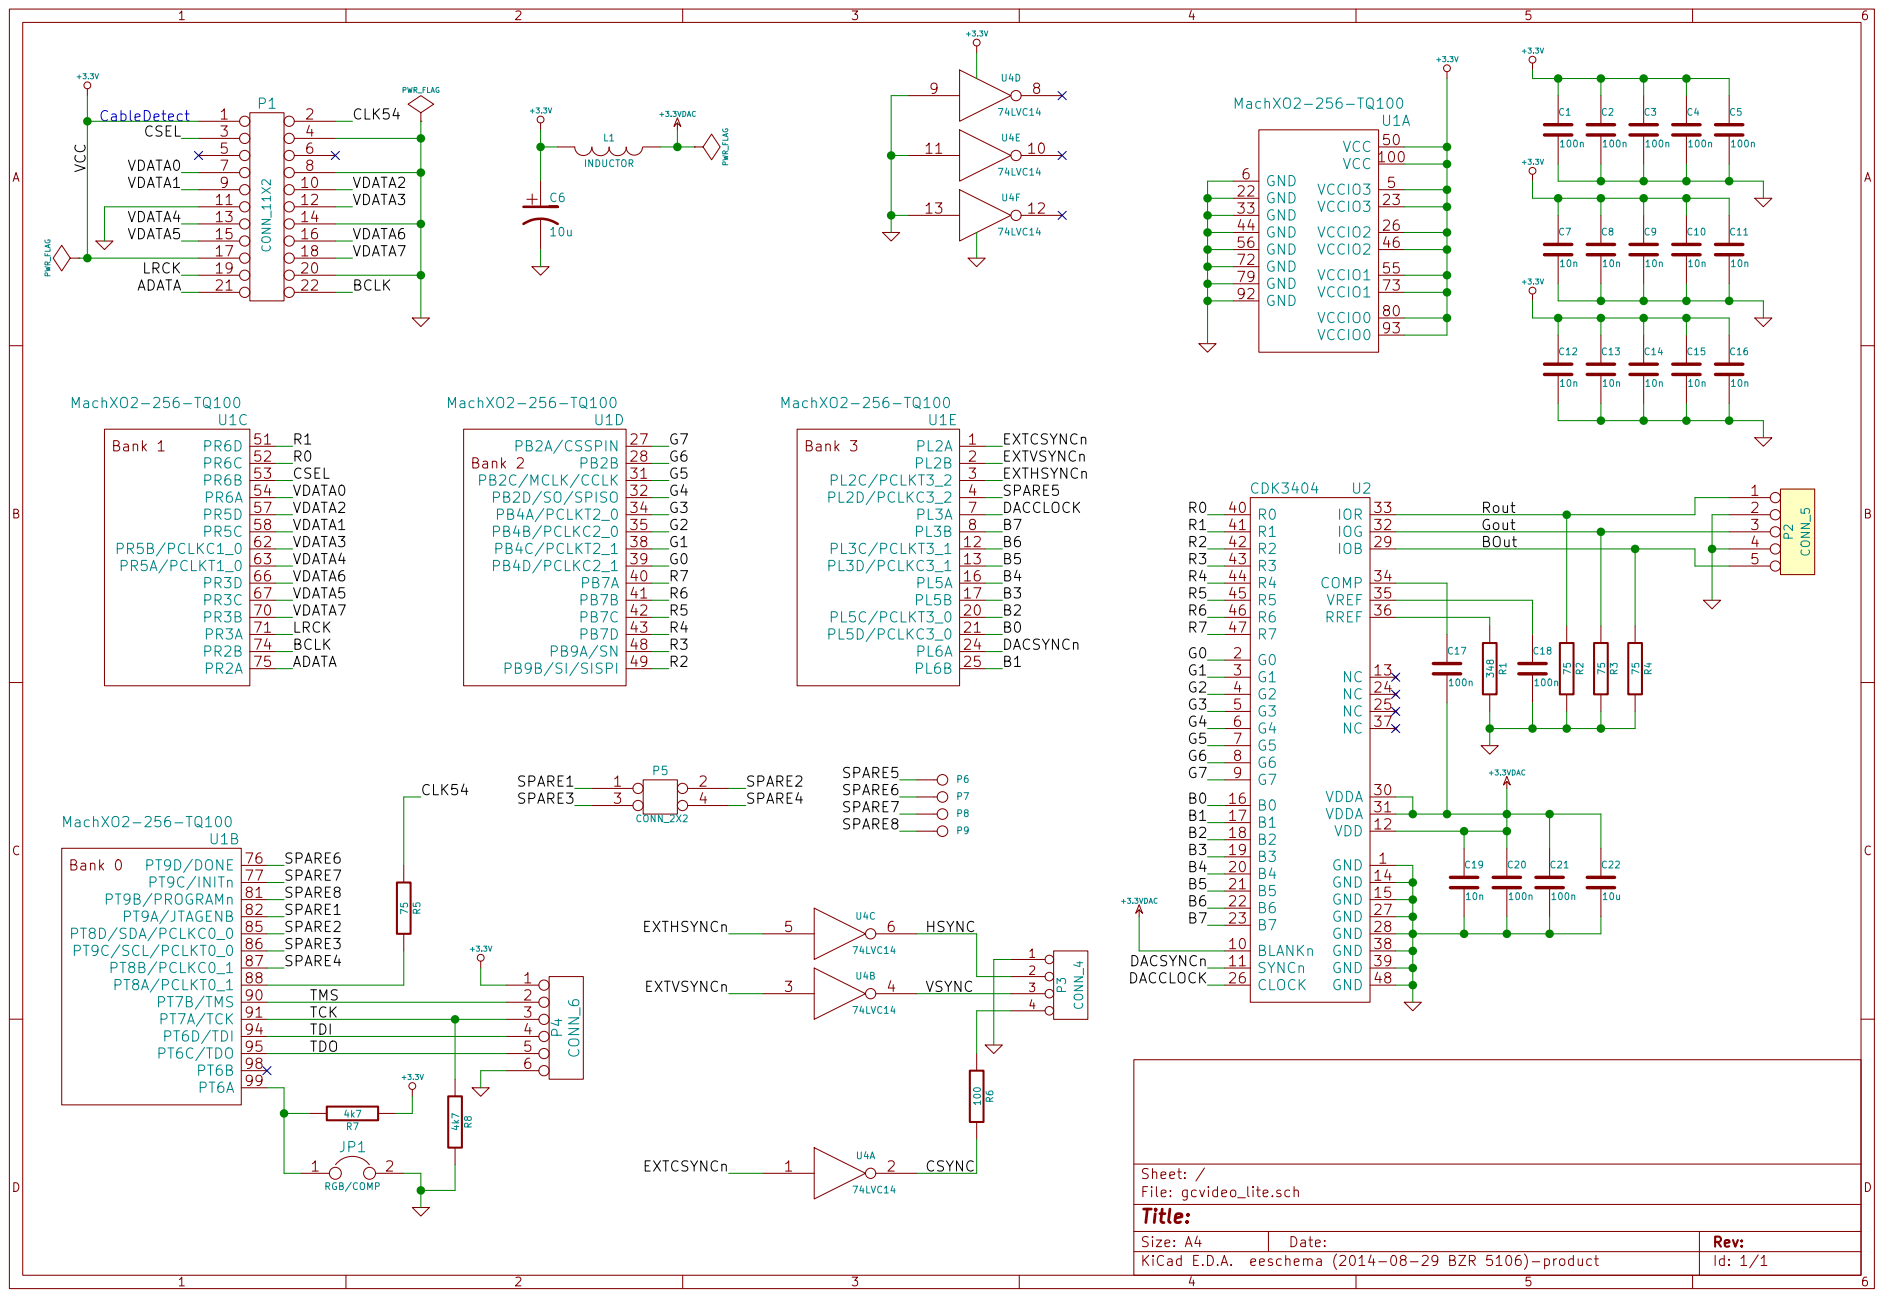
[picture p20: page 1]
