ikorb/gcvideo/Hardware/gcvideo_lite_09/gcvideo_lite.kicad_pcb

## KiCad design Hardware/gcvideo_lite_09/gcvideo_lite.kicad_pcb (2014-08-31)

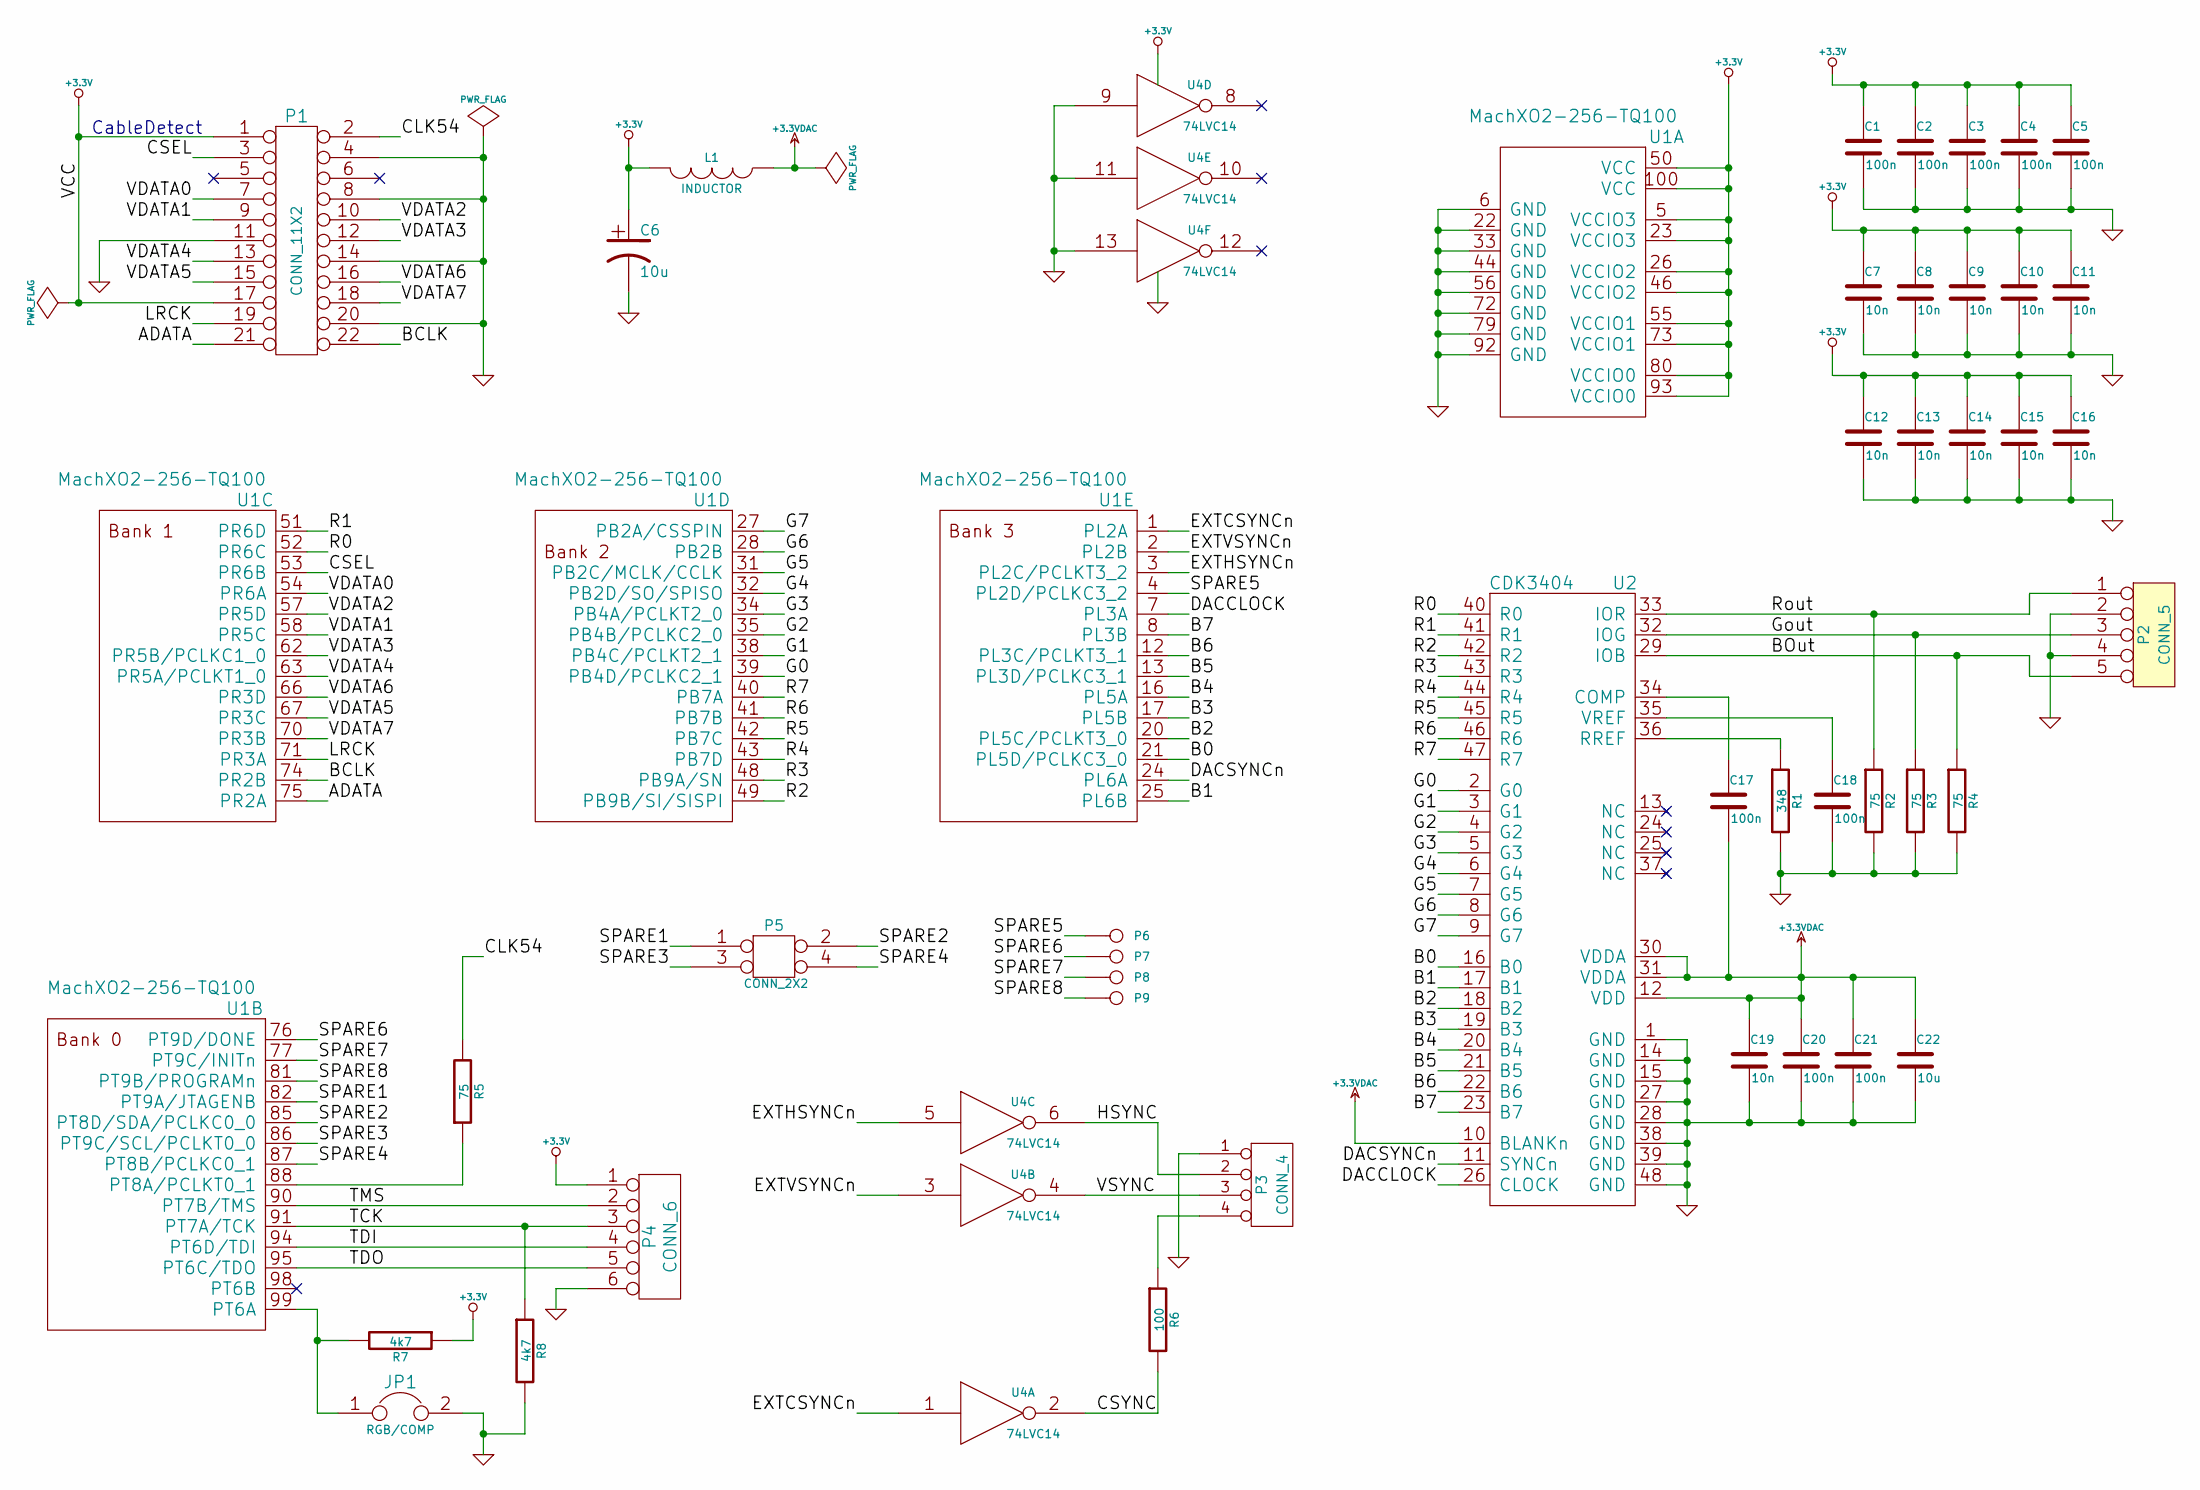
[picture p21: schematic gcvideo_lite.sch]

Parts:
C1, C2, C3, C4, C5, C17, C18, C20, C21: 100n
C6, C22: 10u
C7, C8, C9, C10, C11, C12, C13, C14, C15, C16, C19: 10n
JP1: RGB/COMP
L1: INDUCTOR
P1: CONN_11X2
P2: CONN_5
P3: CONN_4
P4: CONN_6
P5: CONN_2X2
P6, P7, P8, P9: CONN_1
R1: 348
R2, R3, R4, R5: 75
R6: 100
R7, R8: 4k7
U1: MachXO2-256-TQ100
U2: CDK3404
U4: 74LVC14

Connections:
+3.3V: C1.1, C2.1, C3.1, C4.1, C5.1, C6.1, C7.1, C8.1, C9.1, C10.1, C11.1, C12.1, C13.1, C14.1, C15.1, C16.1, L1.2, P1.1, P1.17, P4.1, R7.1, U1.5 (VCCIO3), U1.23 (VCCIO3), U1.26 (VCCIO2), U1.46 (VCCIO2), U1.50 (VCC), U1.55 (VCCIO1), U1.73 (VCCIO1), U1.80 (VCCIO0), U1.93 (VCCIO0), U1.100 (VCC), U4.14 (VCC)
+3.3VDAC: C17.2, C19.1, C20.1, C21.1, C22.1, L1.1, U2.10 (BLANKn), U2.12 (VDD), U2.30 (VDDA), U2.31 (VDDA)
/ADATA: P1.21, U1.75 (PR2A)
/B0: U1.21 (PL5D/PCLKC3_0), U2.16 (B0)
/B1: U1.25 (PL6B), U2.17 (B1)
/B2: U1.20 (PL5C/PCLKT3_0), U2.18 (B2)
/B3: U1.17 (PL5B), U2.19 (B3)
/B4: U1.16 (PL5A), U2.20 (B4)
/B5: U1.13 (PL3D/PCLKC3_1), U2.21 (B5)
/B6: U1.12 (PL3C/PCLKT3_1), U2.22 (B6)
/B7: U1.8 (PL3B), U2.23 (B7)
/BCLK: P1.22, U1.74 (PR2B)
/BOut: P2.5, R4.1, U2.29 (IOB)
/CLK54: P1.2, R5.2
/CSEL: P1.3, U1.53 (PR6B)
/CSYNC: R6.2, U4.2
/DACCLOCK: U1.7 (PL3A), U2.26 (CLOCK)
/DACSYNCn: U1.24 (PL6A), U2.11 (SYNCn)
/EXTCSYNCn: U1.1 (PL2A), U4.1
/EXTHSYNCn: U1.3 (PL2C/PCLKT3_2), U4.5
/EXTVSYNCn: U1.2 (PL2B), U4.3
/G0: U1.39 (PB4D/PCLKC2_1), U2.2 (G0)
/G1: U1.38 (PB4C/PCLKT2_1), U2.3 (G1)
/G2: U1.35 (PB4B/PCLKC2_0), U2.4 (G2)
/G3: U1.34 (PB4A/PCLKT2_0), U2.5 (G3)
/G4: U1.32 (PB2D/SO/SPISO), U2.6 (G4)
/G5: U1.31 (PB2C/MCLK/CCLK), U2.7 (G5)
/G6: U1.28 (PB2B), U2.8 (G6)
/G7: U1.27 (PB2A/CSSPIN), U2.9 (G7)
/Gout: P2.3, R3.1, U2.32 (IOG)
/HSYNC: P3.2, U4.6
/LRCK: P1.19, U1.71 (PR3A)
/R0: U1.52 (PR6C), U2.40 (R0)
/R1: U1.51 (PR6D), U2.41 (R1)
/R2: U1.49 (PB9B/SI/SISPI), U2.42 (R2)
/R3: U1.48 (PB9A/SN), U2.43 (R3)
/R4: U1.43 (PB7D), U2.44 (R4)
/R5: U1.42 (PB7C), U2.45 (R5)
/R6: U1.41 (PB7B), U2.46 (R6)
/R7: U1.40 (PB7A), U2.47 (R7)
/Rout: P2.1, R2.1, U2.33 (IOR)
/SPARE1: P5.1, U1.82 (PT9A/JTAGENB)
/SPARE2: P5.2, U1.85 (PT8D/SDA/PCLKC0_0)
/SPARE3: P5.3, U1.86 (PT9C/SCL/PCLKT0_0)
/SPARE4: P5.4, U1.87 (PT8B/PCLKC0_1)
/SPARE5: P6.1, U1.4 (PL2D/PCLKC3_2)
/SPARE6: P7.1, U1.76 (PT9D/DONE)
/SPARE7: P8.1, U1.77 (PT9C/INITn)
/SPARE8: P9.1, U1.81 (PT9B/PROGRAMn)
/TCK: P4.3, R8.1, U1.91 (PT7A/TCK)
/TDI: P4.4, U1.94 (PT6D/TDI)
/TDO: P4.5, U1.95 (PT6C/TDO)
/TMS: P4.2, U1.90 (PT7B/TMS)
/VDATA0: P1.7, U1.54 (PR6A)
/VDATA1: P1.9, U1.58 (PR5C)
/VDATA2: P1.10, U1.57 (PR5D)
/VDATA3: P1.12, U1.62 (PR5B/PCLKC1_0)
/VDATA4: P1.13, U1.63 (PR5A/PCLKT1_0)
/VDATA5: P1.15, U1.67 (PR3C)
/VDATA6: P1.16, U1.66 (PR3D)
/VDATA7: P1.18, U1.70 (PR3B)
/VSYNC: P3.3, U4.4
GND: C1.2, C2.2, C3.2, C4.2, C5.2, C6.2, C7.2, C8.2, C9.2, C10.2, C11.2, C12.2, C13.2, C14.2, C15.2, C16.2, C18.2, C19.2, C20.2, C21.2, C22.2, JP1.2, P1.4, P1.8, P1.11, P1.14, P1.20, P2.2, P2.4, P3.1, P4.6, R1.2, R2.2, R3.2, R4.2, R8.2, U1.6 (GND), U1.22 (GND), U1.33 (GND), U1.44 (GND), U1.56 (GND), U1.72 (GND), U1.79 (GND), U1.92 (GND), U2.1 (GND), U2.14 (GND), U2.15 (GND), U2.27 (GND), U2.28 (GND), U2.38 (GND), U2.39 (GND), U2.48 (GND), U4.7 (GND), U4.9, U4.11, U4.13
unnamed: C17.1, U2.34 (COMP)
unnamed: C18.1, U2.35 (VREF)
unnamed: JP1.1, R7.2, U1.99 (PT6A)
unnamed: P3.4, R6.1
unnamed: R1.1, U2.36 (RREF)
unnamed: R5.1, U1.88 (PT8A/PCLKT0_1)

Notes on the sheet:
CableDetect

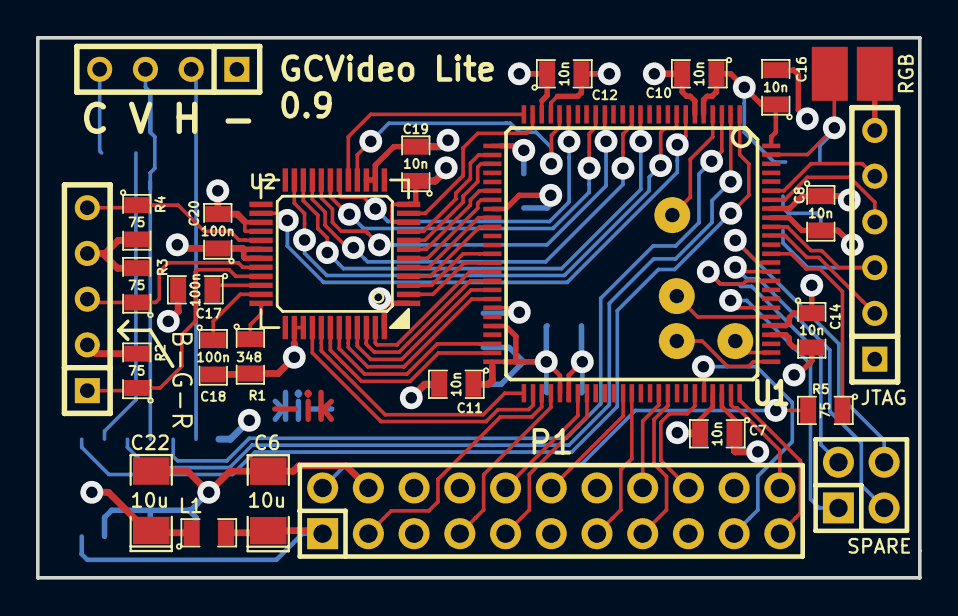
[picture p22: board gcvideo_lite.kicad_pcb from above]

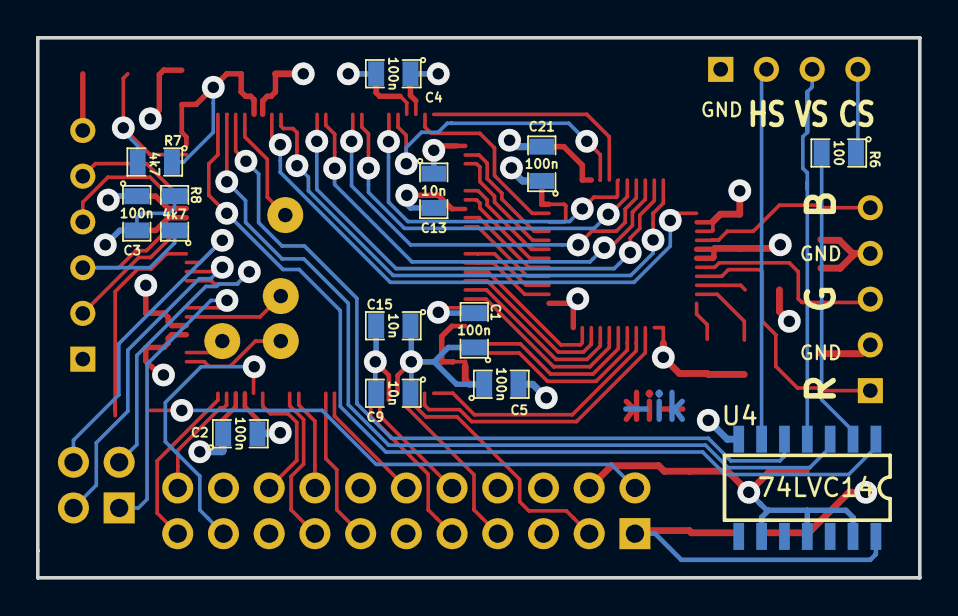
[picture p23: board gcvideo_lite.kicad_pcb from below]

Board: 4 copper layers, 49.0 x 30.0 mm, 44 parts (13 on the bottom side), 69 nets.
