ikorb/gcvideo/HDL/gcvideo_dvi/src/toplevel_wiidual.vhd

----------------------------------------------------------------------------------
-- GCVideo DVI HDL
-- Copyright (C) 2014-2021, Ingo Korb <ingo@akana.de>
-- All rights reserved.
--
-- Redistribution and use in source and binary forms, with or without
-- modification, are permitted provided that the following conditions are met:
--
-- 1. Redistributions of source code must retain the above copyright notice,
--    this list of conditions and the following disclaimer.
-- 2. Redistributions in binary form must reproduce the above copyright notice,
--    this list of conditions and the following disclaimer in the documentation
--    and/or other materials provided with the distribution.
--
-- THIS SOFTWARE IS PROVIDED BY THE COPYRIGHT HOLDERS AND CONTRIBUTORS "AS IS"
-- AND ANY EXPRESS OR IMPLIED WARRANTIES, INCLUDING, BUT NOT LIMITED TO, THE
-- IMPLIED WARRANTIES OF MERCHANTABILITY AND FITNESS FOR A PARTICULAR PURPOSE
-- ARE DISCLAIMED. IN NO EVENT SHALL THE COPYRIGHT HOLDER OR CONTRIBUTORS BE
-- LIABLE FOR ANY DIRECT, INDIRECT, INCIDENTAL, SPECIAL, EXEMPLARY, OR
-- CONSEQUENTIAL DAMAGES (INCLUDING, BUT NOT LIMITED TO, PROCUREMENT OF
-- SUBSTITUTE GOODS OR SERVICES; LOSS OF USE, DATA, OR PROFITS; OR BUSINESS
-- INTERRUPTION) HOWEVER CAUSED AND ON ANY THEORY OF LIABILITY, WHETHER IN
-- CONTRACT, STRICT LIABILITY, OR TORT (INCLUDING NEGLIGENCE OR OTHERWISE)
-- ARISING IN ANY WAY OUT OF THE USE OF THIS SOFTWARE, EVEN IF ADVISED OF
-- THE POSSIBILITY OF SUCH DAMAGE.
--
-- toplevel_wiidual.vhd: top level module for the WiiDual boards
--
----------------------------------------------------------------------------------

library IEEE;

use IEEE.STD_LOGIC_1164.ALL;
use IEEE.NUMERIC_STD.ALL;
library UNISIM;
use UNISIM.VComponents.all;

use work.Component_Defs.all;
use work.video_defs.all;

entity toplevel_wiidual is
  generic (
    TargetConsole: string; -- "WII"
    SwapRed      : string := "NO";
    SwapGreen    : string := "NO";
    SwapBlue     : string := "NO";
    Firmware     : string;
    Module       : string
  );
  port (
    -- clocks
    VClockN    : in  std_logic;

    -- gamecube video signals
    VData      : in  std_logic_vector(7 downto 1);
    VData0Old  : in  std_logic;
    VData0New  : in  std_logic;
    CSel       : in  std_logic; -- usually named ClkSel, but it's really a color select
    CableDetect: out std_logic;

    -- console audio signals
    I2S_BClock : in  std_logic;
    I2S_LRClock: in  std_logic;
    I2S_Data   : in  std_logic;

    -- gamecube controller
    PadData    : in  std_logic;

    -- IR receiver
    IRReceiver : in  std_logic;
    IRButton   : in  std_logic;

    -- flash chip
    Flash_COPI : out std_logic;
    Flash_CIPO : in  std_logic;
    Flash_SCK  : out std_logic;
    Flash_SEL  : out std_logic;

    -- board-internal
    LED        : out std_logic;

    -- audio out
    SPDIF_Out  : out std_logic;

    -- digital video out
    DVI_Clock  : out   std_logic_vector(1 downto 0);
    DVI_Red    : out   std_logic_vector(1 downto 0);
    DVI_Green  : out   std_logic_vector(1 downto 0);
    DVI_Blue   : out   std_logic_vector(1 downto 0);

    -- analog video out
    DAC_Red    : out   std_logic_vector(7 downto 0);
    DAC_Green  : out   std_logic_vector(7 downto 0);
    DAC_Blue   : out   std_logic_vector(7 downto 0);
    DAC_SyncN  : out   std_logic;
    DAC_Clock  : out   std_logic;
    CSync_out  : out   std_logic
  );
end toplevel_wiidual;

architecture Behavioral of toplevel_wiidual is
  signal is_new_board   : boolean := true;
  signal vdata_internal : std_logic_vector(7 downto 0);
  signal csel_delay     : std_logic;
  signal vd0old_prev    : std_logic;
  signal vd0new_prev    : std_logic;
  signal pipe_clock     : std_logic;
  signal video_vsync    : std_logic;
  signal heartbeat_vsync: std_logic;
  signal cable_detect   : std_logic;
  signal swap_red       : Pair_Swap_t;
  signal swap_green     : Pair_Swap_t;
  signal swap_blue      : Pair_Swap_t;
  signal dac_rgbmode    : boolean;
  signal out_red        : std_logic_vector(7 downto 0);
  signal out_green      : std_logic_vector(7 downto 0);
  signal out_blue       : std_logic_vector(7 downto 0);

begin

  swap_red   <= Pair_Regular when SwapRed   = "NO" else Pair_Swapped;
  swap_green <= Pair_Regular when SwapGreen = "NO" else Pair_Swapped;
  swap_blue  <= Pair_Regular when SwapBlue  = "NO" else Pair_Swapped;

  -- data pipe
  Inst_Datapipe: Datapipe generic map (
    TargetConsole => TargetConsole,
    Firmware      => Firmware,
    Module        => Module
  ) port map (
    VClockN     => VClockN,
    VData       => vdata_internal,
    CSel        => csel_delay,
    CableDetect => cable_detect,
    I2S_BClock  => I2S_BClock,
    I2S_LRClock => I2S_LRClock,
    I2S_Data    => I2S_Data,
    PadData     => PadData,
    IRReceiver  => IRReceiver,
    IRButton    => IRButton,
    Flash_COPI  => Flash_COPI,
    Flash_CIPO  => Flash_CIPO,
    Flash_SCK   => Flash_SCK,
    Flash_SEL   => Flash_SEL,
    PipeClock   => pipe_clock,
    DAC_RGBMode => dac_rgbmode,
    SPDIF_Out   => SPDIF_Out,
    DAC_Red     => DAC_Red,
    DAC_Green   => DAC_Green,
    DAC_Blue    => DAC_Blue,
    DAC_SyncN   => DAC_SyncN,
    DAC_Clock   => DAC_Clock,
    CSync_out   => CSync_out,
    VSync_out   => video_vsync,
    ForceYPbPr  => '1', -- not forced
    Pair_Red    => swap_red,
    Pair_Green  => swap_green,
    Pair_Blue   => swap_blue,
    DVI_Clock   => DVI_Clock,
    DVI_Red     => DVI_Red,
    DVI_Green   => DVI_Green,
    DVI_Blue    => DVI_Blue
  );

  CableDetect <= cable_detect;

  -- use the VData0 pin that has activity
  process(pipe_clock)
  begin
    if rising_edge(pipe_clock) then
      vd0old_prev <= VData0Old;
      vd0new_prev <= VData0New;
      csel_delay  <= CSel;

      if vd0old_prev /= VData0Old then
        is_new_board <= false;
      elsif vd0new_prev /= VData0New then
        is_new_Board <= true;
      end if;

      if is_new_board then
        vdata_internal <= VData & VData0New;
      else
        vdata_internal <= VData & VData0Old;
      end if;
    end if;
  end process;

  -- heartbeat on LED
  Inst_Heartbeat: LED_Heartbeat port map (
    Clock           => pipe_clock,
    VSync           => video_vsync,
    HeartbeatVSync2 => heartbeat_vsync
  );

  LED <= heartbeat_vsync;

end Behavioral;
