ikorb/gcvideo/HDL/gcvideo_dvi/src/zpupkg.vhd

-- ZPU
--
-- Copyright 2004-2008 oharboe - �yvind Harboe - oyvind.harboe@zylin.com
--
-- The FreeBSD license
--
-- Redistribution and use in source and binary forms, with or without
-- modification, are permitted provided that the following conditions
-- are met:
--
-- 1. Redistributions of source code must retain the above copyright
--    notice, this list of conditions and the following disclaimer.
-- 2. Redistributions in binary form must reproduce the above
--    copyright notice, this list of conditions and the following
--    disclaimer in the documentation and/or other materials
--    provided with the distribution.
--
-- THIS SOFTWARE IS PROVIDED BY THE ZPU PROJECT ``AS IS'' AND ANY
-- EXPRESS OR IMPLIED WARRANTIES, INCLUDING, BUT NOT LIMITED TO,
-- THE IMPLIED WARRANTIES OF MERCHANTABILITY AND FITNESS FOR A
-- PARTICULAR PURPOSE ARE DISCLAIMED. IN NO EVENT SHALL THE
-- ZPU PROJECT OR CONTRIBUTORS BE LIABLE FOR ANY DIRECT,
-- INDIRECT, INCIDENTAL, SPECIAL, EXEMPLARY, OR CONSEQUENTIAL DAMAGES
-- (INCLUDING, BUT NOT LIMITED TO, PROCUREMENT OF SUBSTITUTE GOODS
-- OR SERVICES; LOSS OF USE, DATA, OR PROFITS; OR BUSINESS INTERRUPTION)
-- HOWEVER CAUSED AND ON ANY THEORY OF LIABILITY, WHETHER IN CONTRACT,
-- STRICT LIABILITY, OR TORT (INCLUDING NEGLIGENCE OR OTHERWISE)
-- ARISING IN ANY WAY OUT OF THE USE OF THIS SOFTWARE, EVEN IF
-- ADVISED OF THE POSSIBILITY OF SUCH DAMAGE.
--
-- The views and conclusions contained in the software and documentation
-- are those of the authors and should not be interpreted as representing
-- official policies, either expressed or implied, of the ZPU Project.

library ieee;
use ieee.std_logic_1164.all;
use ieee.numeric_std.all;


package zpupkg is

  -- This bit is set for read/writes to IO
  -- FIX!!! eventually this should be set to wordSize-1 so as to
  -- to make the address of IO independent of amount of memory
  -- reserved for CPU. Requires trivial tweaks in toolchain/runtime
  -- libraries.

  constant wordPower       : integer                      := 5;
  -- during simulation, set this to '0' to get matching trace.txt
  constant DontCareValue   : std_logic                    := 'X';
  constant maxAddrBitBRAMLimit : integer := 13; -- Address up to 64K of program ROM.  Note, this is a maximum size and the actual size will be specified in generics.

  constant byteBits   : integer := wordPower-3;  -- # of bits in a word that addresses bytes
  constant wordSize   : integer := 2**wordPower;
  constant wordBytes  : integer := wordSize/8;
  constant minAddrBit : integer := byteBits;


  ------------------------------------------------------------
  -- components

  component dualport_ram is
    port (
      clk             : in  std_logic;
      memAWriteEnable : in  std_logic;
      memAAddr        : in  std_logic_vector(maxAddrBitBRAMLimit downto minAddrBit);
      memAWrite       : in  std_logic_vector(wordSize-1 downto 0);
      memARead        : out std_logic_vector(wordSize-1 downto 0);
      memBWriteEnable : in  std_logic;
      memBAddr        : in  std_logic_vector(maxAddrBitBRAMLimit downto minAddrBit);
      memBWrite       : in  std_logic_vector(wordSize-1 downto 0);
      memBRead        : out std_logic_vector(wordSize-1 downto 0)
      );
  end component dualport_ram;

	type ZPU_ToROM is record
		memAWriteEnable : std_logic;
		memAAddr : std_logic_vector(maxAddrBitBRAMLimit downto minAddrBit);
		memAWrite : std_logic_vector(wordSize-1 downto 0);
		memBWriteEnable : std_logic;
		memBAddr : std_logic_vector(maxAddrBitBRAMLimit downto minAddrBit);
		memBWrite : std_logic_vector(wordSize-1 downto 0);
	end record;
	type ZPU_FromROM is record
		memARead : std_logic_vector(wordSize-1 downto 0);
		memBRead : std_logic_vector(wordSize-1 downto 0);
	end record;


--  component trace is
--    port (
--      clk        : in std_logic;
--      begin_inst : in std_logic;
--      pc         : in std_logic_vector(maxAddrBitIncIO downto 0);
--      opcode     : in std_logic_vector(7 downto 0);
--      sp         : in std_logic_vector(maxAddrBitIncIO downto minAddrBit);
--      memA       : in std_logic_vector(wordSize-1 downto 0);
--      memB       : in std_logic_vector(wordSize-1 downto 0);
--      busy       : in std_logic;
--      intSp      : in std_logic_vector(stack_bits-1 downto 0)
--      );
--  end component trace;


  component zpu_core_flex is
  generic (
    IMPL_MULTIPLY : boolean := true; -- Self explanatory
	 IMPL_COMPARISON_SUB : boolean := true; -- Include sub and (U)lessthan(orequal)
	 IMPL_EQBRANCH : boolean := true; -- Include eqbranch and neqbranch
	 IMPL_STOREBH : boolean := true; -- Include halfword and byte writes
	 IMPL_LOADBH : boolean := true; -- Include halfword and byte reads
	 IMPL_CALL : boolean := true; -- Include call
	 IMPL_SHIFT : boolean := true; -- Include lshiftright, ashiftright and ashiftleft
	 IMPL_XOR : boolean := true; -- include xor instruction
	 REMAP_STACK : boolean := true; -- Map the stack / Boot ROM to 0x40000000, to allow pushsp, store to work.
	 EXECUTE_RAM : boolean := true; -- include support for executing code from outside the Boot ROM
	stackbit : integer := 30; -- Map stack to 0x40000000
	maxAddrBit : integer := 31; -- Address up to 64 megabytes of RAM.
	maxAddrBitExternalRAM : integer := 30; -- Max bit for Program Counter when EXECUTE_RAM is true
	maxAddrBitBRAM : integer := maxAddrBitBRAMLimit -- Specify significant bits of BRAM.
  );
    port (
      clk                 : in  std_logic;
      reset               : in  std_logic;
      enable              : in  std_logic := '1';
      in_mem_busy         : in  std_logic;
      mem_read            : in  std_logic_vector(wordSize-1 downto 0);
      mem_write           : out std_logic_vector(wordSize-1 downto 0);
      out_mem_addr        : out std_logic_vector(maxAddrBit downto 0);
      out_mem_writeEnable : out std_logic;
      out_mem_bEnable : out std_logic;
      out_mem_hEnable : out std_logic;
      out_mem_readEnable  : out std_logic;
--      mem_writeMask       : out std_logic_vector(wordBytes-1 downto 0);
      interrupt           : in  std_logic := '0';
      break               : out std_logic;
		from_rom : in ZPU_FromROM;
		to_rom : out ZPU_ToROM
      );
  end component zpu_core_flex;


  ------------------------------------------------------------
  -- constants

  -- opcode decode constants
  constant OpCode_Im               : std_logic_vector(7 downto 7) := "1";
  constant OpCode_StoreSP          : std_logic_vector(7 downto 5) := "010";
  constant OpCode_LoadSP           : std_logic_vector(7 downto 5) := "011";
  constant OpCode_Emulate          : std_logic_vector(7 downto 5) := "001";
  constant OpCode_AddSP            : std_logic_vector(7 downto 4) := "0001";
  constant OpCode_Short            : std_logic_vector(7 downto 4) := "0000";
  --
  constant OpCode_Break            : std_logic_vector(3 downto 0) := "0000";
  constant OpCode_NA4              : std_logic_vector(3 downto 0) := "0001";
  constant OpCode_PushSP           : std_logic_vector(3 downto 0) := "0010";
  constant OpCode_NA3              : std_logic_vector(3 downto 0) := "0011";
  --
  constant OpCode_PopPC            : std_logic_vector(3 downto 0) := "0100";
  constant OpCode_Add              : std_logic_vector(3 downto 0) := "0101";
  constant OpCode_And              : std_logic_vector(3 downto 0) := "0110";
  constant OpCode_Or               : std_logic_vector(3 downto 0) := "0111";
  --
  constant OpCode_Load             : std_logic_vector(3 downto 0) := "1000";
  constant OpCode_Not              : std_logic_vector(3 downto 0) := "1001";
  constant OpCode_Flip             : std_logic_vector(3 downto 0) := "1010";
  constant OpCode_Nop              : std_logic_vector(3 downto 0) := "1011";
  --
  constant OpCode_Store            : std_logic_vector(3 downto 0) := "1100";
  constant OpCode_PopSP            : std_logic_vector(3 downto 0) := "1101";
  constant OpCode_NA2              : std_logic_vector(3 downto 0) := "1110";
  constant OpCode_NA               : std_logic_vector(3 downto 0) := "1111";
  --
  constant OpCode_Loadh            : std_logic_vector(5 downto 0) := std_logic_vector(to_unsigned(34, 6));
  constant OpCode_Storeh           : std_logic_vector(5 downto 0) := std_logic_vector(to_unsigned(35, 6));
  --
  constant OpCode_Lessthan         : std_logic_vector(5 downto 0) := std_logic_vector(to_unsigned(36, 6));
  constant OpCode_Lessthanorequal  : std_logic_vector(5 downto 0) := std_logic_vector(to_unsigned(37, 6));
  constant OpCode_Ulessthan        : std_logic_vector(5 downto 0) := std_logic_vector(to_unsigned(38, 6));
  constant OpCode_Ulessthanorequal : std_logic_vector(5 downto 0) := std_logic_vector(to_unsigned(39, 6));
  --
  constant OpCode_Swap             : std_logic_vector(5 downto 0) := std_logic_vector(to_unsigned(40, 6));
  constant OpCode_Mult             : std_logic_vector(5 downto 0) := std_logic_vector(to_unsigned(41, 6));
  --
  constant OpCode_Lshiftright      : std_logic_vector(5 downto 0) := std_logic_vector(to_unsigned(42, 6));
  constant OpCode_Ashiftleft       : std_logic_vector(5 downto 0) := std_logic_vector(to_unsigned(43, 6));
  constant OpCode_Ashiftright      : std_logic_vector(5 downto 0) := std_logic_vector(to_unsigned(44, 6));
  constant OpCode_Call             : std_logic_vector(5 downto 0) := std_logic_vector(to_unsigned(45, 6));
  --
  constant OpCode_Eq               : std_logic_vector(5 downto 0) := std_logic_vector(to_unsigned(46, 6));
  constant OpCode_Neq              : std_logic_vector(5 downto 0) := std_logic_vector(to_unsigned(47, 6));
  --
  constant OpCode_Neg              : std_logic_vector(5 downto 0) := std_logic_vector(to_unsigned(48, 6));
  constant OpCode_Sub              : std_logic_vector(5 downto 0) := std_logic_vector(to_unsigned(49, 6));
  constant OpCode_Xor              : std_logic_vector(5 downto 0) := std_logic_vector(to_unsigned(50, 6));
  --
  constant OpCode_Loadb            : std_logic_vector(5 downto 0) := std_logic_vector(to_unsigned(51, 6));
  constant OpCode_Storeb           : std_logic_vector(5 downto 0) := std_logic_vector(to_unsigned(52, 6));
  --
  constant OpCode_Eqbranch         : std_logic_vector(5 downto 0) := std_logic_vector(to_unsigned(55, 6));
  constant OpCode_Neqbranch        : std_logic_vector(5 downto 0) := std_logic_vector(to_unsigned(56, 6));
  constant OpCode_Poppcrel         : std_logic_vector(5 downto 0) := std_logic_vector(to_unsigned(57, 6));
  --
  constant OpCode_Pushspadd        : std_logic_vector(5 downto 0) := std_logic_vector(to_unsigned(61, 6));
  constant OpCode_Mult16x16        : std_logic_vector(5 downto 0) := std_logic_vector(to_unsigned(62, 6));
  constant OpCode_Callpcrel        : std_logic_vector(5 downto 0) := std_logic_vector(to_unsigned(63, 6));
  --
  --
  constant OpCode_Size             : integer                      := 8;



end zpupkg;
