ikorb/gcvideo/Firmware/screen_outputsettings.c

/* GCVideo DVI Firmware

   Copyright (C) 2015-2021, Ingo Korb <ingo@akana.de>
   All rights reserved.

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
   1. Redistributions of source code must retain the above copyright notice,
      this list of conditions and the following disclaimer.
   2. Redistributions in binary form must reproduce the above copyright notice,
      this list of conditions and the following disclaimer in the documentation
      and/or other materials provided with the distribution.

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

   screen_outputsettings.c: Screen for output-related settings

*/

#include <stdbool.h>
#include <stddef.h>
#include "colormatrix.h"
#include "menu.h"
#include "osd.h"
#include "pad.h"
#include "portdefs.h"
#include "screens.h"
#include "settings.h"

enum {
  MENUITEM_CABLEDETECT,
  MENUITEM_CROP486,
  MENUITEM_LIMITEDRGB,
  MENUITEM_DVIENHANCED,
  MENUITEM_169,
  MENUITEM_VOLUME,
  MENUITEM_MUTE,
  MENUITEM_ANALOGOUT
  // _EXIT as #define because ANALOGOUT doesn't always exist
};

#ifdef OUTPUT_DUAL
#  define HAVE_DUAL 1
#  define MENUITEM_EXIT (MENUITEM_ANALOGOUT + 1)
#else
#  define HAVE_DUAL 0
#  define MENUITEM_EXIT (MENUITEM_ANALOGOUT)
#endif

/* --- getters and setters --- */

static int get_dvienhanced(void) { return video_settings_global & VIDEOIF_SET_DVIENHANCED; }
static int get_volume(void)      { return audio_volume;                                    }
static int get_mute(void)        { return audio_mute;                                      }

static int get_analogmode(void) {
  uint32_t val = (video_settings_global & VIDEOIF_SET_ANALOG_MASK)
    >> VIDEOIF_SET_ANALOG_SHIFT;
  if (val == 3)
    return 2;
  else
    return val;
}

static bool set_dvienhanced(int value) {
  set_all_modes(VIDEOIF_SET_DVIENHANCED, value);
  if (!value) {
    /* reset to RGB mode */
    set_all_modes(VIDEOIF_SET_COLORMODE_MASK, false);
    VIDEOIF->osd_bg = osdbg_settings;
    update_colormatrix();
  }
  return true;
}

static bool set_volume(int value) {
  audio_volume = value;
  if (!audio_mute)
    VIDEOIF->audio_volume = value;
  return false;
}

static bool set_mute(int value) {
  audio_mute = value;
  if (audio_mute)
    VIDEOIF->audio_volume = 0;
  else
    VIDEOIF->audio_volume = audio_volume;
  return false;
}

static bool set_analogmode(int value) {
  if (value == 2)
    value = 3;
  set_all_modes(VIDEOIF_SET_ANALOG_MASK, false);
  set_all_modes(value << VIDEOIF_SET_ANALOG_SHIFT, true);
  return false;
}

static valueitem_t value_cabledetect = { VALTYPE_BOOL, true,
                                         { .field = { NULL, VIDEOIF_BIT_CABLEDETECT, 0, VIFLAG_ALLMODES }} };
static valueitem_t value_crop486     = { VALTYPE_BOOL, true,
                                         { .field = { &crop_486_to_480, 8, 24, 0 }} };
static valueitem_t value_rgblimited  = { VALTYPE_BOOL, true,
                                         { .field = { NULL, VIDEOIF_BIT_COLOR_RGBLIMITED, 0, VIFLAG_ALLMODES | VIFLAG_COLORMATRIX }} };
static valueitem_t value_169         = { VALTYPE_BOOL, true,
                                         { .field = { NULL, VIDEOIF_BIT_169, 0, VIFLAG_ALLMODES }} };
static valueitem_t value_dvienhanced = { VALTYPE_BOOL, false, {{ get_dvienhanced, set_dvienhanced }} };
static valueitem_t value_volume      = { VALTYPE_BYTE, false, {{ get_volume,      set_volume      }} };
static valueitem_t value_mute        = { VALTYPE_BOOL, false, {{ get_mute,        set_mute        }} };

static valueitem_t __attribute__((unused)) value_analogmode =
  { VALTYPE_ANALOGMODE, false, {{ get_analogmode, set_analogmode }} };

/* --- menu definition --- */

static void outputset_draw(menu_t *menu);

#ifdef OUTPUT_DUAL
static menuitem_t outputset_items[] = {
  { "Allow 480p Mode",   &value_cabledetect, 1, 0 }, // 0
  { "Crop 486 to 480",   &value_crop486,     2, 0 }, // 1
  { "RGB Limited Range", &value_rgblimited,  3, 0 }, // 2
  { "Enhanced DVI Mode", &value_dvienhanced, 4, 0 }, // 3
  { "  Display as 16:9", &value_169,         5, 0 }, // 4
  { "Volume",            &value_volume,      6, 0 }, // 5
  { "Mute",              &value_mute,        7, 0 }, // 6
  { "Analog Output",     &value_analogmode,  8, 0 }, // 7
  { "Exit",              NULL,              10, 0 }, // 8
};

static menu_t outputset_menu = {
  9, 9,
  26, 12,
  outputset_draw,
  sizeof(outputset_items) / sizeof(*outputset_items),
  outputset_items
};
#else
static menuitem_t outputset_items[] = {
  { "Allow 480p Mode",   &value_cabledetect, 1, 0 }, // 0
  { "Crop 486 to 480",   &value_crop486,     2, 0 }, // 1
  { "RGB Limited Range", &value_rgblimited,  3, 0 }, // 2
  { "Enhanced DVI Mode", &value_dvienhanced, 4, 0 }, // 3
  { "  Display as 16:9", &value_169,         5, 0 }, // 4
  { "Volume",            &value_volume,      6, 0 }, // 5
  { "Mute",              &value_mute,        7, 0 }, // 6
  { "Exit",              NULL,               9, 0 }, // 7
};

static menu_t outputset_menu = {
  9, 9,
  26, 11,
  outputset_draw,
  sizeof(outputset_items) / sizeof(*outputset_items),
  outputset_items
};
#endif

static void outputset_draw(menu_t *menu) {
  if (video_settings_global & VIDEOIF_SET_TEST_YCBCR) {
    outputset_items[MENUITEM_LIMITEDRGB].flags = MENU_FLAG_DISABLED;
  } else {
    outputset_items[MENUITEM_LIMITEDRGB].flags = 0;
  }

  if (video_settings_global & VIDEOIF_SET_DVIENHANCED) {
    outputset_items[MENUITEM_169].flags = 0;
  } else {
    outputset_items[MENUITEM_169].flags = MENU_FLAG_DISABLED;
  }

  if (HAVE_DUAL) {
    if (VIDEOIF->flags & VIDEOIF_FLAG_FORCE_YPBPR) {
      outputset_items[MENUITEM_ANALOGOUT].flags = MENU_FLAG_DISABLED;
    } else {
      outputset_items[MENUITEM_ANALOGOUT].flags = 0;
    }
  }

  /* some boards do not have cable detect connected */
#ifdef DISABLE_CABLEDETECT
  outputset_items[MENUITEM_CABLEDETECT].flags = MENU_FLAG_DISABLED;
#endif
}

void screen_outputsettings(void) {
  osd_clrscr();
  menu_draw(&outputset_menu);
  menu_exec(&outputset_menu, 0);
}
