ikorb/gcvideo/Firmware/crc32mpeg.c

/**
 * \file crc32mpeg.c
 * Functions and types for CRC checks.
 *
 * Generated on Wed Oct  2 18:38:00 2019,
 * by pycrc v0.9, https://pycrc.org
 * using the configuration:
 *    Width         = 32
 *    Poly          = 0x04c11db7
 *    Xor_In        = 0xffffffff
 *    ReflectIn     = False
 *    Xor_Out       = 0x00000000
 *    ReflectOut    = False
 *    Algorithm     = table-driven
 *****************************************************************************/
#include "crc32mpeg.h"     /* include the header file generated with pycrc */
#include <stdlib.h>
#include <stdint.h>

/**
 * Static table used for the table_driven implementation.
 *****************************************************************************/
static const crc_t crc_table[256] = {
    0x00000000, 0x04c11db7, 0x09823b6e, 0x0d4326d9, 0x130476dc, 0x17c56b6b, 0x1a864db2, 0x1e475005,
    0x2608edb8, 0x22c9f00f, 0x2f8ad6d6, 0x2b4bcb61, 0x350c9b64, 0x31cd86d3, 0x3c8ea00a, 0x384fbdbd,
    0x4c11db70, 0x48d0c6c7, 0x4593e01e, 0x4152fda9, 0x5f15adac, 0x5bd4b01b, 0x569796c2, 0x52568b75,
    0x6a1936c8, 0x6ed82b7f, 0x639b0da6, 0x675a1011, 0x791d4014, 0x7ddc5da3, 0x709f7b7a, 0x745e66cd,
    0x9823b6e0, 0x9ce2ab57, 0x91a18d8e, 0x95609039, 0x8b27c03c, 0x8fe6dd8b, 0x82a5fb52, 0x8664e6e5,
    0xbe2b5b58, 0xbaea46ef, 0xb7a96036, 0xb3687d81, 0xad2f2d84, 0xa9ee3033, 0xa4ad16ea, 0xa06c0b5d,
    0xd4326d90, 0xd0f37027, 0xddb056fe, 0xd9714b49, 0xc7361b4c, 0xc3f706fb, 0xceb42022, 0xca753d95,
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
{
    const unsigned char *d = (const unsigned char *)data;
    unsigned int tbl_idx;

    while (data_len--) {
        tbl_idx = ((crc >> 24) ^ *d) & 0xff;
        crc = (crc_table[tbl_idx] ^ (crc << 8)) & 0xffffffff;

        d++;
    }
    return crc & 0xffffffff;
}
