ikorb/gcvideo/(commit log)

2014-08-31 Import initial release
    [BOM.csv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]
2014-08-31 Add schematics PDF
2014-09-11 Optimize YCbCr to RGB conversion
    Optimize the YCbCr to RGB conversion by clocking it at twice the pixel
    rate so intermediate registers can be reused from odd to even
    conversion stages.
2014-09-21 Fix project description in gcvl64 copyright headers
    [component_defs.vhd, convert_rgb_to_ycbcr.vhd, delayline_bool.vhd, n64v_decoder.vhd, video_defs.vhd]
2014-09-27 Remove superfluous D7 pin from N64 connection list
2014-12-03 Add GCVideo DVI for the Pluto IIx HDMI board
    Add a DVI-output version of GCVideo running on the Pluto IIx HDMI
    board from KNJN and documentation about its installation.
2014-12-09 Try to make BOM.csv look nice on github
    [BOM.csv]
2015-05-17 Fix typo in comment
    [PadReader.vhd]
2015-11-22 gcvideo-DVI: Fix one-pixel-early Syncs in aux periods
    Fix a one-pixel-too-early bug for the sync signals in aux periods
    which caused one-pixel line jitters on lines with two data packets on
    certain Sony TVs.
    [dvid.vhd]
2015-11-22 Rename gcvideo_dvi_p2xh to gcvideo_dvi
    Rename the gcvideo_dvi_p2xh directory to gcvideo_dvi because the code
    in there can be synthesized for more than just the Pluto IIx board
    nowadays. Also provide a symlink in an attempt to keep external links
    to the Github repository working.
2016-03-05 GCVideo DVI: Add build for Shuriken Video v3/v4 boards
2016-06-21 Reduce size of infoframe ROM
    Optimize the layout of the infoframe ROM by reducing redundancies and
    changing the address sequencing to match the new layout. This change
    also allows the inclusion of an alternate ACR packet for 48000Hz audio.
2016-06-21 Improve DCM reset on clock loss/instability
    Implement improved DCM reset functionality when it loses lock or
    stops completely to survive mode switches on the Wii.
    [ClockGen.vhd]
2016-06-21 ZPUBusMux: Use '-' instead of '0' for default device data
    Give the optimizer a bit more leeway by specifying that the default
    device may return anything instead of forcing 0-bits on the bus.
2016-06-21 Minor whitespace, case and other non-functional changes
    Sprinkle a bit of vertical alignment, case changes and a few other
    non-functional changes around the code.
2016-06-21 Reduce size of PadReader
    Reduce the size of the PadReader module by exposing the contents of
    the shift register only one byte at a time and changing the firmware
    to match. This allows the use of LUTs as shift registers instead of
    using just the slice flipflops.
    [PadReader.vhd, pad.c, portdefs.h]
2016-08-12 Add console mode detection for Wii
    Add a detection of Cube vs. Wii mode when GCVideo-DVI is built for the
    Wii. This is needed since Nintendo has fixed an off-by-one error in
    the hardware so that the Wii uses exactly 48000Hz audio sample rate,
    but that fix is disabled in Gamecube mode and thus the sample rate
    shifts to 48042Hz there.
    [ConsoleModeDetect.vhd, component_defs.vhd, toplevel_p2xh.vhd, video_defs.vhd]
2016-08-12 Don't pull cable detect low on a Wii
    Use Z/1 with a pulldown instead of 0/1 for the cable detect pin on the
    Wii because an externally connected component cable may connect the
    detect line directly to 3.3V while the FPGA pin tries to output a 0.
2016-08-12 Update audio subsystem for Wii
    Add the necessary updates to the audio subsystem for the Wii:
    - use 384*f_s instead of 128*f_s for more reliable I2S decoding
    (the Wii uses a 64*f_s bit clock, reading that with a jittering
    128*f_s logic clock is unreliable)
    - switch between 48000 and 48042 Hz sample rate depending on the
    console mode
    [SPDIF_Encoder.vhd, audio_spdif.vhd, component_defs.vhd, i2s_decoder.vhd, toplevel_p2xh.vhd, toplevel_shuriken.vhd]
2016-08-12 Change ACR packet depending on the console mode
    Since the ACR packet content depends on the sample rate, it must
    change depending on the console mode when connected to a Wii. This
    patch adds the necessary address bit toggle, the second ACR packet was
    already added in the infoframe ROM reoganization.
2016-08-12 Show target console and current mode in about screen
    Forward the TargetConsole setting and current_mode flag to the ZPU
    subsystem to allow the firmware to show both the intended console and
    its mode in the about screen.
2016-08-12 Fix item marker not showing on decimal values
    Fix the missing item marker not showing up when a decimal value is
    selected by moving it one character further to the left.
    [menu.c]
2016-08-12 Report only activity of enabled interrupts
    Report only the interrupts that are both enabled and currently active
    when reading from the IRQ controller so the IRQ service loop only
    calls the handlers whose interrupts are enabled.
2016-08-14 Add IR remote control capability
    Add all the infrastructure for decoding IR remotes using the NEC
    protocol to add an alternative way of controlling the OSD in case a
    Gamecube pad is not available/practical.
2016-08-15 Update description of LEDs in README
    Update the description of the behaviour of the two LEDs on the Pluto
    board because the Wii version of GCVideo-DVI now uses one to show the
    current console mode.
2016-09-20 Fix wrong ZPUIRQController bit assignment
    Remove a spurious "+1" that shifted all flags in the read path of the
    ZPUIRQController over by one bit. Fixes ZPU crashes on startup, no
    idea how it ever worked at all.
    [ZPUIRQController.vhd]
2016-09-20 Define IR receiver+button pins for Shuriken Video
    Add IR receiver capability to the two Shuriken Video boards.
2016-09-20 Update NEWS file
    Oops, I completely forgot that this repository has a NEWS file at its
    root. Finally updated for the current release.
2016-12-29 GCVideo-DVI: Add Wii builds for both shuriken boards
2017-09-10 Call firmware makefile from HDL makefile to build correct firmware version
    [CPUSubsystem.vhd, ZPUDevices.vhd, component_defs.vhd, toplevel_p2xh.vhd, toplevel_shuriken.vhd, zpu_rom.vhd]
2017-09-19 Generate final UCF file from snippets
    Add a UCF file generation step to GCVideo-DVI that concatenates
    snippes for common, console-specific and board-specific constraints to
    redude duplication between the previous board+console-specific UCF files.
2017-09-19 Implement a better heartbeat pattern
    Improve the heartbeat LED patterns of GCVideo-DVI by basing it both on
    the main clock and VSync. The patterns are chosen so one can be used
    to invert the other to derive a useful single-LED pattern.
    [component_defs.vhd, led_heartbeat.vhd, toplevel_p2xh.vhd]
2017-09-21 GCVideo-DVI: Add Dual-GC/Dual-Wii boards
    Add support for citrus3000psi's dual-output GCVideo boards for
    Gamecube and Wii.
2017-10-03 Improve syncing of signals from video to audio clock domain
    Implement more synchronisation flipflops for the signals flowing from
    the video to the audio clock domain and re-enable the corresponding
    timing ignore constraint. This avoids a few non-met timing constraints
    for the Wii builds and hopefully does not cause audio issues on
    Dual-GC again.
    [audio_spdif.vhd]
2017-10-22 Add section about 3d printed mount
2017-10-22 Reformat and disclaimerize mounting section
    Reformat the mounting section to stay within the same line length as
    the rest of the file and disclaimerize it a bit to make it not look
    like a blatant ad for a specific 3D printing service provider.
2017-12-10 Remove the video->audio TIG constraint
    According to reports, the version with the TIG constraint suffers from
    audio noise on some FPGA boards, so it appears that some path is
    under-constrained/not properly synched without it. Removing the TIG
    does not cause any timing errors to pop up anymore after splitting the
    clock enable counters in the audio subsystem.
2018-09-14 Fix chroma shift and bump version to 2.4b
    [screen_about.c]
2019-05-31 backport chroma mixing fix for Cr-first lines
    [convert_422_to_444.vhd]
2020-01-12 document fake bitstream workaround for FPGAconf
    Document where to find fake bitstream files for programming GCVideo
    3.0 to a Pluto board using FPGAconf.
2020-01-13 fix calculation of settings slot when storing settings
    Fix the calculation of the correct settings slot when storing
    settings, avoids various nasty flash corruption problems.
    [settings-main.c]
2020-01-19 fix TMDS pair swapping for Wii-Dual
    Fix incorrect TMDS pair swapping in the Wii-Dual configuration and
    make the pair swap configuration more flexible.
    [toplevel_dual.vhd, toplevel_p2xh.vhd, toplevel_shuriken.vhd]
2020-01-19 gcdv_decoder: Add a second buffer stage to the input
    Buffer the input data in two stages in the gcdv_decoder module for
    additional paranoia. (was originally meant for a different clocking
    scheme that was dropped again)
2020-01-19 ClockGen: Add another DCM in the chain
    Add another DCM in front of the clock generation chain that
    regenerates a 54MHz clock from the input in a feeble attempt to clean
    minor clock glitches if the board installation is not optimal.
    [ClockGen.vhd]
2020-01-19 Add a VSync-only LED heartbeat signal
    Add a heartbeat signal that only depends on VSyncs without counting
    the system clock as a low-resource alternative.
2020-01-20 Fix disable-logic on mode change
    Fix the logic for temporarily disabling the output on mode changes to
    ensure that it always counts down the frame counter even if the
    console switches back to the previous mode before the intended number
    of disable frames is reached.
    [reblanker.c]
2020-01-25 add a variable to change the cost table in Makefile.common
    Make it possible to easily change the current cost table used during
    synthesis in case something decides to fail timing again.
2020-01-28 flasher: fix handling of uncompressed chunks
    [flasher.c]
2020-02-02 add a diagnostics mode to the flasher
    Add a small hardware-supported diagnostic mode to the flasher to
    detect some issues with VData and audio wiring.
    [CPUSubsystem.vhd, ZPUDevices.vhd, ZPUSignalDiag.vhd, component_defs.vhd, datapipe.vhd, flasher-diag.c, flasher-diag.h, flasher.c]
2020-02-10 remove analog color channel swap on WiiDual
    As it tourns out, the analog color channel swap was not actually used
    in the release WiiDual hardware, instead users are advised to use an
    RGB cable with non-standard pinout.
    [toplevel_dual.vhd]
2020-02-10 Fix WiiDual pin assignments
    The included WiiDual pin assignments were for an almost-but-not-quite
    release version of the board, the final version has three differences
    which are fixed by this commit.
2020-05-21 Implement a better DCM reset method for Wii
    Change the DCM reset procedure so it waits until a few edges are seen
    on BClock before releasing the DCM from reset. This delays startup of
    the DCM long enough to avoid a period where the Wii main clock
    switches to 27MHz after power-on or boot from standby which led to
    loss of DCM lock.
    TO ensure that this delay is also applied upon power-on, the startup
    settings are modified to not wait for DCM lock anymore and the faster
    config rate is activated again as the problematic time interval can
    now be avoided more accurately.
    [ClockGen.vhd, component_defs.vhd, datapipe.vhd]
2020-05-21 updater: Generate faint white noise when update data is shown
    Generate a very faint white noise in the background while the update
    data is shown to ensure that there is traffic on the ADATA
    signal. This ensures that the diagnostics mode of the flasher does not
    show "missing or silence" anymore while the other signals are shown as OK.
    [main.c]
2020-05-21 Use runtime detection of VData0 pin in dual-wii configuration
    Based on user reports, it appears that there are Wii Dual boards with
    two different pinouts in the wild, the main difference being a
    different pin for VData0. To avoid user confusion, detect the correct
    pin dynamically at runtime by latching onto the one that toggles.
    [toplevel_gcdual.vhd, toplevel_wiidual.vhd]
2020-08-12 Update terminology
    Update some of the terminology used in the code to current standards,
    primarily related to SPI signal names.
2020-11-28 deprecate Pluto board for end-users
2020-12-01 reduce screen_irconfig size
    Optimize the size of screen_irconfig by removing the debug mode and
    implementing the button list in a more space-efficient way.
2020-12-01 printf.c: reduce code size
    Reduce the code size of prinf by removing octal and pointer output and
    replacing switch/case with if cascades.
2020-12-01 screen_mainmenu: Use constants for menu size and position
    Replace some magic numbers in the code by constants that define the
    size and position of the main menu. Should reduce code size slightly
    because some calculations are now compile-time instead of run-time.
    [screen_mainmenu.c]
2020-12-01 Fix delayline_bool/_unsigned low delay instances
    Generate correct code for 0 or 1 pixels of delay
    [convert_422_to_444.vhd, delayline_bool.vhd, delayline_unsigned.vhd]
2020-12-01 dvid: Change audio subcode channel bits for enhanced mode
    Change the audio submode channel bits transmitted in enhanced DVI mode
    to use more common settings, which may or may not help with missing
    audio on some devices.
    [dvid.vhd]
2020-12-01 menu: Rename VALUE_RGBMODE to VALUE_ANALOGMODE
    Rename the VALUE_RGBMODE enum to VALUE_ANALOGMODE to make its purpose
    more clear, avoiding a possible confusion with limited/full range RGB.
    [menu.c, menu.h, screen_othersettings.c]
2020-12-01 Use enums instead of defines for the MENUITEM_* symbols
    Switch to enums instead of defines for the MENUITEM_* symbols in the
    various OSD screens to utilize the auto-numbering of enums.
2020-12-01 use a fixed mode_switch_delay
    Set a fixed three-frame mode_switch_delay because certain displays
    misdetect/ignore 240p/480i mode switches without it but the feature
    itself appears to confuse users too much.
    [screen_outputsettings.c, settings.h, vsync.c]
2020-12-01 add a low-quality audio sample rate "adjustment" for GameCube
    Add an optional hack that regularly throws away a single audio sample
    to force the Gamecube's sample rate to exactly 48kHz. Not active while
    in Wii mode.
2020-12-01 Blanking_Regenerator_Fixed: Ensure nominal length of sync pulses
    Regenerate the sync signals with their nominal lengths according to
    CEA, fixes some issues (Cr/Cb swap, flaky signal recognition) I
    observed with a cheap HDMI/SDI converter.
    [Blanking_Regenerator_Fixed.vhd]
2020-12-01 Use table-based scanline profiles instead of a strength setting
    Switch the scanline settings from a simple strength value to a
    table-based system that uses the pixel luma to determine scanline
    strength. The new implementation offers three profiles (plus "off") to
    cover multiple use cases and because that happens to be a convenient
    amount to store in BRAM or config flash.
2020-12-01 PadReader: Use separate timeouts for reply and end-of-message
    Split the timeout detection in the gamepad reader to allow for a
    longer delay before the pad replies. This should fix issues with
    GC+-based solutions which sometimes need a very long time before
    replying to the console's command.
    [PadReader.vhd]
2020-12-01 Increase SPI read speed
    Increase the effective SPI read speed by increasing the clock rate and
    by using CPU wait states instead of polling for the busy flag.
2020-12-01 Add software access to the Spartan3A ICAP module
    Add ICAP register access to the SPI module (because both SPI and ICAP
    are pretty small) and add a bit of software-side infrastructure to
    access ICAP registers.
2020-12-01 Add an "Update firmware" menu to the about screen
    Add a small menu to the about screen that allows rebooting in a
    firmware updater which is not available yet, so it effectively only
    reboots GCVideo.
    [screen_about.c]
2020-12-01 Replace fixed color conversion with a software-controlled matrix
    Replacee the fixed YUV-to-RGB color converter with a (partial) matrix
    multiplication module that also replaces the picture controls.
    [CPUSubsystem.vhd, ZPUDevices.vhd, ZPUVideoInterface.vhd, colormatrix.c, colormatrix.h, colormatrix.vhd, component_defs.vhd, datapipe.vhd]
2020-12-01 picturesettings: Reset to previous unless user selects save+exit
    Reset the picture settings to their previous values unless the user
    specifically selects the "Save and Exit" menu item because the new
    implementation makes it possible to select values that result in an
    unreadable OSD.
    [screen_picturesettings.c]
2020-12-01 Switch to a software-configured blanking regenerator
    Change the blanking regenerator from a hardcoded one to one configured
    by software, which enables features like auto-centering and better
    sync timing correction.
    [Blanking_Regenerator.vhd, CPUSubsystem.vhd, Linedoubler.vhd, ZPUDevices.vhd, ZPUVideoInterface.vhd, component_defs.vhd, datapipe.vhd, portdefs.h]
2020-12-01 add an option to disable chroma interpolation
    Add an option to disable the chroma interpolation in the
    4:2:2-to-4:4:4 interpolation stage for people who prefer the resulting
    color shift.
2020-12-01 generate infoframes in software instead of precalculating them
    Switch to a software-based infoframe generator for the
    video-mode-specific frames instead of supplying a full pre-generated
    list at build time.
2020-12-01 add YCbCr 4:4:4 and 4:2:2 output modes
    Add an option in the advanced menu to select YCbCr output in either
    4:4:4 or 4:2:2 format. May not work perfectly in all circumstances.
    [ZPUVideoInterface.vhd, colormatrix.c, component_defs.vhd, convert_422_to_444.vhd, datapipe.vhd, dvid.vhd, infoframe.c, menu.c]
2020-12-01 Swap analog video signals in RGB mode on Wii-Dual
    Swap the video signals around on Wii-Dual in RGB mode because Nintendo
    uses a weird pin assignment (R/Y on the same pin).
    [component_defs.vhd, datapipe.vhd, toplevel_dual.vhd]
2020-12-01 update constraints for Wii-Dual board
    Update the pin assignments for the Wii-Dual board to the ones used (as
    far as I know) by the actual release boards.
2020-12-01 datapipe: Use a central wiring block
    CHange the datapipe design to use a central "wiring block" between
    modules to make the connections more readble.
2020-12-01 add an option to switch between original or regenerated CSync
    Add an option in the advanced menu to switch between the console's
    original CSync signal or one recreated from HSync+VSync.
2020-12-01 Fix YPbPr output range
    Add a module that rescales the internal YCbCr values to work a bit
    better with a full-range DAC.
    [component_defs.vhd, datapipe.vhd, ycrange.vhd]
2020-12-01 Fix include guard in vsync.h
    Fix the include guard macro name in vsync.h
    [vsync.h]
2020-12-01 Remove obsolete FIXME comment from pad.c
    Remove an old FIXME comment in pad.c.
    [pad.c]
2020-12-01 Simplify LED pattern on dual-output boards
    Simplify the LED blinking pattern used by dual-output boards to reduce
    the size of the WiiDual configuration slightly so it fits into the
    FPGA again.
2020-12-01 add an alternate SPI module with hardware CRC support
    Add an alternate SPI module that calculates a CRC32-MPEG checksum over
    the data read from flash in hardware.
2020-12-01 add an emergency version chooser to the flasher
    Add a firmware chooser to the flasher that is triggered when the
    current hardware ID could not be determined.
2020-12-01 add a flash memory hex viewer to the flasher
    Add a hex viewer for the flash memory to the flash update tool for
    easier remote debugging in case of problems.
    [flasher.c, flashviewer.c, flashviewer.h]
2021-10-16 Fix VIC for 16:9 video modes
    The VIC for 16:9 modes is calculated by incrementing the one for 4:3,
    but this was done twice by mistake. This can confuse some sinks
    which receive a 480p signal with a VIC indicating a 720p mode, for
    example the HDMI analyzer I use chooses its OSD scaling factor using
    the VIC if available.
    [infoframe.c]
2021-10-16 fix incomplete settings reset on key combo
    Make the settings reset key combo (IR button held+Enter or
    X+Y+L+R+Start) fully reset the OSD and picture settings too instead of
    just setting the variables without updating the hardware.
    [main.c, screen_idle.c, settings-flasher.c, settings-main.c, settings.h]
2021-10-16 Modify infoframe for better compatibility
    Improve compatibility with Samsung C7000 series TVs by removing a bit
    from the infoframe that is not strictly needed. With the previous
    infoframe, these TVs would fail to show a picture after certain
    interlaced-to-progressive mode switches until the cable was physically
    re-plugged.
    [infoframe.c]
2021-10-16 Move audio subsystem to 54MHz clock domain
    Move (most of) the audio subsystem into the 54MHz clock domain to
    simplify the code a bit and hopefully reduce the need to twiddle with
    cost tables for successful synthesis. SPDIF is still in the 162MHz
    domain to reduce its jitter.
    [SPDIF_Encoder.vhd, audio_spdif.vhd, component_defs.vhd, datapipe.vhd, dvid.vhd]
